thinhdinh25/INT3108_embedded-Smart-Parking-Project/report/bao_cao_smart_parking.tex

% =====================================================================
%  BÁO CÁO KỸ THUẬT — HỆ THỐNG BÃI ĐỖ XE THÔNG MINH
%  Môn: Lập trình nhúng (INT3108) — Trường ĐH Công nghệ, ĐHQGHN
%
%  Biên dịch (khuyến nghị XeLaTeX), tại thư mục report/:
%     xelatex bao_cao_smart_parking.tex   (chạy 2 lần để có mục lục)
%  hoặc:
%     tectonic bao_cao_smart_parking.tex
%  Trên Overleaf: tải cả thư mục report/ lên, Menu -> Compiler -> XeLaTeX.
%  Nội dung từng chương nằm trong report/chapters/.
% =====================================================================
\documentclass[12pt,letterpaper]{report}
% Mẫu báo cáo của môn: Times New Roman 13pt, giãn dòng 1,3, khổ Letter
\usepackage[fontsize=13pt]{scrextend}
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
\setlength{\parskip}{3pt}
\usepackage{float}
\usepackage[section]{placeins}
\usepackage{caption}
\usepackage{subcaption}
\captionsetup{font=small,labelfont=bf}
\usepackage{fancyhdr}
\usepackage{titlesec}
\usepackage{listings}
\usepackage{needspace}
\usepackage{tikz}
\usetikzlibrary{arrows.meta,positioning,shapes.geometric,shapes.misc,fit,calc,backgrounds}
\usepackage{xurl}
\usepackage[hidelinks]{hyperref}

% Chữ và tiêu đề đen trắng; logo, mã nguồn, hình vẽ và hộp "Lý do" dùng màu.
\definecolor{uetblue}{gray}{0}
\definecolor{accent}{RGB}{0,62,126}
\definecolor{codebg}{RGB}{246,247,249}
\definecolor{codekw}{RGB}{0,82,163}
\definecolor{codecm}{RGB}{90,120,90}
\definecolor{codestr}{RGB}{163,21,21}
\definecolor{boxA}{RGB}{225,236,250}
\definecolor{boxB}{RGB}{232,245,233}
\definecolor{boxC}{RGB}{255,243,224}
\definecolor{boxD}{RGB}{252,228,236}
\definecolor{boxE}{RGB}{237,231,246}

% Tiêu đề chương theo mẫu: "CHƯƠNG 1. ...", chữ đậm 18pt, căn giữa; phụ lục "PHỤ LỤC A. ..."
\newcommand{\chapprefix}{CHƯƠNG}
\titleformat{\chapter}[block]{\centering\bfseries\fontsize{18}{23}\selectfont}{\chapprefix~\thechapter.}{0.4em}{}
\titleformat{name=\chapter,numberless}[block]{\centering\bfseries\fontsize{18}{23}\selectfont}{}{0pt}{}
\titlespacing*{\chapter}{0pt}{-12pt}{18pt}
\usepackage{titletoc}
% Mục lục như mẫu: "CHƯƠNG 1. GIỚI THIỆU ĐỀ TÀI ..... 15"
\titlecontents{chapter}[0pt]{\addvspace{8pt}\bfseries}
  {\chapprefix~\thecontentslabel.\ }{}{\titlerule*[0.6pc]{.}\contentspage}
\titleformat{\section}{\fontsize{14}{18}\selectfont\bfseries}{\thesection.}{0.6em}{}
\titleformat{\subsection}{\normalsize\bfseries}{\thesubsection.}{0.6em}{}
\titleformat{\subsubsection}{\normalsize\bfseries\itshape}{\thesubsubsection.}{0.6em}{}
\setcounter{secnumdepth}{3}

% Mẫu chỉ có số trang ở giữa chân trang, trang bìa không đánh số
\pagestyle{fancy}
\fancyhf{}
\fancyfoot[C]{\thepage}
\renewcommand{\headrulewidth}{0pt}
\fancypagestyle{plain}{\fancyhf{}\fancyfoot[C]{\thepage}\renewcommand{\headrulewidth}{0pt}}

\lstset{
  basicstyle=\ttfamily\footnotesize,
  backgroundcolor=\color{codebg},
  keywordstyle=\color{codekw}\bfseries,
  commentstyle=\color{codecm}\itshape,
  stringstyle=\color{codestr},
  numbers=left, numberstyle=\tiny\color{gray}, numbersep=6pt,
  frame=single, rulecolor=\color{gray!40},
  breaklines=true, showstringspaces=false, tabsize=4,
  xleftmargin=1.5em, framexleftmargin=1.5em,
  captionpos=b, columns=fullflexible, keepspaces=true
}
\lstdefinelanguage{json}{
  morestring=[b]", stringstyle=\color{codestr},
  literate={:}{{\textcolor{codekw}{:}}}1 {,}{{\textcolor{codekw}{,}}}1
}
\lstdefinestyle{shell}{language=bash,numbers=none,backgroundcolor=\color{black!4},
  xleftmargin=0.5em,framexleftmargin=0.5em}
\renewcommand{\lstlistingname}{Mã nguồn}
\renewcommand{\lstlistlistingname}{Danh mục mã nguồn}

\newcommand{\codeus}{\textunderscore\allowbreak}
\newcommand{\code}[1]{{\ttfamily\let\_\codeus #1}}
\setlength{\emergencystretch}{3em}
\newcommand{\file}[1]{{\ttfamily\small\let\_\codeus #1}}

% Sơ đồ Mermaid (report/diagrams/*.mmd -> *.pdf, vector):
%   \mmd[tỉ lệ rộng][tỉ lệ cao tối đa]{tên}
% Tạo lại PDF: npx -p @mermaid-js/mermaid-cli mmdc -i diagrams/x.mmd -o diagrams/x.pdf -f
\NewDocumentCommand{\mmd}{O{1} O{0.6} m}{}
% Bảng đặc tả use case: cột trái là mục, cột phải là nội dung; \bul mở một dòng gạch đầu dòng
\newcommand{\bul}{\par\noindent\hangindent=0.9em\hangafter=1 --\hspace{0.4em}}
\newenvironment{ucspec}[2]{%
  \setstretch{1.0}\small
  \begin{longtable}{|>{\raggedright\arraybackslash}p{2.8cm}|>{\raggedright\arraybackslash}p{11.6cm}|}
  \caption{#1}\label{#2}\\ \hline \hd Mục & \hd Nội dung \\ \hline \endfirsthead
  \hline \hd Mục & \hd Nội dung \\ \hline \endhead
  \hline \endlastfoot}{\end{longtable}}

% Không để dòng đơn của một đoạn nằm tách ở đầu hoặc cuối trang
\widowpenalty=10000 \clubpenalty=10000 \displaywidowpenalty=10000

\begin{document}

% =====================================================================
%  TRANG BÌA (theo mẫu Template_baocao.docx)
% =====================================================================
\begin{titlepage}
  \setstretch{1.3}\centering
  % \vspace* phải đứng trước tikzpicture: tikzpicture mở đoạn mới, \vspace* sau đó không đẩy được dòng đầu xuống
  \vspace*{0.9cm}%
  \begin{tikzpicture}[remember picture,overlay]
    \draw[black,line width=3pt] ($(current page.north west)+(3cm,-2.49cm)$)
      rectangle ($(current page.south east)+(-2cm,3cm)$);
    \draw[black,line width=1pt] ($(current page.north west)+(3.15cm,-2.64cm)$)
      rectangle ($(current page.south east)+(-2.15cm,3.15cm)$);
  \end{tikzpicture}%
  {\fontsize{12}{16}\selectfont\bfseries TRƯỜNG ĐẠI HỌC CÔNG NGHỆ\par}
  \vspace{1.4cm}
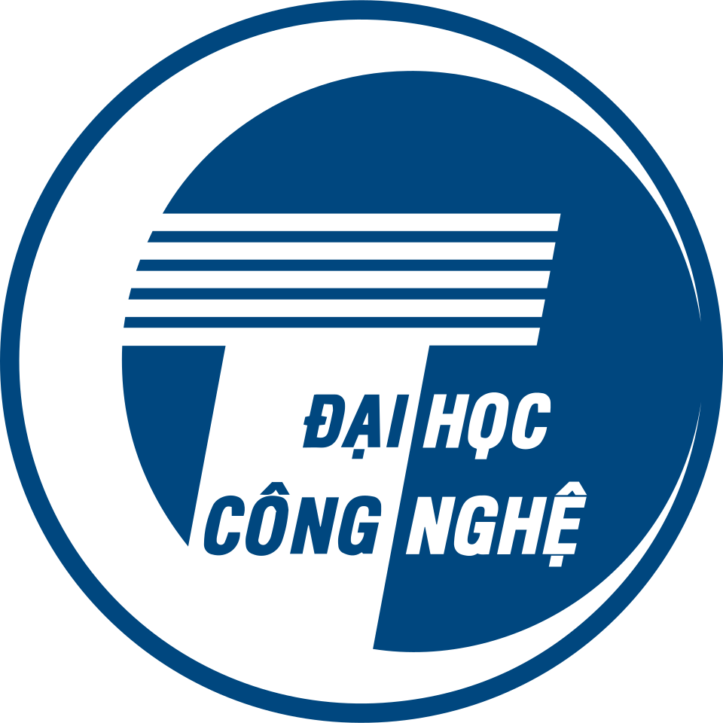
[picture p1: report/uet_logo.png]
  \par
  \vspace{1.9cm}
  {\fontsize{18}{24}\selectfont\bfseries BÁO CÁO KẾT THÚC HỌC PHẦN\par}
  {\fontsize{15}{20}\selectfont\bfseries \tenmon\par}
  \vspace{1.2cm}
  \begin{minipage}{0.86\linewidth}
    \fontsize{15}{21}\selectfont\bfseries
    Tên đề tài: \mdseries Hệ thống bãi đỗ xe thông minh sử dụng ESP32-C3 và ESP8266\par
    \vspace{0.3cm}
    \bfseries Danh sách thành viên:\par
    \mdseries
    \begin{tabular}{@{\hspace{1em}}ll@{}}
      \thanhvien
    \end{tabular}\par
    \vspace{0.3cm}
    \bfseries Giảng viên: \mdseries \giangvien\par
  \end{minipage}
  \vfill
  {\fontsize{15}{20}\selectfont\bfseries Hà Nội – 2026\par}
  \vspace{0.6cm}
\end{titlepage}

% Đánh số trang liên tục từ trang bìa như mẫu (trang bìa không in số)
\setcounter{page}{2}
\renewcommand{\contentsname}{MỤC LỤC}
\renewcommand{\listfigurename}{DANH SÁCH HÌNH VẼ}
\renewcommand{\listtablename}{DANH SÁCH BẢNG BIỂU}
\renewcommand{\bibname}{TÀI LIỆU THAM KHẢO}

\input{chapters/pl_donggop}

\chapter*{LỜI CẢM ƠN}
Nhóm xin gửi lời cảm ơn chân thành tới thầy \giangvien{}, giảng viên học phần \tenmon{},
đã tận tình giảng dạy và định hướng trong suốt quá trình học tập và thực hiện đề tài.
Những kiến thức về hệ điều hành thời gian thực, lập trình ngoại vi và giao tiếp không dây
từ học phần là nền tảng để nhóm xây dựng hệ thống bãi đỗ xe thông minh này.

Nhóm cũng cảm ơn Trường Đại học Công nghệ, Đại học Quốc gia Hà Nội đã tạo môi trường học
tập và điều kiện để nhóm thực hành, cùng các bạn trong lớp đã góp ý trong quá trình thử
nghiệm mô hình. Dù đã cố gắng, báo cáo khó tránh khỏi thiếu sót; nhóm rất mong nhận được
ý kiến đóng góp của thầy để hoàn thiện hơn.

\chapter*{LỜI CAM ĐOAN}
Nhóm xin cam đoan báo cáo và hệ thống được trình bày là kết quả làm việc của các thành viên
trong nhóm dưới sự hướng dẫn của thầy \giangvien{}. Mã nguồn, mô hình phần cứng, số liệu đo
và kết quả kiểm thử trong báo cáo là trung thực, do nhóm tự thực hiện. Các tài liệu, thư
viện và công cụ của bên thứ ba đều được ghi rõ nguồn trong báo cáo và trong phần tài liệu
tham khảo. Nhóm xin chịu hoàn toàn trách nhiệm về lời cam đoan này.

\vspace{1cm}
\noindent\hfill Hà Nội, tháng 11 năm 2026\par
\noindent\hfill Nhóm sinh viên thực hiện\hspace*{1cm}\par

\tableofcontents

\chapter*{DANH SÁCH THUẬT NGỮ VIẾT TẮT}
\addcontentsline{toc}{chapter}{DANH SÁCH THUẬT NGỮ VIẾT TẮT}
\begin{longtable}{|>{\raggedright\arraybackslash}m{2.4cm}|>{\raggedright\arraybackslash}m{11.8cm}|}
\hline
Viết tắt & Ý nghĩa \\ \hline
ACK & Acknowledgement, bản tin xác nhận đã nhận \\ \hline
ADC & Analog-to-Digital Converter, bộ chuyển đổi tương tự sang số \\ \hline
API & Application Programming Interface, giao diện lập trình ứng dụng \\ \hline
DMA & Direct Memory Access, truy cập bộ nhớ trực tiếp \\ \hline
GPIO & General Purpose Input/Output, chân vào ra đa dụng \\ \hline
HTTP(S) & HyperText Transfer Protocol (qua TLS) \\ \hline
IR & Infrared, hồng ngoại \\ \hline
JSON & JavaScript Object Notation \\ \hline
LEDC & LED Control, khối phát PWM phần cứng của ESP32 \\ \hline
mDNS & Multicast DNS, phân giải tên miền \code{.local} trong mạng cục bộ \\ \hline
NVS & Non-Volatile Storage, vùng lưu trữ khóa và giá trị trên flash \\ \hline
PWM & Pulse Width Modulation, điều chế độ rộng xung \\ \hline
RFID & Radio Frequency Identification, nhận dạng bằng sóng vô tuyến \\ \hline
RTOS & Real-Time Operating System, hệ điều hành thời gian thực \\ \hline
SPI & Serial Peripheral Interface, giao tiếp ngoại vi nối tiếp \\ \hline
TFT & Thin-Film Transistor, công nghệ màn hình tinh thể lỏng \\ \hline
UC & Use case, ca sử dụng \\ \hline
UDP & User Datagram Protocol \\ \hline
UID & Unique Identifier, mã định danh của thẻ RFID \\ \hline
VietQR & Chuẩn mã QR chuyển khoản liên ngân hàng của NAPAS \\
\hline
\end{longtable}

\cleardoublepage\phantomsection\addcontentsline{toc}{chapter}{DANH SÁCH BẢNG BIỂU}
{\setstretch{1.1}\listoftables}
\cleardoublepage\phantomsection\addcontentsline{toc}{chapter}{DANH SÁCH HÌNH VẼ}
{\setstretch{1.1}\listoffigures}

\input{chapters/c1_gioithieu}
\input{chapters/c2_coso}
\input{chapters/c3_thietke}
\input{chapters/c4_hienthuc}
\input{chapters/c5_kiemthu}
\input{chapters/kl_ketluan}

% =====================================================================
\chapter*{TÀI LIỆU THAM KHẢO}
\addcontentsline{toc}{chapter}{TÀI LIỆU THAM KHẢO}
\begin{enumerate}[label={[\arabic*]}]
\item Espressif Systems, \emph{ESP32-C3 Series Datasheet} và \emph{ESP32-C3 Technical
  Reference Manual}.
\item Espressif Systems, \emph{ESP-IDF Programming Guide} (v6.1): Wi-Fi, LEDC, SPI
  Master, LCD, NVS, HTTP Server, ESP Timer, FreeRTOS, Partition Tables.
\item Espressif Systems, \emph{mDNS component} (\code{espressif/mdns}), ESP Component
  Registry.
\item Espressif Systems, \emph{ESP8266EX Datasheet}.
\item ESP8266 Community, \emph{ESP8266 Arduino Core Documentation}.
\item Sitronix, \emph{ST7789V — 240RGB$\times$320 dot 262K Color TFT Controller}.
\item NXP Semiconductors, \emph{MFRC522 Standard Performance MIFARE and NTAG
  Frontend}, Product Data Sheet.
\item TowerPro, \emph{SG90 Micro Servo Datasheet}.
\item Aosong, \emph{DHT11 Humidity \& Temperature Sensor Datasheet}.
\item R.~Barry, \emph{Mastering the FreeRTOS Real Time Kernel}, Real Time Engineers Ltd.
\item S.~Cheshire, M.~Krochmal, \emph{RFC 6762: Multicast DNS}, IETF, 2013.
\item J.~A.~Storer, T.~G.~Szymanski, ``Data compression via textual substitution'',
  \emph{Journal of the ACM}, 29(4), 1982.
\item Thư viện \emph{MFRC522} (miguelbalboa) và \emph{DHT sensor library} (Adafruit)
  cho Arduino.
\item NAPAS, \emph{Đặc tả kỹ thuật mã QR chuyển tiền liên ngân hàng (VietQR)}, dựa trên EMVCo
  \emph{QR Code Specification for Payment Systems — Merchant-Presented Mode}.
\item SePay, \emph{SePay Developer Documentation}: API giao dịch, tài khoản ảo (VA).
\item Knowledge Sourcing Intelligence, \emph{Smart Parking Market}.
  \url{https://www.knowledge-sourcing.com/report/smart-parking-market}
\item Meticulous Research, \emph{Smart Parking Market}.
  \url{https://www.meticulousresearch.com/pressrelease/1052/smart-parking-market-2032}
\item KPS System, \emph{Giải pháp bãi giữ xe thông minh}.
  \url{https://kps.com.vn/en/tin-tuc/giai-phap-bai-giu-xe-thong-minh-399.html}
\item Hikvision, \emph{Parking Lots} và \emph{On-street Parking}.
  \url{https://www.hikvision.com/vn/solutions/solutions-by-scenario/parking-lots},
  \url{https://www.hikvision.com/vn/products/parking-management/on-street-parking/}
\item Nedap, \emph{Wireless vehicle detection system SENSIT}.
  \url{https://www.parking.net/parking-showcases/nedap-identification-systems/nedap-wireless-vehicle-detection-system-sensit-accurate-parking-occupancy-detection-system}
\item SKIDATA, \emph{The Benefits of Parking Guidance for Parking Operators}.
  \url{https://www.skidata.com/en-nordics/skidata-blog/parking-guidance-benefits-for-parking-operators}
\item FPT Shop, \emph{Có phần mềm giữ xe miễn phí nào không?}
  \url{https://fptshop.com.vn/tin-tuc/danh-gia/phan-mem-giu-xe-mien-phi-172797}
\item Việt Nam News, \emph{Hà Nội pilots iParking for cars from May} (28/3/2017) và \emph{Hà Nội expands iParking in July}.
  \url{https://vietnamnews.vn/society/373668/ha-noi-pilots-iparking-for-cars-from-may.html},
  \url{https://vietnamnews.vn/society/449045/ha-noi-expands-iparking-in-july.html}
\item VietNamNet, \emph{Hà Nội tạm dừng thí điểm mô hình trông giữ xe iParking từ 1/9}, 31/8/2020.
  \url{https://vietnamnet.vn/ha-noi-tam-dung-thi-diem-mo-hinh-trong-giu-xe-iparking-tu-19-i262776.html}
\item Mekong ASEAN, \emph{Từ 5/5 sẽ thu phí không dừng tại 5 sân bay lớn}.
  \url{https://mekongasean.vn/tu-55-se-thu-phi-khong-dung-tai-5-san-bay-lon-28091.html}
\item Tạp chí Luật sư Việt Nam, \emph{Hà Nội sẽ thu phí điện tử không dừng toàn bộ bãi đỗ xe từ ngày 01/7}, 25/5/2026.
  \url{https://lsvn.vn/ha-noi-se-thu-phi-dien-tu-khong-dung-toan-bo-bai-do-xe-tu-ngay-01-7-a173253.html}
\item Capterra, \emph{SKIDATA}. \url{https://www.capterra.com/p/141629/SKIDATA/alternatives/}
\end{enumerate}

\end{document}
