thinhdinh25/INT3108_embedded-Smart-Parking-Project/report/slides/slides.tex

% =====================================================================
%  SLIDE THUYẾT TRÌNH VÀ DEMO — HỆ THỐNG BÃI ĐỖ XE THÔNG MINH (INT3108)
%  Biên dịch tại thư mục report/slides/:   tectonic slides.tex
%  Ảnh, sơ đồ và bản vẽ dùng chung với báo cáo (../photos, ../diagrams, ../schematic).
% =====================================================================
\documentclass[aspectratio=169,11pt]{beamer}

\usepackage{fontspec}
\setsansfont{texgyreheros}[Extension=.otf,UprightFont=*-regular,
  BoldFont=*-bold,ItalicFont=*-italic,BoldItalicFont=*-bolditalic]
\setmonofont{DejaVuSansMono}[Extension=.ttf,BoldFont=*-Bold,Scale=0.86]
\usepackage[vietnamese,shorthands=off]{babel}
\usepackage{booktabs,tabularx,array}
\usepackage{tikz}
\usetikzlibrary{positioning,arrows.meta}
\graphicspath{{../}{../photos/}{../diagrams/}{../schematic/}}

% ---------- Giao diện ----------
\definecolor{uet}{RGB}{0,62,126}
\definecolor{ok}{RGB}{46,125,50}
\definecolor{warn}{RGB}{199,119,0}
\definecolor{bad}{RGB}{198,40,40}
\definecolor{soft}{RGB}{238,243,250}
\usetheme{default}
\setbeamercolor{frametitle}{fg=white,bg=uet}
\setbeamercolor{structure}{fg=uet}
\setbeamercolor{block title}{fg=white,bg=uet}
\setbeamercolor{block body}{bg=soft}
\setbeamerfont{frametitle}{size=\large,series=\bfseries}
\setbeamertemplate{navigation symbols}{}
\setbeamertemplate{itemize items}[circle]
\setbeamertemplate{blocks}[rounded][shadow=false]
\setbeamertemplate{frametitle}{%
  \nointerlineskip
  \begin{beamercolorbox}[wd=\paperwidth,ht=2.6ex,dp=1.2ex,leftskip=1.2em]{frametitle}
    \usebeamerfont{frametitle}\insertframetitle
  \end{beamercolorbox}}
\setbeamertemplate{footline}{%
  \hbox{\begin{beamercolorbox}[wd=\paperwidth,ht=2.4ex,dp=1ex,leftskip=1.2em,rightskip=1.2em]{}%
    \tiny\color{gray}INT3108 · Bãi đỗ xe thông minh\hfill\insertframenumber/\inserttotalframenumber
  \end{beamercolorbox}}}
\newcommand{\code}[1]{\texttt{#1}}
\newcommand{\bt}[1]{\rule[-0.7ex]{0pt}{3.1ex}#1}
\newcommand{\pill}[2]{\tikz[baseline=(t.base)]\node[fill=#1,text=white,rounded corners=2pt,
  inner sep=2pt,font=\scriptsize\bfseries](t){#2};}
% Bảng kẻ khung đầy đủ như trong báo cáo
\newcolumntype{L}[1]{>{\raggedright\arraybackslash}p{#1}}
\newcommand{\gridtable}{\renewcommand{\arraystretch}{1.3}}

\begin{document}

% ---------------------------------------------------------------------
\begin{frame}[plain]
\begin{tikzpicture}[remember picture,overlay]
  \fill[uet] (current page.north west) rectangle ([yshift=-4.1cm]current page.north east);
  \node[anchor=north west,inner sep=0] at ([xshift=1cm,yshift=-0.7cm]current page.north west)
    {};
  \node[anchor=north west,text=white,font=\LARGE\bfseries] at ([xshift=2.8cm,yshift=-0.75cm]current page.north west)
    {Hệ thống bãi đỗ xe thông minh};
  \node[anchor=north west,text=white!85!uet] at ([xshift=2.8cm,yshift=-1.7cm]current page.north west)
    {ESP32-C3 + ESP8266 · FreeRTOS · RFID · VietQR qua SePay};
  \node[anchor=north west,text=white!70!uet,font=\small] at ([xshift=2.8cm,yshift=-2.6cm]current page.north west)
    {Lập trình nhúng (INT3108) · GV: Trần Hoàng Việt};
  \node[anchor=south west,inner sep=0] at ([xshift=1cm,yshift=1.1cm]current page.south west) {%
    \begin{tabular}{@{}ll@{}}
      \multicolumn{2}{@{}l}{\small\color{uet}\textbf{Nhóm thực hiện}}\\[2pt]
      Nguyễn Chí Minh & 24020232 \\
      Đinh Đức Thịnh & 24020313 \\
      Nguyễn Việt Tiến & 24020322 \\
    \end{tabular}};
  \node[anchor=south east,inner sep=0] at ([xshift=-1cm,yshift=0.7cm]current page.south east)
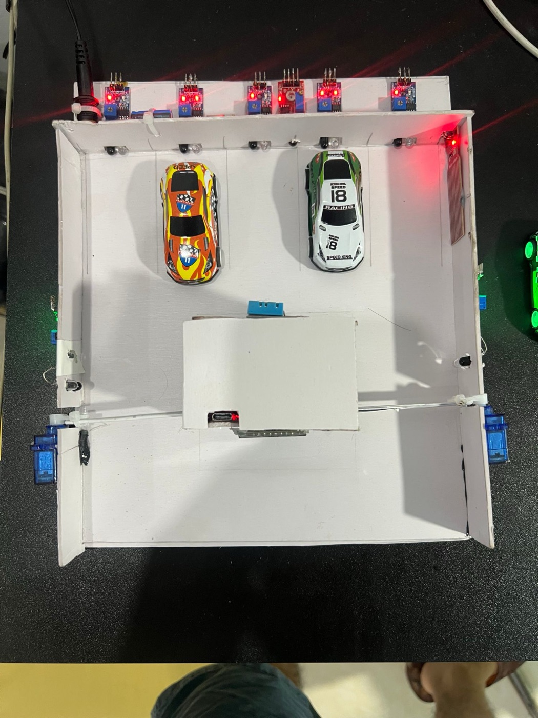
[picture p8: report/photos/model_top.jpg]
    {};
\end{tikzpicture}
\end{frame}

% ---------------------------------------------------------------------
\begin{frame}{Nội dung}
\begin{columns}[T]
\column{0.48\textwidth}
\begin{enumerate}
  \item Bài toán và mục tiêu
  \item Sản phẩm: mô hình thực tế
  \item Kiến trúc, phần cứng và mạch điện
  \item Giao thức truyền thông
\end{enumerate}
\column{0.48\textwidth}
\begin{enumerate}\setcounter{enumi}{4}
  \item 10 use case của hệ thống
  \item \textbf{Demo trực tiếp theo use case}
  \item Kiểm thử và kết quả
  \item Phân công
\end{enumerate}
\end{columns}
\end{frame}

% ---------------------------------------------------------------------
\begin{frame}{Bài toán và mục tiêu}
\begin{columns}[T]
\column{0.42\textwidth}
\begin{block}{\bt{Bãi xe nhỏ hiện nay}}
\small
\begin{itemize}
  \item Người lái không biết trước còn chỗ trống
  \item Phí gửi xe tính và thu bằng tay
  \item Cháy, ngập thường chỉ được phát hiện khi đã lan rộng
\end{itemize}
\end{block}
\vspace{6pt}
\small Sản phẩm: mô hình bãi \textbf{5 chỗ, 2 cổng có thanh chắn}, điều khiển bởi ba vi điều khiển Wi-Fi.
\column{0.55\textwidth}
\begin{block}{\bt{Mục tiêu: tự động hóa trọn vẹn một bãi xe nhỏ}}
\small
\begin{itemize}
  \item \textbf{Không cần người trực cổng:} người lái tự gửi xe, tự thanh toán VietQR, tự ra bãi
  \item \textbf{Phản hồi tức thời:} màn hình tại cổng dưới 0,2\,s, trang web khoảng 1\,s
  \item \textbf{An toàn trên hết:} có cháy mở cả hai cổng, có ngập ngừng nhận xe, không hạ thanh chắn xuống xe
  \item \textbf{Chi phí thấp:} linh kiện phổ thông, phần mềm mã nguồn mở
\end{itemize}
\end{block}
\end{columns}
\end{frame}

% ---------------------------------------------------------------------
\begin{frame}{Sản phẩm: mô hình thực tế}
\centering
\begin{tabular}{@{}*{4}{>{\centering\arraybackslash}p{0.23\textwidth}}@{}}
 &
 &
 &
 \\[2pt]
\scriptsize Nhìn từ trên: 5 ô, 2 làn & \scriptsize Sensor Client: 5 IR, lửa, nước & \scriptsize Cổng ra: servo và IR cổng & \scriptsize Màn hình TFT tại cổng
\end{tabular}
\vspace{8pt}

\small Hộp điều khiển ở giữa bãi chứa máy chủ ESP32-C3, còi và RFID Client; hai đầu đọc thẻ gắn ở hai thành hộp, mỗi đầu đọc phục vụ một làn.
\end{frame}

% ---------------------------------------------------------------------
\begin{frame}{Kiến trúc tổng thể}
\begin{columns}[c]
\column{0.5\textwidth}
\centering

\column{0.48\textwidth}
\small
\begin{itemize}
  \item Ba thiết bị cùng nối vào router Wi-Fi của bãi, chế độ station
  \item Sensor Client, RFID Client gửi \textbf{UDP broadcast} tới cổng 3333, không cần biết IP máy chủ
  \item Người vận hành mở \code{parking.local} (mDNS) trên điện thoại hoặc máy tính
  \item Router là đường ra Internet để máy chủ hỏi giao dịch trên \textbf{SePay} qua HTTPS
  \item Tách theo vị trí: đầu đọc thẻ ở cổng, cảm biến trong bãi, máy chủ ở vị trí điều hành
\end{itemize}
\end{columns}
\end{frame}

% ---------------------------------------------------------------------
\begin{frame}{Phần cứng: ba thiết bị}
\small\gridtable
\begin{tabularx}{\linewidth}{|L{3.2cm}|L{5.2cm}|X|}
\hline
\textbf{Thiết bị} & \textbf{Linh kiện} & \textbf{Nhiệm vụ} \\ \hline
\textbf{Máy chủ} ESP32-C3 & TFT ST7789 240×240, 2 servo SG90, còi, 2 IR dưới thanh chắn &
  Phiên gửi xe, tính phí, VietQR và SePay, thanh chắn, trang web \\ \hline
\textbf{Sensor Client} ESP8266 & 5 IR ô đỗ, cảm biến lửa, cảm biến mực nước &
  Lọc nhiễu 50\,ms, gửi trạng thái khi có thay đổi và mỗi 1\,s \\ \hline
\textbf{RFID Client} ESP8266 & 2 đầu đọc MFRC522 dùng chung bus SPI, DHT11 &
  Gửi sự kiện quẹt thẻ có xác nhận, nhiệt độ mỗi 5\,s \\ \hline
\end{tabularx}
\vspace{8pt}
\begin{columns}[T]
\column{0.49\textwidth}
\begin{block}{\bt{Vì sao ESP32-C3 cho máy chủ?}}
\scriptsize Riêng ảnh màn hình đã cần $240\times240\times2 = 115\,200$\,B RAM, lớn hơn toàn bộ RAM của ESP8266.
ESP32-C3 có 400\,KB SRAM, SPI có DMA, PWM phần cứng và FreeRTOS.
\end{block}
\column{0.49\textwidth}
\begin{block}{\bt{Vì sao nguồn 5\,V (jack DC 5,5\,mm)?}}
\scriptsize SG90 cần 4,8--6\,V; ESP32-C3 có sẵn ổn áp 3,3\,V nên một nguồn 5\,V đủ cho cả hệ thống.
Mỗi client hạ áp bằng 2 diode 1N4007: $5 - 2\times0{,}7 \approx 3{,}6$\,V.
\end{block}
\end{columns}
\end{frame}

% ---------------------------------------------------------------------
\begin{frame}{Mạch điện của ba thiết bị}
\centering
\begin{tabular}{@{}*{3}{>{\centering\arraybackslash}p{0.31\textwidth}}@{}}
 &
 &
 \\[2pt]
\scriptsize Máy chủ: C1--C4 lọc nguồn, tụ riêng cho servo & \scriptsize Sensor Client: 2 diode hạ áp, bảo vệ ngược cực & \scriptsize RFID Client: 2 RC522 chung bus SPI
\end{tabular}
\end{frame}

% ---------------------------------------------------------------------
\begin{frame}{Giao thức truyền thông}
\begin{columns}[T]
\column{0.58\textwidth}
\scriptsize\gridtable
\begin{tabularx}{\linewidth}{|L{2.3cm}|L{2.2cm}|X|}
\hline
\textbf{Bản tin UDP} & \textbf{Chiều gửi} & \textbf{Nội dung} \\ \hline
\code{parking\_update} & Sensor Client tới máy chủ & 5 ô đỗ, mực nước, cờ cháy \\ \hline
\code{climate} & RFID Client tới máy chủ & Nhiệt độ \\ \hline
\code{rfid\_event} & RFID Client tới máy chủ & Mã thẻ, cổng, số thứ tự \code{seq} \\ \hline
\code{rfid\_ack} & Máy chủ tới RFID Client & \code{seq} được xác nhận \\ \hline
\end{tabularx}
\column{0.4\textwidth}
\small
\begin{itemize}
  \item Trạng thái gửi lặp mỗi giây: mất một gói chỉ trễ tối đa 1\,s
  \item Quẹt thẻ chỉ xảy ra một lần: chưa có ACK thì gửi lại sau 300\,ms, tối đa 6 lần
  \item Máy chủ nhớ 16 \code{seq} gần nhất nên gói gửi lại \textbf{không mở cổng hai lần}
  \item Trang web dùng HTTP, lệnh điều khiển cần mã PIN
\end{itemize}
\end{columns}
\end{frame}

% ---------------------------------------------------------------------
\begin{frame}{10 use case của hệ thống}
\scriptsize\gridtable
\begin{tabularx}{\linewidth}{|c|L{5.2cm}|L{2.4cm}|X|}
\hline
\textbf{Mã} & \textbf{Use case} & \textbf{Tác nhân chính} & \textbf{Mục tiêu} \\ \hline
UC01 & Xem chỗ trống tại cổng & Người lái xe & Biết còn chỗ nào trống trước khi vào \\ \hline
UC02 & Gửi xe bằng thẻ RFID & Người lái xe & Được mở cổng vào, bắt đầu tính giờ \\ \hline
UC03 & Thanh toán phí và lấy xe & Người lái xe & Trả đúng phí bằng VietQR, được mở cổng ra \\ \hline
UC04 & Xác nhận thanh toán tại quầy & Người vận hành & Cho xe ra khi khách trả tiền mặt \\ \hline
UC05 & Điều khiển thanh chắn từ xa & Người vận hành & Mở hoặc đóng cổng khi cần \\ \hline
UC06 & Báo cháy và mở lối thoát & Sensor Client & Báo động, giải phóng lối ra \\ \hline
UC07 & Báo ngập và ngừng nhận xe & Sensor Client & Không cho thêm xe vào khi nước dâng \\ \hline
UC08 & Xem tình trạng bãi trên trang web & Người vận hành & Nắm trạng thái bãi từ xa \\ \hline
UC09 & Tra cứu nhật ký và doanh thu & Người vận hành & Đối soát lượt xe và tiền thu \\ \hline
UC10 & Hiệu chỉnh danh sách xe trong bãi & Người vận hành & Xóa xe đã rời bãi bất thường \\ \hline
\end{tabularx}
\end{frame}

% ---------------------------------------------------------------------
\begin{frame}{UC02: gửi xe bằng thẻ RFID}
\begin{columns}[c]
\column{0.5\textwidth}
\centering

\column{0.48\textwidth}
\small
\begin{itemize}
  \item Người lái chỉ quẹt thẻ, mọi bước còn lại do hệ thống tự làm
  \item Từ chối khi thẻ đã ở trong bãi (\code{WRONG GATE}), bãi đầy hoặc đang ngập
  \item Mất gói tin: gửi lại sau 300\,ms, máy chủ nhận ra bản gửi lại qua \code{seq}
  \item Xe còn dưới cần chắn: thanh chắn giữ mở tới khi làn trống liên tục 1\,s
  \item Xe đi theo không quẹt thẻ: còi kêu, màn hình báo \code{CAR W/O CARD}
\end{itemize}
\end{columns}
\end{frame}

% ---------------------------------------------------------------------
\begin{frame}{UC03: thanh toán phí và lấy xe}
\begin{columns}[c]
\column{0.56\textwidth}
\centering

\column{0.42\textwidth}
\small
\begin{itemize}
  \item Phí $= 5000 \times \max(1, \lceil t/3600 \rceil)$ VNĐ, chốt ngay khi quẹt thẻ ra
  \item Mã VietQR sinh ngay trên chip; số tiền và nội dung \code{PKxxxxxx} điền sẵn
  \item Máy chủ hỏi SePay mỗi 3\,s, chỉ mở cổng khi đúng mã và đúng số tiền
  \item Quá 180\,s chưa nhận tiền: chuyển sang UC04, người vận hành xác nhận
\end{itemize}
\end{columns}
\end{frame}

% ---------------------------------------------------------------------
\begin{frame}{UC06 và UC07: an toàn khi có sự cố}
\begin{columns}[T]
\column{0.49\textwidth}
\begin{block}{\bt{Cháy (UC06)}}
\small
\begin{itemize}
  \item Lửa ổn định 50\,ms: Sensor Client gửi ngay, không chờ chu kỳ
  \item Còi kêu, \textbf{mở và giữ cả hai thanh chắn}
  \item TFT và web chuyển sang cảnh báo đỏ; lệnh đóng bị từ chối
  \item Từ lúc có lửa tới còi kêu khoảng 0,06\,s
\end{itemize}
\end{block}
\column{0.49\textwidth}
\begin{block}{\bt{Ngập (UC07)}}
\small
\begin{itemize}
  \item Bật cảnh báo ở 20\,mm, tắt ở 15\,mm để không nhấp nháy
  \item Còi kêu, \textbf{từ chối xe vào}; xe trong bãi vẫn ra được
\end{itemize}
\end{block}
\vspace{4pt}
\begin{block}{\bt{Không hạ thanh chắn xuống xe}}
\small IR dưới mỗi thanh chắn: hết 3\,s mà xe còn trong cổng thì giữ mở, chỉ đóng khi làn trống liên tục 1\,s.
\end{block}
\end{columns}
\end{frame}

% ---------------------------------------------------------------------
\begin{frame}{UC04, UC05, UC08--UC10: trang web quản lý}
\begin{columns}[c]
\column{0.62\textwidth}
\centering
\\[3pt]

\column{0.36\textwidth}
\small
\begin{itemize}
  \item \textbf{UC08:} sơ đồ 5 ô, nhiệt độ, mực nước, lửa, thanh chắn
  \item \textbf{UC05:} mở, đóng từng cổng hoặc cả hai (cần mã PIN)
  \item \textbf{UC04:} xác nhận đã nhận tiền mặt
  \item \textbf{UC09:} xe trong bãi, 10 sự kiện gần nhất, doanh thu hôm nay và 7 ngày
  \item \textbf{UC10:} xóa xe đã rời bãi bất thường
\end{itemize}
\end{columns}
\end{frame}

% ---------------------------------------------------------------------
\begin{frame}{Demo trực tiếp (1/2): luồng của người lái xe}
\scriptsize\gridtable
\begin{tabularx}{\linewidth}{|c|c|L{5.6cm}|X|}
\hline
\textbf{Bước} & \textbf{UC} & \textbf{Thao tác} & \textbf{Kết quả mong đợi} \\ \hline
1 & UC08 & Cấp nguồn ba thiết bị, mở \code{http://parking.local} trên điện thoại & TFT và web hiện 5/5 chỗ trống, Sensor Client trực tuyến \\ \hline
2 & UC01 & Đặt xe vào ô S2 và S4 & Hai ô chuyển đỏ, còn 3/5: TFT tức thì, web khoảng 1\,s \\ \hline
3 & UC02 & Quẹt thẻ ở cổng vào, giữ xe dưới cần chắn quá 3\,s & Cổng mở; chỉ đóng khi làn trống 1\,s; nhật ký ghi \code{IN} \\ \hline
4 & UC02 & Quẹt lại chính thẻ đó ở cổng vào & \textcolor{bad}{\code{WRONG GATE}}, cổng không mở \\ \hline
5 & UC03 & Quẹt thẻ ở cổng ra & TFT hiện mã VietQR, số tiền, mã \code{PKxxxxxx}; cổng vẫn đóng \\ \hline
6 & UC03 & Quét mã bằng app ngân hàng, chuyển khoản & Trong vài giây: cổng ra mở, hóa đơn, doanh thu tăng \\ \hline
\end{tabularx}
\end{frame}

% ---------------------------------------------------------------------
\begin{frame}{Demo trực tiếp (2/2): sự cố và quản lý}
\scriptsize\gridtable
\begin{tabularx}{\linewidth}{|c|c|L{5.6cm}|X|}
\hline
\textbf{Bước} & \textbf{UC} & \textbf{Thao tác} & \textbf{Kết quả mong đợi} \\ \hline
7 & UC05 & Trên web nhập PIN, bấm \code{OPEN} rồi \code{CLOSE} khi tay chắn tia IR & Cổng mở; lệnh đóng bị từ chối, web báo \code{CAR IN GATE} \\ \hline
8 & UC06 & Đưa bật lửa gần cảm biến lửa & Còi kêu, cả hai cổng mở, TFT và web cảnh báo đỏ \\ \hline
9 & UC07 & Nhúng cảm biến mực nước & Cảnh báo ngập; quẹt thẻ ở cổng vào bị từ chối \\ \hline
10 & UC04 & Quẹt thẻ ra, bấm \code{Confirm paid} trên web & Cổng ra mở, hóa đơn như khi chuyển khoản \\ \hline
11 & UC09, UC10 & Xem nhật ký, doanh thu; bấm \code{Delete} một xe & Danh sách và doanh thu khớp; xe bị xóa, không tính phí \\ \hline
\end{tabularx}
\vspace{6pt}
\begin{block}{\bt{Phương án dự phòng}}
\scriptsize Không có Internet: thu tiền theo UC04. Điện thoại không mở được \code{parking.local} (một số điểm phát Wi-Fi chặn mDNS): dùng địa chỉ IP in trên nhật ký khởi động của máy chủ.
\end{block}
\end{frame}

% ---------------------------------------------------------------------
\begin{frame}{Kiểm thử và kết quả}
\begin{columns}[T]
\column{0.5\textwidth}
\scriptsize\gridtable
\begin{tabularx}{\linewidth}{|X|c|}
\hline
\textbf{Bộ kiểm thử tự động} & \textbf{Kết quả} \\ \hline
\code{rfid\_session}: phiên, phí, QR, ngập, doanh thu & 181/181 \\ \hline
\code{gif\_frames}: ảnh động & 89/89 \\ \hline
\code{json\_parsers}: kiểm tra bản tin & 78/78 \\ \hline
\code{payment}: VietQR, SePay & 38/38 \\ \hline
\code{rfid\_client}, \code{sensor\_client} & 43/43 \\ \hline
\code{gate\_hold}: giữ thanh chắn & 10/10 \\ \hline
\textbf{Tổng} & \textbf{439/439} \\ \hline
\end{tabularx}
\column{0.47\textwidth}
\small
\begin{itemize}
  \item Chạy trên máy tính, không cần phần cứng: \code{make -C tests}
  \item Kịch bản trên mô hình: cả 10 use case đều đạt
  \item Độ trễ: xe vào ô tới TFT khoảng 0,1\,s; quẹt thẻ tới mở cổng khoảng 0,2\,s
  \item Firmware máy chủ 1,3\,MB, khoảng 85\% phân vùng ứng dụng
\end{itemize}
\end{columns}
\end{frame}

% ---------------------------------------------------------------------
\begin{frame}{Phân công}
\small
\begin{columns}[T]
\column{0.32\textwidth}
\begin{block}{\bt{Nguyễn Chí Minh}}
\scriptsize Phần mềm
\begin{itemize}
  \item Firmware máy chủ, FreeRTOS
  \item UDP, HTTP, màn hình
  \item VietQR, SePay, bảo mật
  \item Trang web, kiểm thử tự động
\end{itemize}
\end{block}
\column{0.32\textwidth}
\begin{block}{\bt{Đinh Đức Thịnh}}
\scriptsize Điện
\begin{itemize}
  \item Chọn linh kiện
  \item Thiết kế nguồn, tụ lọc, diode hạ áp
  \item Sơ đồ nguyên lý, đi dây
  \item Firmware Sensor Client, RFID Client
\end{itemize}
\end{block}
\column{0.32\textwidth}
\begin{block}{\bt{Nguyễn Việt Tiến}}
\scriptsize Cơ khí
\begin{itemize}
  \item Mô hình bãi xe, hộp điều khiển
  \item Cơ cấu thanh chắn, cảm biến cổng
  \item Firmware thanh chắn và còi
  \item Kịch bản kiểm thử trên mô hình
\end{itemize}
\end{block}
\end{columns}
\end{frame}

% ---------------------------------------------------------------------
\begin{frame}[plain]
\begin{tikzpicture}[remember picture,overlay]
  \fill[uet] (current page.south west) rectangle (current page.north east);
  \node[text=white,font=\Huge\bfseries] at ([yshift=0.6cm]current page.center) {Cảm ơn thầy và các bạn!};
  \node[text=white!80!uet,font=\large] at ([yshift=-0.5cm]current page.center) {Hỏi và đáp};
\end{tikzpicture}
\end{frame}

\end{document}
