thinhdinh25/INT3108_embedded-Smart-Parking-Project/report/chapters/c2_coso.tex

% =====================================================================
\chapter{CƠ SỞ LÝ THUYẾT VÀ CÔNG NGHỆ SỬ DỤNG}\label{chap:coso}
% =====================================================================

\section{Hệ thống nhúng và hệ điều hành thời gian thực}
Hệ thống nhúng là hệ thống máy tính chuyên dụng được gắn vào một thiết bị lớn hơn để thực
hiện một nhóm chức năng cố định, chạy liên tục với tài nguyên hạn chế và giao tiếp trực tiếp
với thế giới thực qua cảm biến và cơ cấu chấp hành. Thành phần trung tâm là vi điều khiển,
tích hợp CPU, bộ nhớ và các khối ngoại vi như GPIO, bộ định thời, PWM, SPI, ADC và Wi-Fi trên
cùng một chip. Một hệ thống nhúng được gọi là thời gian thực khi tính đúng đắn phụ thuộc cả
vào thời điểm có kết quả. Trong đề tài, thanh chắn phải đóng đúng thời hạn, cảnh báo cháy
phải mở thanh chắn ngay và màn hình phải phản ánh chỗ trống gần như tức thời. Đây là các
ràng buộc thời gian mềm: trễ một chút không gây hỏng hóc nhưng làm giảm chất lượng dịch vụ.

FreeRTOS là nhân hệ điều hành thời gian thực mã nguồn mở được Espressif tích hợp sẵn trong
ESP-IDF. Mỗi công việc được tổ chức thành một tác vụ có ngăn xếp và mức ưu tiên riêng; bộ
lập lịch ưu tiên có chiếm quyền luôn chạy tác vụ sẵn sàng có ưu tiên cao nhất. Tác vụ chờ sự
kiện như gói tin đến hay thông báo từ tác vụ khác không tiêu tốn thời gian CPU. Để chia sẻ
dữ liệu an toàn, FreeRTOS cung cấp vùng găng (critical section) cho các đoạn mã rất ngắn,
mutex cho tài nguyên bị chiếm giữ lâu như bus SPI, và thông báo tác vụ (task notification)
như cơ chế đánh thức nhẹ nhất giữa hai tác vụ. Ngoài ra, bộ hẹn giờ \code{esp\_timer} cho
phép gọi một hàm sau một khoảng thời gian với độ phân giải micro giây.

Máy chủ của hệ thống phải đồng thời nhận gói tin, phục vụ trang web, vẽ màn hình và điều
khiển thanh chắn; nếu viết trong một vòng lặp duy nhất, một thao tác chậm như vẽ toàn màn
hình (khoảng 23\,ms) sẽ làm trễ mọi việc khác. FreeRTOS cho phép việc quan trọng như điều
khiển cổng luôn được thực thi trước việc trang trí như ảnh động. Ngược lại, Sensor Client và
RFID Client chỉ thực hiện tuần tự vài thao tác ngắn, nên một vòng lặp không chặn trên nền Arduino là đủ
và đơn giản hơn.

\section{Vi điều khiển}
Hệ thống gồm ba thiết bị: máy chủ dùng ESP32-C3, Sensor Client và RFID Client dùng ESP8266.
Bảng~\ref{tab:mcu} so sánh ESP32-C3, được chọn cho máy chủ, với các phương án thường gặp.

\begin{table}[!htb]
\centering\small
\caption{So sánh các phương án vi điều khiển}\label{tab:mcu}
\begin{tabularx}{\linewidth}{|l|>{\raggedright\arraybackslash}X|>{\raggedright\arraybackslash}X|>{\raggedright\arraybackslash}X|>{\raggedright\arraybackslash}X|}
\hline
\hd Tiêu chí & \hd ESP32-C3 & \hd ESP32 & \hd ESP8266 & \hd Arduino Uno \\ \hline
CPU & RISC-V 160\,MHz & 2 nhân 240\,MHz & Xtensa 80\,MHz & AVR 16\,MHz \\ \hline
SRAM & 400\,KB & 520\,KB & Khoảng 80\,KB & 2\,KB \\ \hline
Wi-Fi & Có & Có & Có & Không \\ \hline
PWM phần cứng & LEDC 14 bit & LEDC & PWM mềm & 8 bit \\ \hline
SPI có DMA & Có & Có & Hạn chế & Không \\ \hline
RTOS chính thức & FreeRTOS & FreeRTOS & Hạn chế & Không \\
\hline
\end{tabularx}
\end{table}

Phân tích trong Bảng~\ref{tab:mcu} cho thấy yếu tố quyết định là bộ nhớ: riêng ảnh màn hình
$240\times240$ điểm, mỗi điểm 16 bit, đã cần $115\,200$ byte RAM, lớn hơn toàn bộ RAM của
ESP8266 hay Arduino Uno. ESP32-C3 SuperMini có đủ RAM, có DMA cho SPI để CPU không phải chờ
khi truyền ảnh, có khối PWM phần cứng giữ xung servo ổn định khi CPU bận xử lý mạng, và được
hỗ trợ chính thức bởi ESP-IDF cùng FreeRTOS. So với ESP32 bản gốc, ESP32-C3 rẻ và nhỏ hơn
($22\times18$\,mm) trong khi một nhân 160\,MHz vẫn dư năng lực cho bài toán.

Sensor Client và RFID Client dùng ESP8266 vì nhiệm vụ của chúng đơn giản: đọc cảm biến hoặc
đầu đọc thẻ rồi gửi bản tin ngắn qua Wi-Fi. ESP8266 có giá thấp, phổ biến và có sẵn thư viện
cho RC522 và DHT11. Hệ thống được tách thành ba thiết bị theo vị trí lắp đặt: đầu đọc thẻ đặt
tại cổng, cảm biến ô đỗ và cảm biến môi trường phân bố trong bãi, còn máy chủ đặt tại vị trí
điều hành. Mỗi client nằm gần nhóm cảm biến của nó nên dây tín hiệu ngắn, các thiết bị chỉ liên
lạc với nhau qua Wi-Fi, và khi mở rộng bãi chỉ cần bổ sung client mà không phải kéo thêm dây
về máy chủ.

\section{Cảm biến và cơ cấu chấp hành}
Các cảm biến và cơ cấu chấp hành được chọn theo hai tiêu chí: giá thành thấp và làm việc ở
mức logic 3,3\,V. Bảng~\ref{tab:linhkien} tổng hợp thông số chính và vai trò của
từng linh kiện trong hệ thống.

\begin{table}[!htb]
\centering\small
\caption{Cảm biến, cơ cấu chấp hành và thông số chính}\label{tab:linhkien}
\begin{tabularx}{\linewidth}{|>{\raggedright\arraybackslash}m{3.4cm}|>{\raggedright\arraybackslash}m{4.6cm}|>{\raggedright\arraybackslash}m{2.4cm}|>{\raggedright\arraybackslash}X|}
\hline
\hd Linh kiện & \hd Thông số chính & \hd Tín hiệu & \hd Vai trò \\ \hline
Cảm biến hồng ngoại phản xạ $\times7$ & Tầm 2--30\,cm, bộ so sánh LM393 & Digital & 5 ô đỗ và 2 cổng \\ \hline
Cảm biến lửa & Bước sóng 760--1100\,nm & Digital & Phát hiện cháy \\ \hline
Cảm biến mực nước & Vùng đo khoảng 40\,mm & Analog & Phát hiện ngập \\ \hline
Đầu đọc RFID MFRC522 $\times2$ & Chuẩn ISO 14443A, thẻ MIFARE & Digital (SPI) & Đọc thẻ ở hai cổng \\ \hline
Cảm biến DHT11 & 0--50\,°C, sai số $\pm2$\,°C & Digital (một dây) & Nhiệt độ môi trường \\ \hline
Servo SG90 $\times2$ & 4,8--6\,V, mô-men khoảng 1,8\,kg$\cdot$cm & Digital (PWM) & Nâng hạ thanh chắn \\ \hline
Màn hình TFT ST7789 & 1,54 inch, $240\times240$, IPS & Digital (SPI) & Hiển thị tại cổng \\ \hline
Còi báo (module) & Điện áp 3,3--5\,V & Digital & Báo cháy, ngập, xe không thẻ \\
\hline
\end{tabularx}
\end{table}

Bảng~\ref{tab:linhkien} cho thấy phần lớn linh kiện giao tiếp bằng tín hiệu digital. Trong
một bãi đỗ thực tế, cảm biến tại ô đỗ chỉ cần trả lời ô đó có xe hay không, nên tín hiệu
digital là đủ; khi triển khai ở bãi lớn, cảm biến hồng ngoại có thể được thay bằng cảm biến từ
trường hoặc siêu âm gắn trần mà không phải thay đổi phần còn lại, vì máy chủ chỉ nhận trạng
thái có hoặc không có xe. Cảm biến lửa cho tín hiệu digital để hệ thống phản ứng ngay khi xuất
hiện ngọn lửa. Ngược lại, cảm biến mực nước cho tín hiệu analog, cho phép máy chủ hiển thị mực
nước và so sánh với một ngưỡng có thể điều chỉnh theo từng bãi.

\section{Giao thức mạng và thanh toán}
Các thiết bị của hệ thống và điện thoại của người vận hành liên lạc qua một mạng Wi-Fi chung. Hệ thống sử
dụng các giao thức sau:
\begin{itemize}
  \item Wi-Fi 802.11 b/g/n băng tần 2,4\,GHz ở chế độ station (STA), địa chỉ IP do router cấp qua DHCP;
  \item UDP, giao thức không kết nối, độ trễ thấp, cho phép gửi quảng bá (broadcast) tới mọi
        thiết bị trong mạng nên các client không cần biết địa chỉ của máy chủ;
  \item HTTP cho trang web quản lý và các API dạng JSON, HTTPS khi máy chủ truy vấn SePay;
  \item mDNS để phân giải tên \code{parking.local} trong mạng cục bộ mà không cần máy chủ DNS;
  \item VietQR, chuẩn mã QR chuyển khoản liên ngân hàng của NAPAS dựa trên chuẩn EMVCo, gồm
        chuỗi các trường dạng mã, độ dài và giá trị, kết thúc bằng mã kiểm tra CRC16.
\end{itemize}

Wi-Fi ở chế độ station được chọn vì cả ESP32-C3 và ESP8266 đều tích hợp sẵn Wi-Fi, nên không
cần thêm module truyền thông hay kéo dây tín hiệu giữa các thiết bị. Khi cùng nối vào router của
bãi, các thiết bị vừa liên lạc được với nhau vừa có đường ra Internet để máy chủ truy vấn SePay.
Băng tần 2,4\,GHz là bắt buộc vì hai loại vi điều khiển không hỗ trợ băng 5\,GHz; bù lại, sóng
2,4\,GHz xuyên tường tốt hơn, phù hợp với bãi xe có nhiều vách ngăn.

UDP được chọn thay cho TCP hay MQTT vì phần lớn dữ liệu là trạng thái được gửi lặp lại mỗi
giây: mất một gói chỉ làm trễ tối đa một giây, trong khi chi phí bắt tay, bộ đệm cho mỗi kết
nối và máy chủ trung gian (broker) là đáng kể trên vi điều khiển. Khả năng gửi quảng bá của UDP
còn giúp client không cần cấu hình địa chỉ của máy chủ. Riêng sự kiện quẹt thẻ không được gửi
lặp lại, nên hệ thống bổ sung cơ chế xác nhận và gửi lại ở tầng ứng dụng (Mục~\ref{sec:ack}).

HTTP được chọn cho giao diện quản lý vì mọi trình duyệt trên điện thoại và máy tính đều hỗ trợ,
người vận hành không phải cài ứng dụng; dữ liệu trả về dạng JSON được JavaScript trong trang
đọc trực tiếp. Riêng kết nối tới SePay đi qua Internet và mang khóa truy cập, nên bắt buộc dùng
HTTPS để mã hóa. mDNS được chọn vì router của bãi cấp địa chỉ IP động qua DHCP: thay vì phải tra
địa chỉ mỗi khi máy chủ khởi động lại, người vận hành luôn dùng một tên cố định mà không cần cài
đặt máy chủ DNS. Cuối cùng, VietQR được chọn vì đây là chuẩn chung mà mọi ngân hàng và phần lớn
ví điện tử tại Việt Nam đều quét được, mã có thể được sinh ngay trên vi điều khiển, và số tiền
cùng nội dung chuyển khoản được điền sẵn nên người lái không phải nhập tay.

\section{Công cụ phát triển}
Toàn bộ phần mềm sử dụng trong đề tài là miễn phí và mã nguồn mở. Bảng~\ref{tab:software}
liệt kê các thành phần chính.

\begin{table}[!htb]
\centering\small
\caption{Thành phần phần mềm và vai trò}\label{tab:software}
\begin{tabularx}{\linewidth}{|>{\raggedright\arraybackslash}m{4.6cm}|>{\raggedright\arraybackslash}X|}
\hline
\hd Thành phần & \hd Vai trò \\ \hline
ESP-IDF 6.1 và FreeRTOS & Framework cho máy chủ: driver, Wi-Fi, TCP/IP, HTTP, NVS, hệ điều hành \\ \hline
\code{esp\_lcd}, LEDC, \code{esp\_timer} & Driver màn hình qua SPI DMA, PWM cho servo, hẹn giờ đóng thanh chắn \\ \hline
\code{espressif/mdns}, \code{espressif/qrcode} & Tên \code{parking.local}; mã hóa mã QR thanh toán \\ \hline
Arduino core ESP8266, thư viện MFRC522 và DHT & Nền tảng và thư viện thiết bị cho Sensor Client và RFID Client \\ \hline
HTML, CSS, JavaScript thuần & Trang web quản lý nhúng trong firmware, không phụ thuộc thư viện ngoài \\ \hline
Trình biên dịch C/C++ trên máy tính & Chạy bộ kiểm thử tự động không cần phần cứng \\
\hline
\end{tabularx}
\end{table}

Như Bảng~\ref{tab:software} cho thấy, trang web được viết bằng HTML, CSS và JavaScript thuần
và nhúng trực tiếp vào firmware, nên vẫn mở được khi router mất kết nối Internet. Bộ kiểm thử
biên dịch mã nghiệp vụ của máy chủ và mã nguồn hai client trên máy tính cùng các thư viện
giả lập phần cứng, giúp kiểm tra logic trong vài giây mà không cần mô hình
(Chương~\ref{chap:kiemthu}).
