thinhdinh25/INT3108_embedded-Smart-Parking-Project/report/chapters/pl_donggop.tex

% =====================================================================
\chapter*{ĐÓNG GÓP CỦA THÀNH VIÊN VÀ PHÂN CHIA ĐIỂM}\label{chap:donggop}
\addcontentsline{toc}{chapter}{ĐÓNG GÓP CỦA THÀNH VIÊN VÀ PHÂN CHIA ĐIỂM}
\begingroup\renewcommand{\thetable}{\arabic{table}}
% =====================================================================

\section*{Phân công công việc}
Đề tài có ba mảng với khối lượng tương đương: phần mềm gồm firmware ba thiết bị, trang web và
kiểm thử; điện gồm chọn linh kiện, thiết kế nguồn và đi dây; cơ khí gồm mô hình và cơ cấu thanh
chắn. Mỗi thành viên phụ trách chính một mảng và tham gia phần giao với các mảng khác. Nhóm làm
việc trên một kho GitHub chung và họp mỗi tuần để tích hợp, chạy thử trên mô hình.
Bảng~\ref{tab:mang} tóm tắt phân công.

\begin{table}[!htb]
\centering\small
\caption{Phân công công việc}\label{tab:mang}
\begin{tabularx}{\linewidth}{|>{\raggedright\arraybackslash}m{3.2cm}|>{\raggedright\arraybackslash}X|>{\raggedright\arraybackslash}X|}
\hline
\hd Thành viên & \hd Mảng chính & \hd Phần giao với mảng khác \\ \hline
Nguyễn Chí Minh & Firmware máy chủ: kiến trúc tác vụ, UDP, HTTP, màn hình, thanh toán VietQR và SePay, bảo mật; trang web; bộ kiểm thử tự động & Thống nhất giao thức với hai client; tích hợp và tối ưu toàn hệ thống; các sơ đồ thiết kế \\ \hline
Đinh Đức Thịnh & Chọn linh kiện, thiết kế nguồn với tụ lọc và diode hạ áp, sơ đồ chân, sơ đồ nguyên lý, đi dây & Firmware Sensor Client và RFID Client; khởi tạo dự án ESP-IDF \\ \hline
Nguyễn Việt Tiến & Mô hình bãi xe, hộp điều khiển, cơ cấu thanh chắn và cảm biến cổng & Firmware thanh chắn và còi; kịch bản kiểm thử trên mô hình; tài liệu cài đặt \\
\hline
\end{tabularx}
\end{table}

Theo Bảng~\ref{tab:mang}, phần việc điện và cơ khí như đo đạc, đi dây, sửa lỗi nguồn, chế tạo
mô hình và căn chỉnh servo chiếm nhiều thời gian nhưng không thể hiện trong lịch sử Git. Vì vậy
nhóm đánh giá đóng góp theo mảng việc và thời gian thực hiện, không theo số dòng mã. Ngoài ra,
cả nhóm cùng phân tích yêu cầu, thống nhất giao thức, tinh chỉnh thông số trên mô hình như thời
gian lọc nhiễu và thời gian mở cổng, và rà soát chéo báo cáo.

\section*{Phân chia điểm}
Cả ba thành viên thống nhất chia điểm báo cáo như Bảng~\ref{tab:diem}.

\begin{table}[!htb]
\centering\small
\caption{Phân chia điểm báo cáo}\label{tab:diem}
\begin{tabular}{|l|c|c|}
\hline
\hd Thành viên & \hd MSSV & \hd Tỉ lệ điểm báo cáo \\ \hline
Nguyễn Chí Minh & 24020232 & 100\% \\ \hline
Đinh Đức Thịnh & 24020313 & 100\% \\ \hline
Nguyễn Việt Tiến & 24020322 & 100\% \\
\hline
\end{tabular}
\end{table}

\vspace{1cm}
\needspace{7\baselineskip}
\noindent Xác nhận của các thành viên:
\par\vspace{0.5cm}
\noindent
\begin{tabular*}{\linewidth}{@{\extracolsep{\fill}}ccc@{}}
Nguyễn Chí Minh & Đinh Đức Thịnh & Nguyễn Việt Tiến \\[1.6cm]
\rule{3.6cm}{0.4pt} & \rule{3.6cm}{0.4pt} & \rule{3.6cm}{0.4pt} \\
\end{tabular*}
\endgroup
