thinhdinh25/INT3108_embedded-Smart-Parking-Project/report/chapters/kl_ketluan.tex

% =====================================================================
\chapter*{KẾT LUẬN}\addcontentsline{toc}{chapter}{KẾT LUẬN}\label{chap:ketluan}
% =====================================================================
Đề tài đã xây dựng hoàn chỉnh một hệ thống bãi đỗ xe thông minh quy mô mô hình gồm ba vi điều
khiển phối hợp qua Wi-Fi. Máy chủ ESP32-C3 chạy FreeRTOS quản lý phiên gửi xe, tính phí, điều
khiển hai thanh chắn có cảm biến chống hạ xuống thân xe, hiển thị trên màn hình TFT và phục vụ
trang web quản lý; Sensor Client và RFID Client dùng ESP8266 thu thập trạng thái ô đỗ, cháy, mực nước, nhiệt độ và sự
kiện quẹt thẻ. Cả 10 use case, từ gửi xe, thanh toán tới xử lý sự cố và quản lý bãi, đều được hiện thực và kiểm chứng; người lái thanh toán bằng mã
VietQR với số tiền cố định, hệ thống tự đối soát giao dịch qua SePay trước khi mở cổng ra.

Về mặt học thuật, đề tài vận dụng các kiến thức trọng tâm của môn học: lập trình đa tác vụ và
đồng bộ trên hệ điều hành thời gian thực, điều khiển ngoại vi bằng khối phần cứng chuyên dụng
như PWM, SPI có DMA, ADC, thiết kế nguồn và ghép nối mức logic giữa các linh kiện, giao tiếp
mạng không dây với cơ chế tin cậy ở tầng ứng dụng, quản lý bộ nhớ hạn chế, và kiểm thử phần
mềm nhúng không cần phần cứng với 439 phép kiểm tra tự động.
