thinhdinh25/INT3108_embedded-Smart-Parking-Project/report/chapters/kl_tongket.tex

Đề tài đã xây dựng hoàn chỉnh một hệ thống bãi đỗ xe thông minh quy mô mô hình gồm ba vi
điều khiển kết nối qua Wi-Fi: máy chủ ESP32-C3 chạy FreeRTOS quản lý phiên gửi xe, tính
phí, điều khiển thanh chắn, hiển thị trên màn hình TFT và trang web, cùng hai client
ESP8266 đọc cảm biến chỗ đỗ, lửa, mực nước, nhiệt độ và thẻ RFID. Cả 10 use case đều được
hiện thực và kiểm chứng; người lái có thể thanh toán bằng mã VietQR, hệ thống tự xác nhận
giao dịch qua SePay và mở thanh chắn.

Về mặt học thuật, đề tài vận dụng các kiến thức chính của môn học: lập trình đa tác vụ và
đồng bộ trên hệ điều hành thời gian thực, điều khiển ngoại vi bằng phần cứng chuyên dụng
(PWM, SPI có DMA, ADC, GPIO), giao tiếp mạng không dây, quản lý bộ nhớ hạn chế và kiểm thử
phần mềm nhúng khi không có phần cứng (429 phép kiểm thử tự động đều đạt). Các hạn chế còn
lại đã được phân tích kèm nguyên nhân và hướng khắc phục (Mục~\ref{sec:conlai}).
