thinhdinh25/INT3108_embedded-Smart-Parking-Project/report/schematic/sheet2.pdf

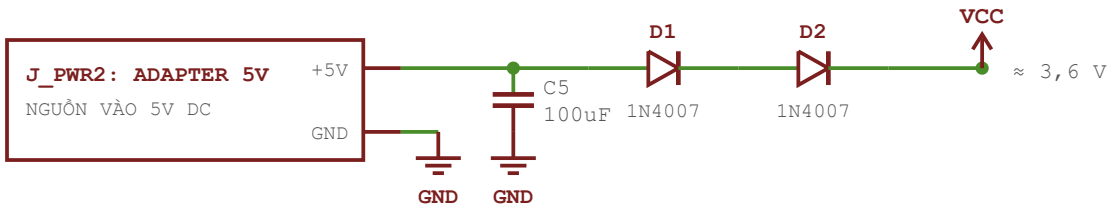
[picture p32: figure]
J_PWR2: ADAPTER 5V NGUỒN VÀO 5V DC; GND; VCC

U2
ESP8266 SENSOR

VCC

VCC

GND

GND

GPIO16 (D0)

IR1 (Ô S1)

VCC
GND

OUT

VCC
GND

IR_S1

GPIO4 (D2)

IR2 (Ô S2)

VCC
GND

OUT

VCC
GND

IR_S2

GPIO14 (D5)

IR3 (Ô S3)

VCC
GND

OUT

VCC
GND

IR_S3

GPIO13 (D7)

IR4 (Ô S4)

VCC
GND

OUT

VCC
GND

IR_S4

GPIO12 (D6)

IR5 (Ô S5)

VCC
GND

OUT

VCC
GND

IR_S5

GPIO5 (D1)

FLM1 BÁO LỬA

DO

VCC

GND

VCC

GND

A0 (ADC)

WTR1 MỰC NƯỚC

AO

VCC

GND

VCC

GND

BẢN VẼ 2: SENSOR CLIENT (ESP8266 + 5 IR + LỬA + NƯỚC)

NGUỒN: 5V -> C5 -> D1, D2 -> VCC ~3,6V
HỌC PHẦN: INT3108 - ĐH CÔNG NGHỆ (VNU-UET)

PHIÊN BẢN: 2.0
TRANG: 2 / 3
