thinhdinh25/INT3108_embedded-Smart-Parking-Project/report/diagrams/clientloops.pdf

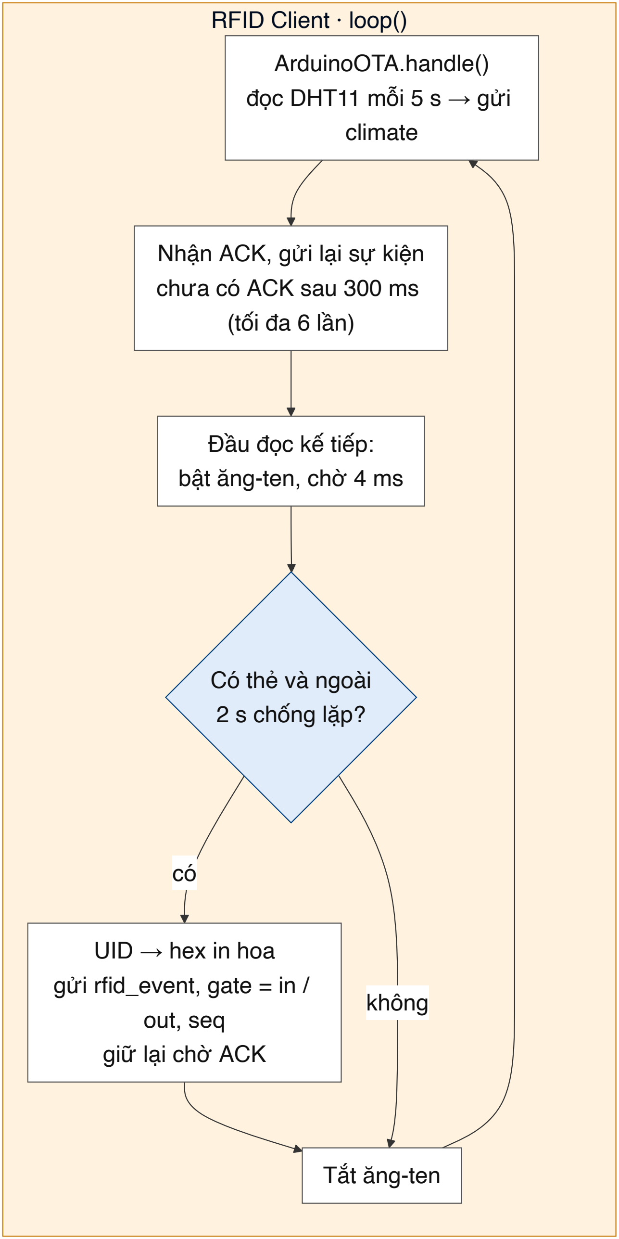
[picture p33: figure]
RFID Client · loop(); không; ArduinoOTA.handle() đọc DHT11 mỗi 5 s → gửi; climate; Nhận ACK, gửi lại sự kiện chưa có ACK sau 300 ms (tối đa 6 lần); Đầu đọc kế tiếp:; bật ăng-ten, chờ 4 ms; Có thẻ và ngoài 2 s chống lặp?; UID → hex in hoa; gửi rfid_event, gate = in / out, seq giữ lại chờ ACK; Tắt ăng-ten
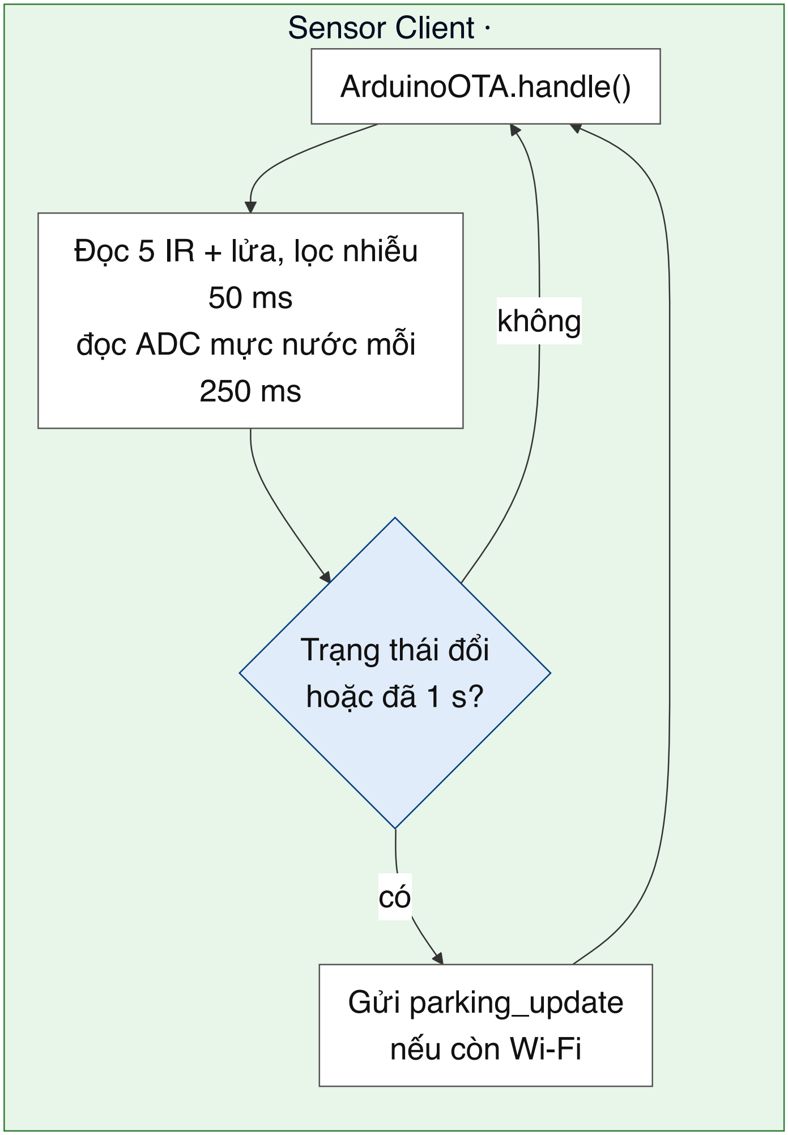
[picture p34: figure]
Sensor Client · loop(); không; ArduinoOTA.handle(); Đọc 5 IR + lửa, lọc nhiễu; 50 ms đọc ADC mực nước mỗi; Trạng thái đổi; hoặc đã 1 s?; Gửi parking_update nếu còn Wi-Fi
