thinhdinh25/INT3108_embedded-Smart-Parking-Project/report/chapters/c5_hanche.tex

\section{Hạn chế còn tồn tại, nguyên nhân và cách khắc phục}\label{sec:conlai}
Các điểm dưới đây là đánh đổi có chủ đích ở quy mô mô hình, đã được ghi rõ trong mã nguồn
và hướng dẫn:
\begin{longtable}{@{}>{\raggedright\arraybackslash}p{3.8cm}>{\raggedright\arraybackslash}p{5.1cm}>{\raggedright\arraybackslash}p{5.3cm}@{}}
\caption{Hạn chế còn tồn tại}\label{tab:conlai}\\
\toprule \textbf{Hạn chế} & \textbf{Nguyên nhân} & \textbf{Cách khắc phục} \\ \midrule \endfirsthead
\toprule \textbf{Hạn chế} & \textbf{Nguyên nhân} & \textbf{Cách khắc phục} \\ \midrule \endhead
Trang web dùng HTTP, người cùng mạng có thể nghe được mã PIN & HTTPS cần chứng chỉ và thêm $\approx$ 40\,KB RAM cho TLS phía máy chủ & Bật HTTPS cho trang quản trị khi dùng chip nhiều RAM hơn (ESP32-S3 có PSRAM) \\
Bản tin UDP không được ký: thiết bị trong mạng có thể gửi thẻ giả, báo cháy giả & Chọn giao thức đơn giản, dễ gỡ lỗi trên mạng Wi-Fi riêng có WPA2 & Ký bản tin bằng HMAC kèm số thứ tự chống phát lại \\
Phụ thuộc router Wi-Fi chung; router bật cô lập thiết bị sẽ chặn broadcast & Ba bo giao tiếp qua điểm phát chung & Dùng router riêng cho bãi, tắt cô lập thiết bị; hoặc ESP-NOW giữa các bo \\
Token SePay có toàn quyền đọc giao dịch và nằm trong flash máy chủ & SePay không giới hạn quyền token; máy chủ phải tự gọi API & Mã hóa flash (flash encryption) hoặc chuyển việc gọi SePay sang một máy chủ trung gian dùng webhook \\
Mỗi lúc chỉ một xe thanh toán ở cổng ra & Một cổng ra, một màn hình QR; ví như MoMo bỏ nội dung chuyển khoản nên phải đối chiếu theo số tiền & Mỗi lượt một tài khoản ảo (VA) riêng theo đơn hàng \\
Ứng dụng ngân hàng có thể cho sửa số tiền; chuyển sai thì cổng không mở và tiền không được hoàn tự động & VietQR chỉ điền sẵn số tiền, việc khóa ô nhập do từng ứng dụng quyết định; máy chủ chỉ đọc được giao dịch & Thêm quy trình hoàn tiền của người vận hành, hoặc cổng thanh toán có hoàn tiền qua API \\
Xóa xe trên trang web không để lại dấu vết trong nhật ký; ai có PIN đều có thể cho xe ra mà không tính phí & Nút xóa chỉ dùng để sửa danh sách sai & Ghi một sự kiện \code{DELETED} vào nhật ký \\
Còi cảnh báo xe không thẻ không tắt được bằng tay; cảm biến IR bị che hoặc hỏng làm còi kêu mãi & Chưa có nút tắt còi; còi chỉ dừng khi hai số khớp hoặc cảm biến mất kết nối & Thêm nút tắt còi trên trang web \\
Chưa có trình duyệt nào gửi giờ sau mất điện thì thời gian mất điện chưa được tính & Máy chủ không có đồng hồ thời gian thực & Thêm module RTC DS3231 hoặc lấy giờ qua SNTP khi có Internet \\
\bottomrule
\end{longtable}
