thinhdinh25/INT3108_embedded-Smart-Parking-Project/report/chapters/ch5b_chitiet.tex

% ---------------------------------------------------------------------
\section{Giao thức và giao diện lập trình}\label{sec:giaothuc}
\begin{lstlisting}[language=json,caption={Bản tin \code{parking\_update} (Sensor Client → máy chủ)}]
{"type":"parking_update","slots":[1,0,0,1,0],"water_mm":0.2,"fire":false}
\end{lstlisting}
\begin{lstlisting}[language=json,caption={Bản tin \code{rfid\_event} (RFID Client → máy chủ)}]
{"type":"rfid_event","card_id":"A1B2C3D4","gate":"in","temperature_c":28.0}
\end{lstlisting}
\begin{lstlisting}[language=json,caption={Bản tin \code{climate} (RFID Client → máy chủ, mỗi 5\,s)}]
{"type":"climate","temperature_c":28.0}
\end{lstlisting}

\paragraph{Xác nhận sự kiện quẹt thẻ.} Bản tin \code{rfid\_event} có thêm trường \code{seq}
(số nguyên 32 bit, khác 0) do RFID Client đặt; máy chủ trả lời bằng một gói JSON cùng
\code{seq}:
\begin{lstlisting}[language=json,caption={Sự kiện quẹt thẻ và gói xác nhận}]
{"type":"rfid_event","card_id":"A1B2C3D4","gate":"in","temperature_c":28.0,"seq":305441741}
{"type":"rfid_ack","seq":305441741}
\end{lstlisting}
\begin{itemize}[nosep]
  \item RFID Client gửi lại đúng gói đó mỗi 300\,ms (tối đa 6 lần) cho tới khi nhận được ACK.
  \item Máy chủ nhớ 16 giá trị \code{seq} gần nhất: gặp lại một \code{seq} đã xử lý là bản
        gửi lại, chỉ trả ACK chứ không mở cổng lần hai.
  \item \code{seq} bắt đầu từ một số ngẫu nhiên (bộ sinh số ngẫu nhiên phần cứng của
        ESP8266) mỗi lần khởi động rồi tăng dần, nên gần như không trùng với số máy chủ
        vừa thấy; client không cần lưu gì vào flash.
\end{itemize}

\begin{lydo}[Tại sao không ký (xác thực) gói UDP]
Ba bo nằm trong mạng Wi-Fi riêng của nhóm, được bảo vệ bằng WPA2; chỉ thiết bị
biết mật khẩu Wi-Fi mới gửi được gói tin. Ở quy mô mô hình, nhóm ưu tiên giao thức đơn
giản, đọc được trực tiếp trong log và dễ giả lập bằng script. Các thao tác nhạy cảm từ
trình duyệt (mở cổng, đặt giờ) vẫn cần mã PIN. Ký gói bằng mã xác thực (HMAC) được để
lại cho hướng phát triển.
\end{lydo}

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

\begin{table}[H]
\centering\small
\caption[API HTTP của máy chủ (13 route)]{API HTTP của máy chủ (13 route); mọi lệnh POST cần header \code{X-Parking-Key} đúng mã PIN, sai thì trả 401}\label{tab:api}
\begin{tabularx}{\linewidth}{@{}lp{4.4cm}X@{}}
\toprule
\textbf{PT} & \textbf{Đường dẫn} & \textbf{Kết quả} \\ \midrule
GET & \code{/}, \code{/style.css} & Trang web nhúng trong firmware \\
GET & \code{/api/parking} & \code{received}, \code{online}, \code{slots}, \code{free}, \code{total}, \code{temperature\_c}, \code{water\_mm}, \code{fire}, \code{flood} \\
GET & \code{/api/barrier} & \code{\{"in\_open":bool,"out\_open":bool\}} \\
GET & \code{/api/rfid} & \code{now\_s}, \code{fee\_per\_hour}, \code{today}/\code{week} (doanh thu, lượt vào, lượt ra), \code{parked[]} (thẻ, giờ vào, phí tạm tính), \code{payment} (lượt thanh toán đang chờ: \code{\{"card","fee","code","expired"\}} hoặc \code{null}), \code{log[]} (10 sự kiện mới nhất) \\
POST & \code{/api/barrier/}\allowbreak\code{<cổng>/<lệnh>} & Cổng \code{in}, \code{out}, \code{all}; lệnh \code{open}, \code{close}. Lỗi 500 nếu bị từ chối (ví dụ đóng khi có cháy) \\
POST & \code{/api/time} & Thân là giờ Unix (giây) từ trình duyệt; máy chủ đặt đồng hồ bãi và lưu NVS \\
POST & \code{/api/payment/confirm} & Thân là mã thẻ; người vận hành xác nhận đã nhận tiền (chuyển khoản hoặc tiền mặt): xe ra như bình thường. Dùng được cả cho xe chưa quẹt ra (thu phí đến hiện tại) \\
\bottomrule
\end{tabularx}
\end{table}

% ---------------------------------------------------------------------
\section{Thiết kế chi tiết từng thành phần}\label{sec:chitiet}

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

\begin{lydo}[Tại sao 50\,Hz, 14 bit, LEDC]
\textbf{50\,Hz} là tần số chuẩn của servo RC analog. \textbf{14 bit} là độ phân giải
lớn nhất của LEDC trên ESP32-C3: mỗi bước $20\,000/16\,384 \approx 1{,}22$\,µs $\approx 0{,}12°$,
mịn hơn nhiều vùng chết $\approx$1° của SG90 nên servo không rung. \textbf{LEDC} là PWM
phần cứng: xung phát liên tục mà CPU không can thiệp, servo giữ góc ổn định dù
Wi-Fi hay màn hình đang bận. Dải 500–2400\,µs là giá trị đo thực tế của SG90 (danh
nghĩa 1000–2000\,µs không đủ 180°).
\end{lydo}

\begin{lydo}[Tại sao dùng hẹn giờ một lần (\code{esp\_timer}) thay vì tác vụ hỏi vòng]
Phiên bản đầu dùng một tác vụ thức dậy 20 lần/giây để kiểm tra hạn đóng. Phiên bản
hiện tại tạo một \code{esp\_timer} một lần cho mỗi cổng: hàm đóng được gọi \emph{đúng}
lúc hết 3\,s (sai số micro giây thay vì 50\,ms), CPU không bị đánh thức vô ích và tiết
kiệm 3\,KB stack. Vì một lệnh khác có thể ``đua'' với hàm đóng, hàm đóng kiểm tra lại
hạn đóng dưới mutex; lệnh tay từ web đặt hạn về 0 và dừng hẹn giờ — \textbf{lệnh của
người vận hành luôn thắng}.
\end{lydo}

Hai cổng được mô tả bằng cùng một cấu trúc (kênh LEDC, chân, hướng lắp, trạng thái,
hạn đóng, hẹn giờ) nên một hàm xử lý cho cả hai. Thanh chắn ra lắp đối xứng nên góc
mở/đóng đảo ngược (0° mở, 90° đóng) — chỉ khai báo ở một hàm. Cả hai cổng \textbf{luôn
khởi động ở vị trí đóng}, nên trạng thái không cần lưu vào flash; phiên bản trước ghi
NVS mỗi lần thanh chắn chuyển động đã được bỏ (chậm và làm mòn flash vô ích).

\subsection{Màn hình: SPI DMA, vẽ theo sự kiện, ảnh động tiền xử lý}
\begin{lydo}[Tại sao SPI 40\,MHz và DMA]
Một khung hình đầy đủ là $240\times240\times16 = 921\,600$ bit; ở 40\,MHz mất
$\approx$ 23\,ms, tối đa $\approx$ 43 khung/giây — dư cho giao diện tĩnh và màn hình cháy
8 khung/giây. 40\,MHz bằng đúng $80\,\text{MHz}/2$ (không sai số chia tần) và dưới giới
hạn ghi $\approx$ 62\,MHz của ST7789, chừa biên an toàn cho dây cắm. DMA cho phép CPU
làm việc khác trong lúc ảnh được đẩy ra.
\end{lydo}

\begin{itemize}
\item \textbf{Framebuffer RGB565} 115\,200 byte: toàn bộ giao diện được vẽ vào RAM rồi gửi
  một lần. Màu được lưu sẵn theo thứ tự byte của ST7789 (byte cao trước) vì
  ESP32-C3 là little-endian.
\item \textbf{Hàm tô hình chữ nhật} cắt biên một lần và tô từng dòng liên tục thay vì
  kiểm tra biên và đảo byte cho từng điểm ảnh.
\item \textbf{Font 5$\times$7 tự định nghĩa} cho A–Z, 0–9 (180 byte) — không cần thư viện
  đồ họa lớn như LVGL cho một giao diện cố định.
\item \textbf{Vẽ theo sự kiện}: \file{udp\_server} đánh thức tác vụ màn hình bằng thông
  báo tác vụ ngay khi có dữ liệu; nếu không có gì, tác vụ chỉ thức mỗi 1\,s (để hết hạn
  hóa đơn/thông báo) hoặc 120\,ms khi có cháy (để lửa nhấp nháy). Màn hình chỉ vẽ lại
  khi nội dung thực sự thay đổi.
\end{itemize}

\begin{table}[H]
\centering\small
\caption{Dữ liệu ảnh động sau tiền xử lý và nén LZSS}\label{tab:lzss}
\begin{tabular}{@{}lrrrr@{}}
\toprule
\textbf{Ảnh} & \textbf{Kích thước} & \textbf{Số khung} & \textbf{Dữ liệu thô} & \textbf{Sau nén} \\ \midrule
Kaoruko & 96$\times$96 & 10 & 184\,320 B & 70\,564 B (2,6$\times$) \\
Claude & 68$\times$46 & 18 & 112\,608 B & 16\,204 B (6,9$\times$) \\
\bottomrule
\end{tabular}
\end{table}
\noindent Hai bộ đệm DMA $96\times96$ của ảnh Kaoruko (36\,KB) chính là phần heap mà bắt tay HTTPS
với SePay cần. Vì ảnh động vốn dừng khi đang hiện mã QR, tác vụ \code{lcd\_animation} trả hai bộ đệm
này lại trong lúc có xe đang thanh toán và cấp phát lại sau đó; nếu lúc ấy heap chưa đủ thì chỉ bỏ
qua khung hình.

\begin{lydo}[Tại sao tiền xử lý ảnh trên máy tính]
Ảnh gốc có nền trắng cần xóa và điểm ảnh cần đảo byte. Phiên bản trước làm việc
này trên chip cho \emph{mọi khung hình}, 10 lần/giây: thuật toán loang tìm nền trắng
nối với viền (cần thêm 1,2\,KB RAM) rồi đảo byte 9\,216 điểm. Vì ảnh không bao giờ
đổi, nhóm làm một lần trên máy tính và lưu kết quả đã xử lý: firmware chỉ còn giải
nén. Kết quả được kiểm chứng giống từng điểm ảnh với cách cũ trên cả 28 khung, dữ
liệu còn nhỏ hơn (86\,768 so với 87\,977 byte). LZSS có bộ giải nén $\approx$ 40 dòng,
không cần bộ nhớ phụ và kiểm tra biên đầy đủ nên dữ liệu hỏng không gây ghi tràn.
\end{lydo}

\textbf{Hai bộ đệm DMA} (2 $\times$ 18\,432 byte) được dùng luân phiên cho ảnh động:
lệnh vẽ chỉ \emph{xếp hàng} giao dịch DMA rồi trả về, nên giải nén khung kế tiếp vào
cùng bộ đệm khi DMA chưa đọc xong sẽ làm hình bị xé. Hai tác vụ cùng vẽ lên một
panel nên dùng chung một mutex.

\subsection{Bộ kiểm tra bản tin JSON}
\begin{lydo}[Tại sao tự viết thay vì dùng thư viện cJSON]
Gói UDP là \emph{ranh giới tin cậy}: bất kỳ thiết bị nào trong mạng đều gửi được.
cJSON cấp phát heap cho từng nút (phân mảnh heap khi chạy lâu) và chấp nhận mọi JSON
hợp lệ. Bộ đọc tự viết (\file{json\_scan.c}, 81 dòng, dùng chung cho cả hai loại bản
tin) \textbf{không cấp phát động}, chỉ chấp nhận đúng lược đồ (Bảng~\ref{tab:fields})
và có \textbf{vòng lặp giới hạn} (tối đa 4 khóa) nên thời gian xử lý bị chặn trên.
Bộ đệm nhận 256 byte, đọc tối đa 255 byte và luôn kết thúc bằng \code{'\textbackslash0'}.
\end{lydo}

\subsection{Phiên gửi xe, phí, thông báo và nhật ký}
\begin{itemize}
\item \textbf{Phiên}: mảng tĩnh 5 phần tử — bằng số chỗ đỗ, vì không thể có nhiều xe hơn số chỗ.
  Thời điểm vào lấy từ \code{esp\_timer\_get\_time()} (64 bit, micro giây, không tràn trong
  hơn 290\,000 năm).
\item \textbf{Phí}: $h=\max(1,\lceil t/3600\rceil)$, phí $=5000\,h$ VNĐ, tính bằng số
  nguyên \code{(t + 3599) / 3600}, bão hòa ở \code{UINT32\_MAX} nếu tràn.
\item \textbf{Thông báo từ chối} (sai cổng, bãi đầy): giữ 5\,s; lần quẹt hợp lệ tiếp
  theo xóa thông báo ngay.
\item \textbf{Nhật ký}: bộ đệm vòng 10 sự kiện ($\approx$ 520 byte), đọc ra theo thứ tự mới
  nhất trước; không dùng heap.
\end{itemize}

\begin{lydo}[Tại sao chọn các thông số này]
\textbf{5.000\,VNĐ/giờ, làm tròn lên, tối thiểu 1 giờ} là cách tính phổ biến của bãi
xe, dễ giải thích. \textbf{Hóa đơn 60\,s} đủ để tài xế đọc và trả tiền; \textbf{thông
báo 5\,s} đủ đọc mà không che hóa đơn quá lâu. \textbf{Thanh chắn mở 3\,s} đủ cho xe mô
hình đi qua nhưng không đủ để xe sau ``đi ké''. \textbf{Nhật ký 10 sự kiện} vừa một màn
hình điện thoại và tốn dưới 1\,KB RAM.
\end{lydo}

\subsection{Thanh toán VietQR qua SePay}\label{sec:vietqr}
Khi thanh toán QR được bật, quẹt thẻ ở cổng ra \emph{không} mở cổng ngay: máy chủ chốt
phí tại thời điểm quẹt, tạo một \textbf{mã thanh toán} và vẽ mã VietQR lên TFT. Mọi ứng
dụng ngân hàng Việt Nam quét được mã này, số tiền và nội dung chuyển khoản đã điền sẵn.
Thanh chắn ra chỉ mở khi máy chủ thấy giao dịch khớp (qua SePay) hoặc người vận hành bấm
\code{Confirm paid} trên trang web (Hình~\ref{fig:seq-pay}).

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

\paragraph{Màn hình thanh toán.} Mã QR được sinh bằng thành phần \code{espressif/qrcode}
(thư viện qrcodegen của Nayuki), mức sửa lỗi M, phiên bản tối đa 10, mỗi mô-đun
$\approx$ 3 điểm ảnh, viền trắng 2 mô-đun. Bên dưới là \code{SCAN TO PAY}, phí (VNĐ),
\code{NOTE <mã>  ID <thẻ>} và \code{BIDV <số tài khoản> <tên>}. Thứ tự ưu tiên hiển thị:
màn hình cháy > màn hình thanh toán > màn hình thường. Việc sinh QR không cần mạng.

\begin{figure}[H]
\centering
\mmd[0.8][0.62]{seq_pay}
\caption{Biểu đồ tuần tự thanh toán VietQR ở cổng ra, xác nhận tự động qua SePay}\label{fig:seq-pay}
\end{figure}

\paragraph{Kiểm tra chuyển khoản qua SePay.} SePay đọc biến động số dư của tài khoản
nhận và cho truy vấn qua API. Tác vụ \code{sepay} (\file{network/sepay\_client.c}, stack
8\,KB, ưu tiên 3) chỉ được tạo khi có token. Khi một lượt thanh toán bắt đầu, tác vụ gửi
\code{GET} tới \url{https://my.sepay.vn/userapi/transactions/list} với tham số
\code{limit=1} (header \code{Authorization: Bearer <token>}) để ghi lại id giao dịch mới nhất; sau đó
cứ 3\,s gọi lại với \code{since\_id=<id+1>\&limit=20}, nên chỉ giao dịch \emph{sau} lúc hiện QR
được xét. Hàm \code{sepay\_has\_payment()} tìm giao dịch có \code{transaction\_content}
chứa mã (không phân biệt hoa thường, phòng khi ngân hàng đổi kiểu chữ của nội dung) và
\code{amount\_in} $\ge$ phí. Ví MoMo và một số ví điện tử thay nội dung bằng chữ của riêng họ (đã gặp khi thử thật), nên hàm \code{sepay\_has\_transfer\_to()} còn chấp nhận giao dịch vào đúng tài khoản/VA nhận với số tiền \emph{đúng bằng} phí; vì mỗi lúc chỉ một xe thanh toán và chỉ xét giao dịch sau lúc hiện QR, cách này không nhầm xe. TLS dùng bộ chứng chỉ gốc của ESP-IDF; với
\code{CONFIG\_MBEDTLS\_DYNAMIC\_BUFFER=y}, bộ đệm TLS chỉ được cấp phát trong lúc gửi yêu
cầu — cần thiết vì RAM đã chật bên cạnh framebuffer 115\,KB. Lỗi mạng hoặc lỗi HTTP chỉ
ghi cảnh báo và thử lại ở chu kỳ sau.

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

\begin{lydo}[Tại sao hỏi vòng SePay thay vì webhook]
SePay hỗ trợ webhook (gọi tới một URL khi có tiền vào), nhưng ESP32-C3 nằm sau router
(NAT) nên không có địa chỉ mà Internet gọi tới được; dùng webhook sẽ phải thêm một máy
chủ trung gian trên Internet hoặc mở cổng trên router. Hỏi vòng chỉ cần kết nối
\emph{đi ra}, và chỉ chạy khi có xe đang thanh toán. Chu kỳ 3\,s cho độ trễ vài giây,
đủ nhanh với người đang chờ ở cổng, và thấp hơn rất nhiều so với giới hạn 2–3 yêu
cầu/giây cho mỗi token của SePay. Truy vấn \code{since\_id} giữ câu trả lời ở vài giao
dịch mới nhất nên bộ đệm nhận chỉ cần 6\,KB.
\end{lydo}

\begin{lydo}[Tại sao vẫn cho người vận hành xác nhận tay]
Thanh toán tự động phụ thuộc Internet, SePay và việc có token. Khi một trong ba thiếu
— hoặc người lái trả tiền mặt — bãi vẫn phải cho xe ra. Mã QR vẫn hiển thị vì không cần
mạng; người vận hành thấy giao dịch trong ứng dụng ngân hàng và bấm \code{Confirm paid}
(\code{POST /api/payment/confirm}, cần mã PIN quản trị). Lệnh này cũng dùng được cho xe
chưa quẹt ra (tính phí đến thời điểm xác nhận), nên một đường xử lý chung phục vụ cả
chuyển khoản lẫn tiền mặt.
\end{lydo}

\subsection{Sensor Client: lọc nhiễu và gửi theo thay đổi}
\begin{figure}[H]
\centering
\begin{tikzpicture}[x=0.9cm,y=0.6cm,font=\scriptsize]
\node[anchor=east] at (-0.2,2.5) {Tín hiệu thô};
\draw[thick] (0,2) -- (2,2) -- (2,3) -- (2.3,3) -- (2.3,2) -- (2.5,2) -- (2.5,3) -- (2.7,3) -- (2.7,2) -- (2.9,2) -- (2.9,3) -- (11,3);
\node[anchor=east] at (-0.2,0.5) {Trạng thái};
\draw[thick,accent] (0,0) -- (3.9,0) -- (3.9,1) -- (11,1);
\draw[dashed,gray] (2.9,3.3) -- (2.9,-0.4);
\draw[dashed,gray] (3.9,3.3) -- (3.9,-0.4);
\draw[{Stealth}-{Stealth}] (2.9,-0.6) -- node[below]{ổn định 50\,ms} (3.9,-0.6);
\node[align=center] at (2.45,3.8) {nhiễu khi xe\\đang lăn vào};
\node[draw,fill=boxB,align=center] at (7.5,-0.9) {gửi \code{parking\_update} ngay};
\draw[-{Stealth},thick] (3.9,1) to[bend right=10] (6.2,-0.6);
\end{tikzpicture}
\caption{Chống rung: chỉ chấp nhận mức mới khi giữ ổn định 50\,ms, rồi gửi ngay}\label{fig:debounce}
\end{figure}

\begin{lydo}[Tại sao lọc 50\,ms và gửi theo thay đổi kèm nhắc lại 1\,s]
Mép xe và bánh xe làm tín hiệu IR bật/tắt liên tục trong vài chục mili giây khi xe
đang vào chỗ. Nhóm tinh chỉnh thực nghiệm từ 250\,ms xuống \textbf{50\,ms}: đủ lọc nhiễu
mà vẫn cho cảm giác tức thời. Trước đây trạng thái chỉ được gửi theo chu kỳ 1\,s nên thay đổi
có thể trễ đến 1\,s; nay \textbf{gửi ngay khi có thay đổi}, đồng thời vẫn \textbf{nhắc
lại mỗi giây} để một gói bị mất được sửa ở lần sau. Mỗi cảm biến có bộ đếm riêng.
\end{lydo}

Mực nước được quy đổi tuyến tính từ ADC 10 bit:
\begin{equation}
  h_{\text{mm}} =
  \begin{cases}
  0, & raw \le 20 \\[2pt]
  \dfrac{\min(raw, 700) - 20}{700 - 20} \cdot 40, & raw > 20
  \end{cases}
\end{equation}
trong đó 20 là mức nhiễu khi khô, 700 là giá trị khi ngập hoàn toàn và 40\,mm là
chiều dài vùng đo; ADC được đọc mỗi 250\,ms vì đọc quá dày ảnh hưởng Wi-Fi trên
ESP8266 trong khi mực nước thay đổi chậm.

\subsection{RFID Client: hai đầu đọc trên một bus SPI}
\begin{lydo}[Tại sao bật ăng-ten luân phiên, chờ 4\,ms, gain 48\,dB, chống lặp 2\,s]
Hai đầu đọc 13,56\,MHz đặt gần nhau sẽ \textbf{nhiễu chéo}; chỉ bật một ăng-ten tại
một thời điểm loại bỏ hoàn toàn vấn đề. Thẻ thụ động cần vài mili giây để nhận đủ năng
lượng: \textbf{4\,ms} đủ cho thẻ MIFARE mà chu kỳ quét vẫn ngắn. \textbf{Gain 48\,dB} bù
tầm đọc khi đầu đọc nằm sau vỏ mô hình. Thẻ để yên sẽ bị đọc liên tục; \textbf{chống
lặp 2\,s} áp dụng cho cả hai đầu đọc, tránh một lần quẹt bị gửi nhiều lần làm ``vào''
biến thành ``ra''. UID được đổi sang chuỗi hex bằng \textbf{bộ đệm cố định} thay vì
\code{String} của Arduino: không cấp phát heap mỗi lần quẹt, nên heap 80\,KB của
ESP8266 không bị phân mảnh khi chạy lâu. DHT11 đọc mỗi \textbf{5\,s} vì cảm biến cần ít
nhất 1\,s giữa hai lần đọc và nhiệt độ thay đổi chậm.
\end{lydo}

\subsection{Trang web}
\begin{lydo}[Tại sao hỏi vòng 1–2\,s thay vì WebSocket]
Hỏi vòng không giữ trạng thái kết nối trên máy chủ: mỗi yêu cầu độc lập, xử lý xong
giải phóng ngay — phù hợp với giới hạn socket và RAM, và đơn giản khi nhiều trình duyệt
cùng xem. Với dữ liệu thay đổi theo giây, độ trễ thêm tối đa 1\,s là chấp nhận được.
Trang web là HTML/CSS/JavaScript thuần, nhúng trong firmware bằng
\code{EMBED\_TXTFILES}: không cần phân vùng tệp, không phụ thuộc CDN (trang vẫn mở được
khi router mất Internet).
\end{lydo}

% ---------------------------------------------------------------------
\section{Phân tích kiến trúc}\label{sec:phantich}
\subsection{Hiệu năng và độ trễ}
\begin{table}[H]
\centering\small
\caption{Ngân sách độ trễ của các luồng chính (ước tính từ thông số thiết kế)}\label{tab:latency}
\begin{tabularx}{\linewidth}{@{}lXr@{}}
\toprule
\textbf{Luồng} & \textbf{Thành phần} & \textbf{Tổng} \\ \midrule
Xe vào ô → màn hình TFT & lọc 50\,ms + gửi ngay + UDP vài ms + đánh thức + vẽ 23\,ms & $\approx$ 0,1\,s \\
Xe vào ô → trang web & như trên + hỏi vòng tối đa 1\,s & $\le$ 1,1\,s \\
Quẹt thẻ → thanh chắn mở & quét 2 đầu đọc $\approx$ 10\,ms + UDP + xử lý $<$ 1\,ms + servo 90° $\approx$ 0,15\,s & $\approx$ 0,2\,s \\
Có lửa → còi kêu & lọc 50\,ms + gửi ngay + UDP & $\approx$ 0,06\,s \\
Mất một gói \code{parking\_update} & sửa ở lần nhắc lại & $\le$ 1\,s \\
Mất một gói \code{rfid\_event} & gửi lại sau 300\,ms chờ ACK & $\approx$ 0,5\,s \\
\bottomrule
\end{tabularx}
\end{table}

\subsection{Bộ nhớ}
\begin{table}[H]
\centering\small
\caption{Sử dụng bộ nhớ của firmware máy chủ (đo bằng \code{idf.py size})}\label{tab:memory}
\begin{tabularx}{\linewidth}{@{}Xr@{}}
\toprule
\textbf{Hạng mục} & \textbf{Kích thước} \\ \midrule
DRAM tĩnh dùng / tổng (mã IRAM + \code{.data} + \code{.bss}) & 99\,968 / 321\,296 B (31,1\%) \\
Framebuffer màn hình (heap, DMA) & 115\,200 B \\
2 bộ đệm ảnh động (heap, DMA; trả lại khi đang thanh toán) & 36\,864 B \\
Stack các tác vụ của ứng dụng & $\approx$ 19\,KB (+ 8\,KB tác vụ \code{sepay} khi có token) \\
Bộ đệm TLS khi gọi SePay (heap, chỉ tồn tại trong lúc gửi yêu cầu) & cấp phát động \\
Bảng phiên, hóa đơn, thông báo, nhật ký, 16 \code{seq} gần nhất & $<$ 1\,KB \\ \midrule
Ảnh firmware & 1\,223\,104 B \\
Phân vùng ứng dụng (\code{factory}) & 1\,536\,000 B (dùng 79,6\%) \\
\bottomrule
\end{tabularx}
\end{table}

\begin{lydo}[Tại sao phân vùng ứng dụng 1,5\,MB]
Bảng phân vùng mặc định chỉ có 1\,MB cho ứng dụng và đã đầy 98\% trước khi thêm mDNS.
Flash 2\,MB đủ chỗ cho phân vùng 1,5\,MB có sẵn trong ESP-IDF
(\code{partitions\_singleapp\_large.csv}), được khai báo trong \file{sdkconfig.defaults}
để mọi thành viên build ra cùng cấu hình; sau khi thêm HTTPS và mã QR vẫn còn 20\% dự phòng.
\end{lydo}

\subsection{Độ tin cậy và khả năng chịu lỗi}
\begin{table}[H]
\centering\small
\caption{Phân tích lỗi và cách hệ thống phản ứng}\label{tab:faults}
\begin{tabularx}{\linewidth}{@{}p{4.3cm}X@{}}
\toprule
\textbf{Tình huống lỗi} & \textbf{Phản ứng của hệ thống} \\ \midrule
Mất gói UDP cảm biến & Bản tin nhắc lại sau $\le$ 1\,s sửa trạng thái \\
Mất gói quẹt thẻ hoặc gói ACK & RFID Client gửi lại mỗi 300\,ms (tối đa 6 lần); máy chủ nhận bản sao chỉ trả ACK, không mở cổng hai lần \\
Bản tin sai định dạng / độc hại & Bị từ chối, trạng thái cũ giữ nguyên, có cảnh báo trong log \\
Xe vào không quẹt thẻ (đi theo xe trước) & Trang web cảnh báo lệch số thẻ / số ô có xe; khi IR báo đủ 5 ô thì từ chối thẻ mới \\
Socket UDP lỗi & Đóng socket, chờ 1\,s, tạo lại \\
Máy chủ mất Wi-Fi & Tự kết nối lại; nhận IP (có thể mới) → thông báo lại \code{parking.local} \\
Router mất Internet & Mọi chức năng tại bãi vẫn chạy; mã QR vẫn hiển thị (sinh trên chip); người vận hành xem giao dịch trong ứng dụng ngân hàng và bấm \code{Confirm paid} \\
SePay trả lỗi / hết thời gian chờ & Ghi cảnh báo, thử lại sau 3\,s; thanh chắn ra vẫn đóng cho tới khi khớp giao dịch hoặc người vận hành xác nhận \\
Không có chuyển khoản sau 180\,s & TFT báo \code{PAY AT BOOTH} 30\,s; xe khác được thanh toán; chuyển khoản đến muộn vẫn hoàn tất \\
Client mất Wi-Fi & Sensor Client bỏ qua lần gửi, tự kết nối lại; trang web báo OFFLINE \\
DHT11 đọc lỗi & Giữ giá trị hợp lệ gần nhất \\
Có cháy khi người vận hành bấm đóng & Lệnh đóng bị từ chối; thanh chắn giữ mở \\
Sensor Client im lặng quá 3\,s & TFT và web báo \code{SENSOR OFFLINE}, sơ đồ ô chuyển xám; trạng thái cháy/ngập cuối cùng được giữ (an toàn); dữ liệu cũ không được dùng để từ chối thẻ hay cảnh báo lệch \\
Nước ngập $\ge$ 20\,mm & Còi kêu, chặn xe vào, xe trong bãi vẫn ra; tắt khi $\le$ 15\,mm \\
Máy chủ mất điện, khởi động lại & Thanh chắn về vị trí đóng; phiên, nhật ký, các \code{seq} đã xử lý và đồng hồ được khôi phục từ NVS; thời gian mất điện được bù khi trình duyệt gửi giờ thực \\
Lỗi khởi tạo phần cứng & Fail-fast: in lỗi và khởi động lại \\
\bottomrule
\end{tabularx}
\end{table}

\subsection{Bảo mật}
\begin{itemize}
\item \textbf{Đã có}: kiểm tra bản tin chặt chẽ ở ranh giới mạng; không cấp phát động
  khi xử lý dữ liệu ngoài; mã thẻ giới hạn ký tự nên không thể chèn mã vào JSON hay
  HTML; trang web chèn dữ liệu bằng \code{textContent}, không dùng \code{innerHTML}
  cho dữ liệu từ máy chủ; mạng dùng WPA2.
\item \textbf{Bản tin UDP} không được ký: thiết bị đã vào được mạng Wi-Fi (biết mật khẩu
  WPA2) có thể gửi bản tin giả. Đây là đánh đổi có chủ đích (xem hộp ``Tại sao không ký
  gói UDP'').
\item \textbf{Xác thực API}: mọi lệnh thay đổi trạng thái (mở/đóng cổng, đặt giờ) cần mã
  PIN quản trị; so sánh mã PIN không dừng sớm để không lộ qua thời gian phản hồi.
\item \textbf{Bí mật ngoài mã nguồn}: mật khẩu Wi-Fi, mã PIN, số tài khoản và token
  SePay nằm trong \file{sdkconfig} (menuconfig) và \file{secrets.h}, cả hai bị
  \file{.gitignore} bỏ qua; kho mã chỉ chứa giá trị demo. Token SePay đặc biệt nhạy cảm
  vì SePay không cho giới hạn quyền của API token: ai có token đều đọc được toàn bộ giao
  dịch của tài khoản.
\item \textbf{Kết nối ra Internet}: chỉ có yêu cầu HTTPS từ máy chủ tới SePay, chứng
  chỉ máy chủ được kiểm tra bằng bộ chứng chỉ gốc của ESP-IDF; máy chủ không mở cổng nào
  ra Internet (nằm sau NAT của router). Thanh toán chỉ được công nhận khi giao dịch
  \emph{mới} (sau thời điểm hiện QR) có nội dung chứa đúng mã và số tiền $\ge$ phí.
\end{itemize}

\subsection{Khả năng bảo trì, kiểm thử và mở rộng}
\begin{itemize}
\item Lớp nghiệp vụ độc lập phần cứng: 397 phép kiểm thử chạy trên máy tính trong vài giây.
\item Hai client được kiểm thử bằng chính mã nguồn \file{.ino} trên phần cứng giả lập,
  kèm kiểm tra hợp đồng giao tiếp với bộ đọc JSON thật của máy chủ.
\item Số chỗ đỗ là hằng số \code{PARKING\_SLOT\_COUNT}; số phiên tối đa bằng số chỗ.
  Mở rộng quy mô lớn hơn cần đổi định dạng \code{slots} và tách cảm biến theo khu vực.
\end{itemize}

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

% ---------------------------------------------------------------------
\section{Demo}\label{sec:demo}
\subsection{Trang web giám sát}
Hình~\ref{fig:dashboard} là ảnh chụp trang web thật của hệ thống (chạy với dữ liệu mẫu).
Sơ đồ bãi là phần chính: 5 ô lớn, ô có xe vẽ hình xe màu đỏ, ô trống hiện chữ P màu
xanh, làn xe với hướng vào/ra; phía trên là số chỗ trống/có xe/tổng. Bên dưới là phần điều
khiển thanh chắn, cảm biến và nhật ký vào/ra kèm giá gửi xe.

\begin{figure}[H]
\centering
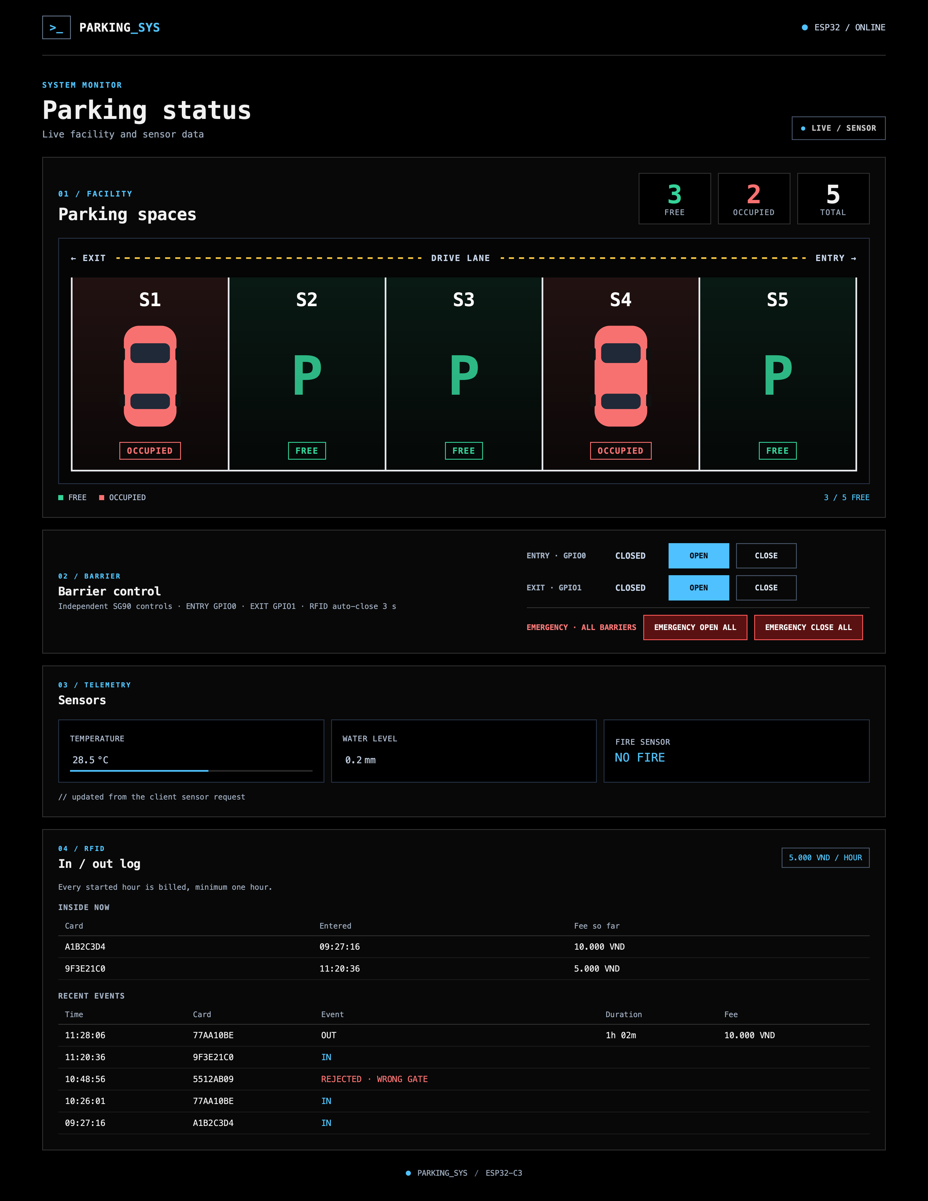
[picture p35: report/dashboard.png]

\caption{Trang web giám sát tại \code{http://parking.local} (dữ liệu mẫu)}\label{fig:dashboard}
\end{figure}

\subsection{Các màn hình TFT}
\begin{figure}[H]
\centering
\setlength{\tabcolsep}{3pt}
\begin{tabular}{ccc}
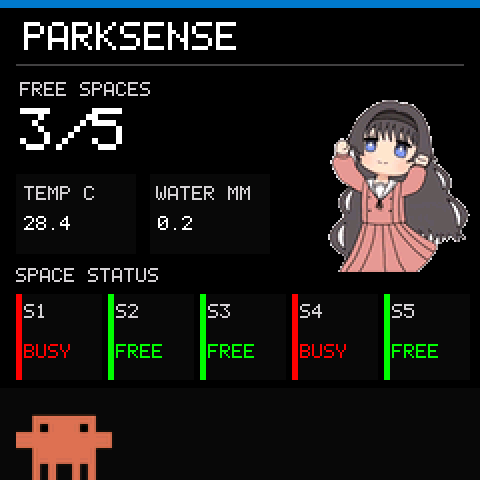
[picture p36: report/photos/tft_main.png]
 &
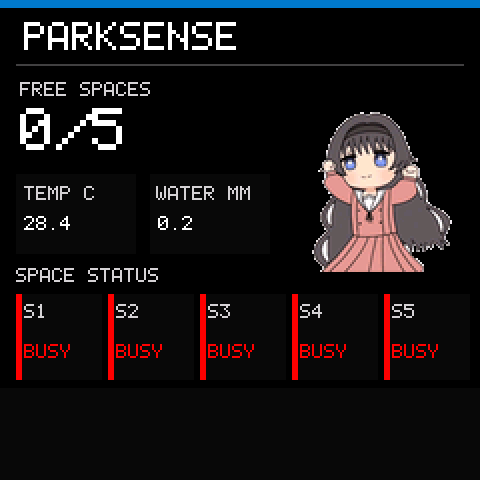
[picture p37: report/photos/tft_full.png]
 &
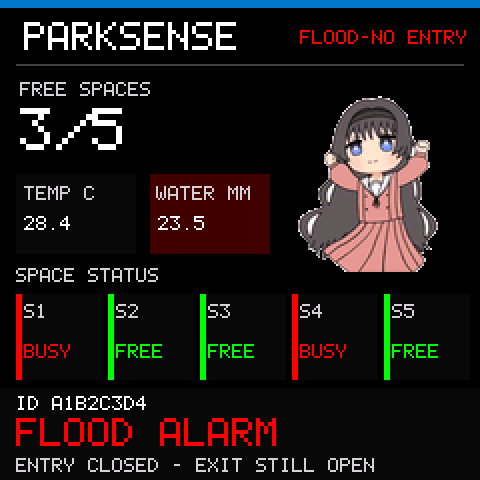
[picture p38: report/photos/tft_flood.png]
 \\
\footnotesize (a) Bình thường & \footnotesize (b) Bãi đầy & \footnotesize (c) Ngập, quẹt vào bị từ chối \\[4pt]
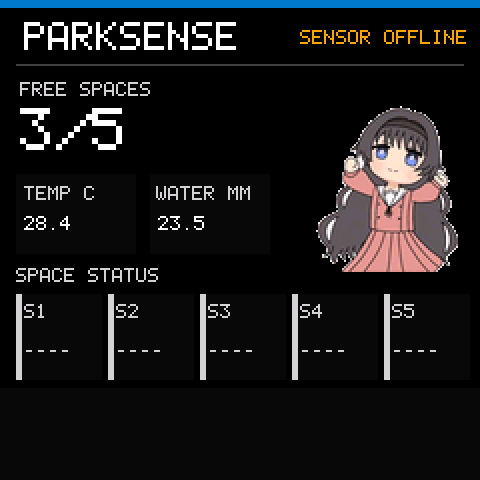
[picture p39: report/photos/tft_offline.png]
 &
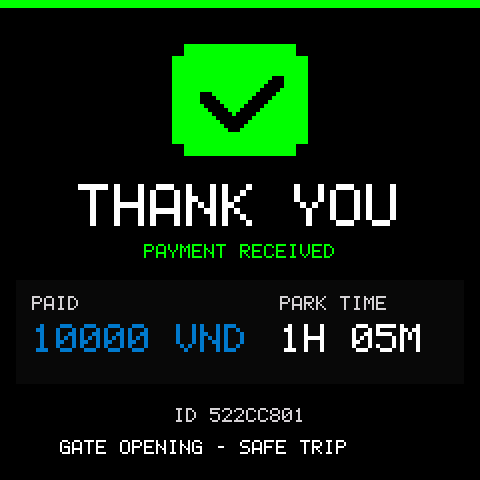
[picture p40: report/photos/tft_thanks.png]
 &
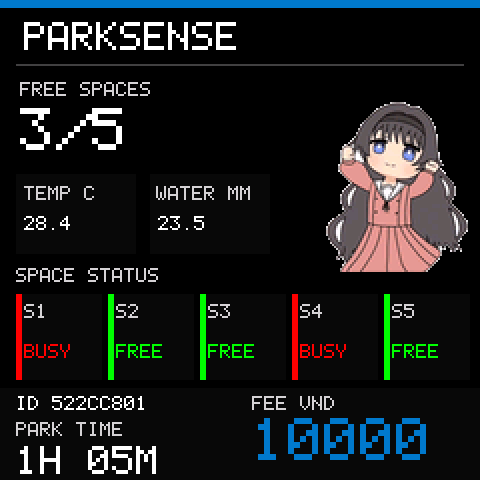
[picture p41: report/photos/tft_receipt.png]
 \\
\footnotesize (d) Cảm biến mất kết nối & \footnotesize (e) Cảm ơn sau khi trả tiền & \footnotesize (f) Hóa đơn ở chân màn hình \\
\end{tabular}
\caption{Các màn hình TFT $240\times240$, kết xuất từ chính mã \file{lcd\_display.c} biên dịch trên máy tính}\label{fig:tft}
\end{figure}
Trên màn hình bình thường: hàng trên là số chỗ trống, hai ô nhiệt độ và mực nước (ô nước chuyển
đỏ khi ngập), ảnh động $96\times96$ ở góc phải; nhãn \code{FLOOD-NO ENTRY} hoặc \code{SENSOR OFFLINE}
hiện ở góc trên; hàng giữa là 5 ô S1–S5 với vạch xanh (trống)/đỏ (có xe); vùng chân dùng cho ảnh
động nhỏ, hóa đơn hoặc thông báo. Khi một lượt trả tiền hoàn tất (SePay hoặc
\emph{Confirm paid}), màn hình \code{THANK YOU} hiện 5\,s trong lúc thanh chắn mở, sau đó hóa đơn
vẫn ở chân màn hình thêm khoảng một phút.

\begin{figure}[H]
\centering

\caption{Màn hình TFT thật trên mô hình khi 4 ô có xe: \code{FREE SPACES 1/5}, S1 trống (xanh), S2–S5 có xe (đỏ), nhiệt độ 27,2\,°C, mực nước 0,0\,mm}\label{fig:tft-live}
\end{figure}

\subsection{Kịch bản demo}
\begin{enumerate}
\item Bật máy chủ, RFID Client, Sensor Client (thứ tự bất kỳ); điện thoại ở cùng mạng Wi-Fi chung mở \code{http://parking.local}.
\item Đặt xe mô hình vào ô S2: ô S2 trên TFT chuyển đỏ ngay, trên web hiện hình xe trong $\le$ 1\,s.
\item Quẹt thẻ ở cổng vào: thanh chắn vào mở rồi tự đóng sau 3\,s; web có dòng \code{IN}.
\item Quẹt lại thẻ đó ở cổng vào: màn hình báo \code{WRONG GATE – ALREADY INSIDE - USE EXIT GATE}.
\item Quẹt thẻ ở cổng ra: TFT hiện mã VietQR; quét bằng ứng dụng ngân hàng và chuyển khoản; vài giây sau hóa đơn hiện trên TFT, thanh chắn ra mở; web có dòng \code{OUT} kèm phí.
\item Đưa bật lửa gần cảm biến lửa: còi kêu, màn hình DANGER, hai thanh chắn mở và không đóng được từ web.
\item Tắt lửa: còi tắt, thanh chắn đóng, màn hình trở lại bình thường.
\end{enumerate}
