thinhdinh25/INT3108_embedded-Smart-Parking-Project/report/photos/box_board.jpg

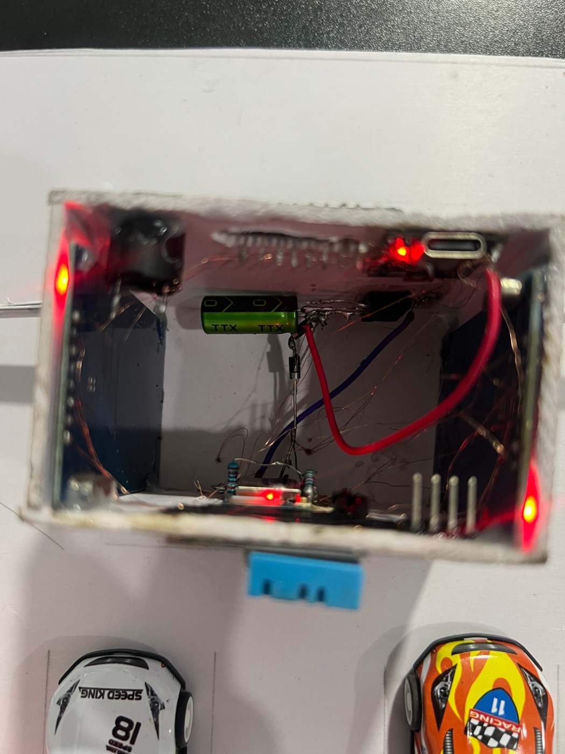
report/photos/box_board.jpg
