thinhdinh25/INT3108_embedded-Smart-Parking-Project/report/photos/model_sensorwall.jpg

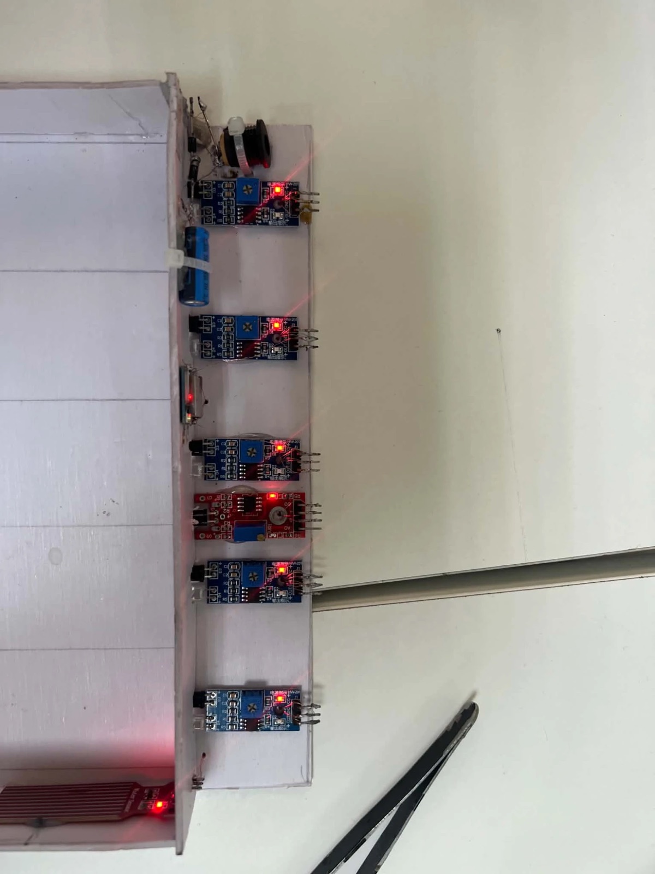
report/photos/model_sensorwall.jpg
