thinhdinh25/INT3108_embedded-Smart-Parking-Project/report/diagrams/testpyramid.pdf

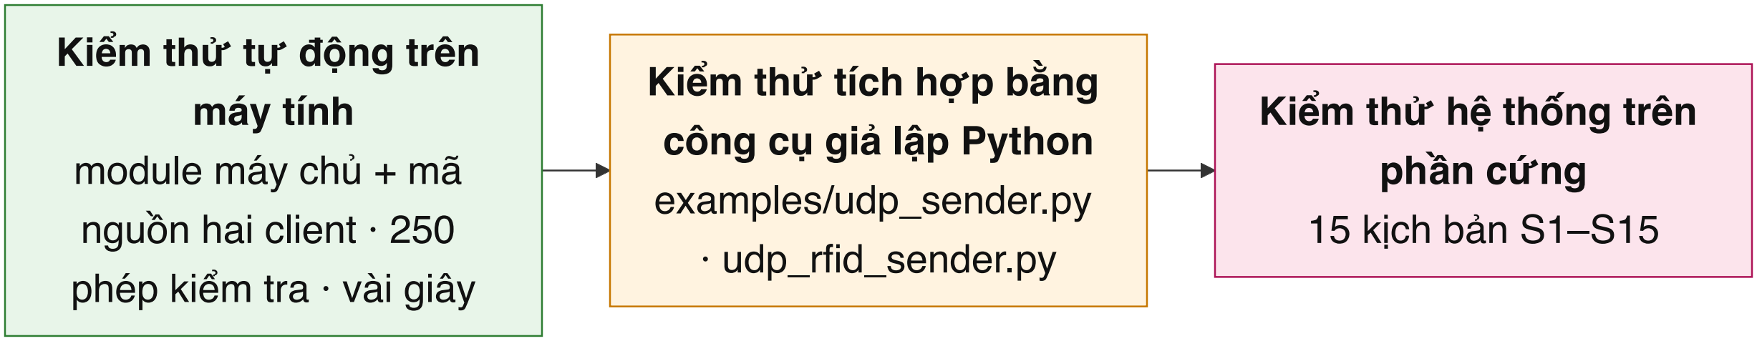
[picture p45: figure]
ống trên; ứng; ịch b; ểm th ử tích h; ằng; công c; ập Python; examples/udp_sender.py; · udp_rfid_sender.py; ự động trên; máy tính module máy ch; ngu; ồn hai client · 250; phép ki; ểm tra · vài giây
