thinhdinh25/INT3108_embedded-Smart-Parking-Project/report/schematic/sheet3.pdf

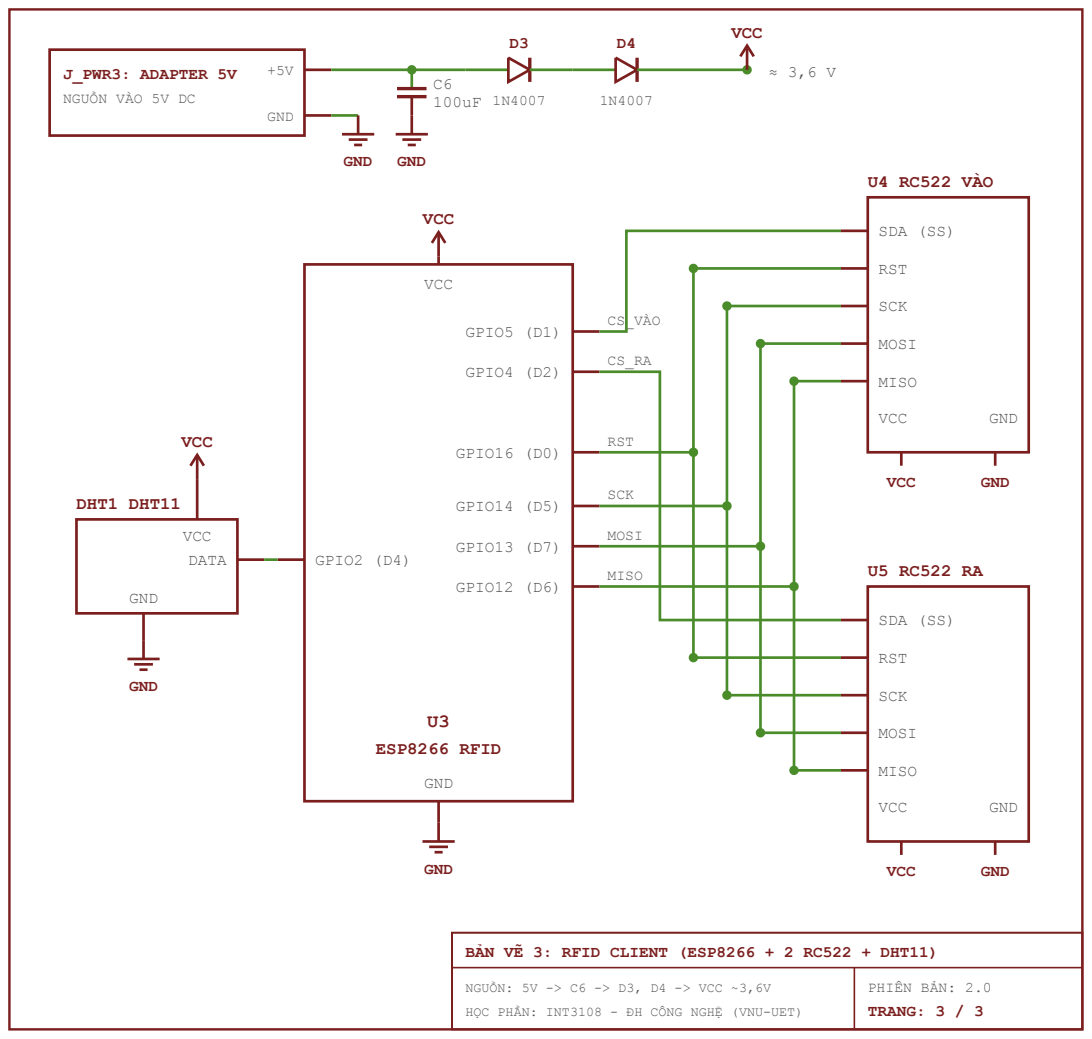
[picture p46: page 1]
GND; VCC; U3 ESP8266 RFID; GPIO5 (D1); CS_VÀO; GPIO4 (D2); GPIO16 (D0); RST; GPIO14 (D5); SCK; GPIO13 (D7); MOSI; GPIO12 (D6); MISO; GPIO2 (D4); DHT1 DHT11; DATA; U4 RC522 VÀO; SDA (SS); PHIÊN BẢN: 2.0 TRANG: 3 / 3

J_PWR3: ADAPTER 5V
NGUỒN VÀO 5V DC

BẢN VẼ 3: RFID CLIENT (ESP8266 + 2 RC522 + DHT11)

NGUỒN: 5V -> C6 -> D3, D4 -> VCC ~3,6V
HỌC PHẦN: INT3108 - ĐH CÔNG NGHỆ (VNU-UET)
