thinhdinh25/INT3108_embedded-Smart-Parking-Project/report/schematic/sheet1.pdf

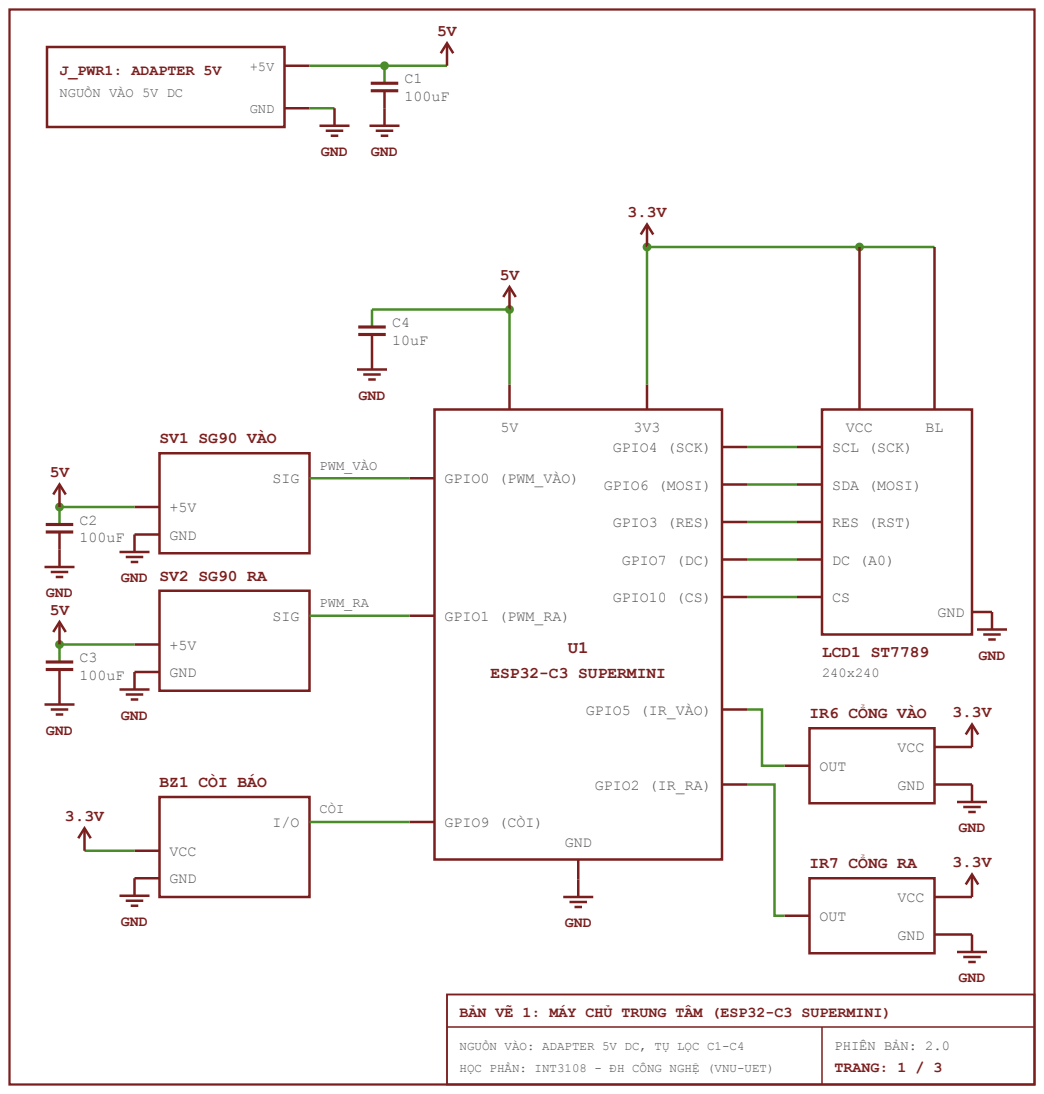
[picture p47: page 1]
GND; U1 ESP32-C3 SUPERMINI; GPIO0 (PWM_VÀO); GPIO1 (PWM_RA); GPIO9 (CÒI); GPIO4 (SCK); GPIO6 (MOSI); GPIO3 (RES); GPIO7 (DC); GPIO10 (CS); GPIO5 (IR_VÀO); GPIO2 (IR_RA); LCD1 ST7789 240x240; SCL (SCK); SDA (MOSI); RES (RST); VCC; SV1 SG90 VÀO; SIG; PWM_VÀO; GND SV2 SG90 RA; PWM_RA; BZ1 CÒI BÁO; CÒI; IR6 CỔNG VÀO; OUT; IR7 CỔNG RA; PHIÊN BẢN: 2.0 TRANG: 1 / 3

J_PWR1: ADAPTER 5V
NGUỒN VÀO 5V DC

BẢN VẼ 1: MÁY CHỦ TRUNG TÂM (ESP32-C3 SUPERMINI)

NGUỒN VÀO: ADAPTER 5V DC, TỤ LỌC C1-C4
HỌC PHẦN: INT3108 - ĐH CÔNG NGHỆ (VNU-UET)
