thinhdinh25/INT3108_embedded-Smart-Parking-Project/report/diagrams/tasks.pdf

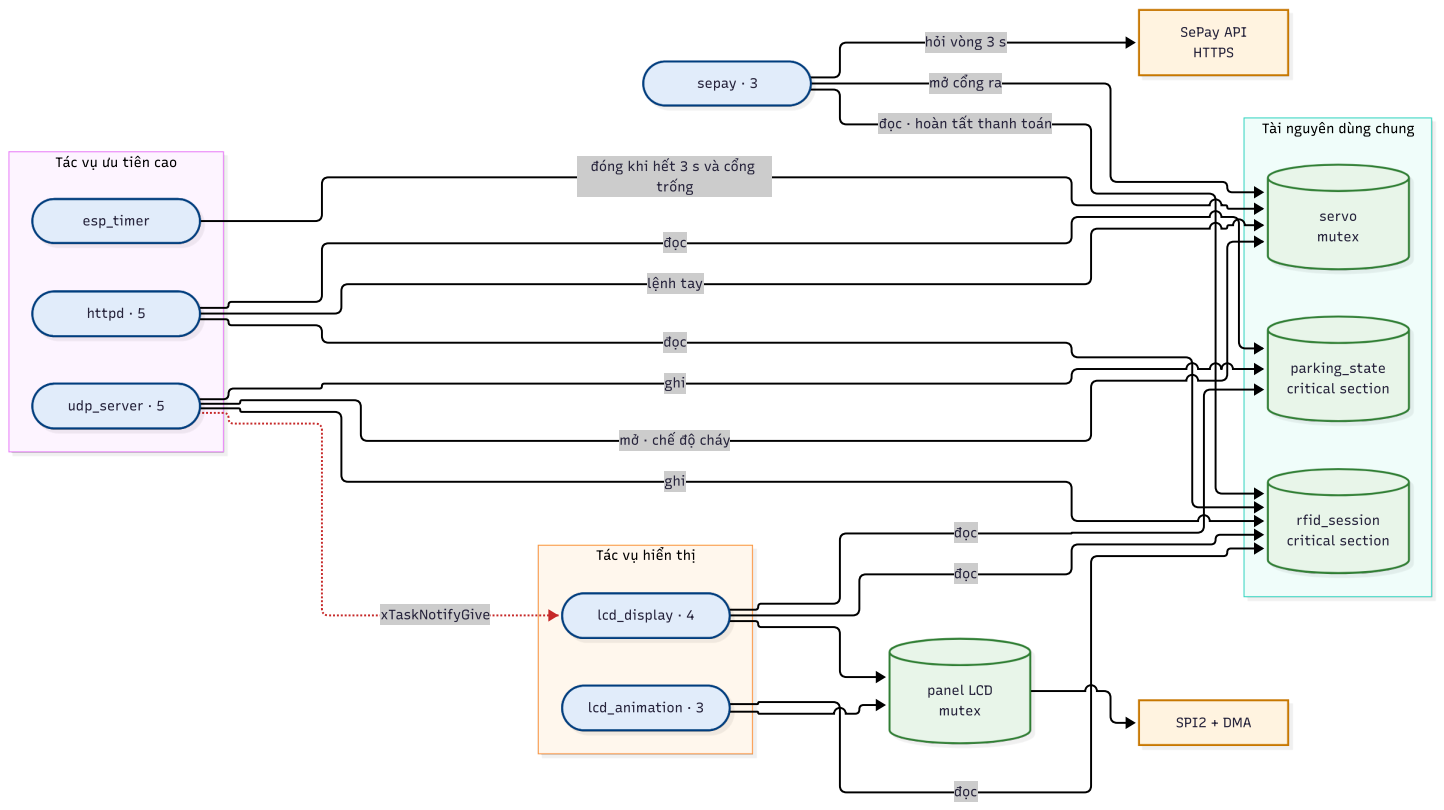
[picture p48: page 1]
ghi; đọc; lệnh tay; trống; xTaskNotifyGive; hỏi vòng 3 s; udp_server · 5; httpd · 5; esp_timer; parking_state; critical section; rfid_session; servo mutex; lcd_display · 4; lcd_animation · 3; sepay · 3; SePay API; HTTPS; SPI2 + DMA

mở cổng ra

đọc · hoàn tất thanh toán

Tài nguyên dùng chung

Tác vụ ưu tiên cao

đóng khi hết 3 s và cổng

mở · chế độ cháy

Tác vụ hiển thị

panel LCD mutex
