thinhdinh25/INT3108_embedded-Smart-Parking-Project/report/diagrams/deps.pdf

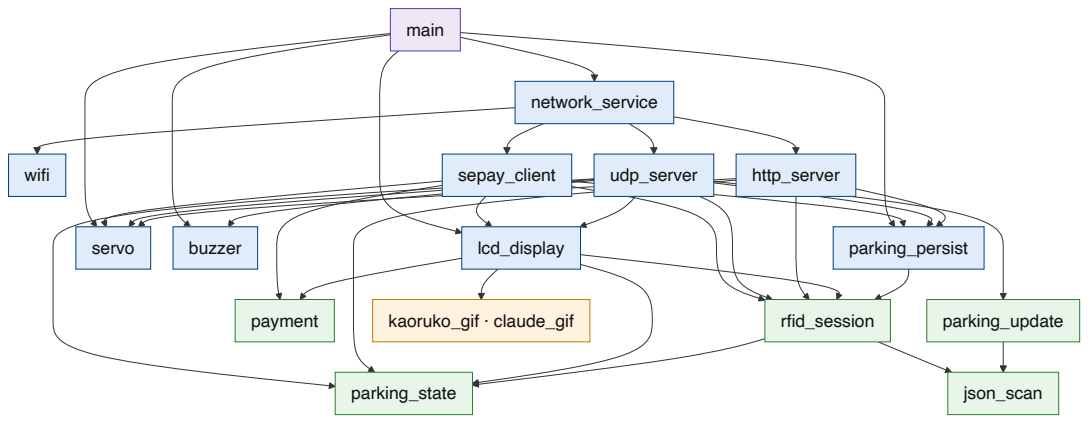
[picture p49: page 1]
main; network_service; servo; buzzer; lcd_display; parking_persist; wifi; sepay_client; udp_server; http_server; payment; rfid_session; parking_state; kaoruko_gif · claude_gif; parking_update; json_scan
