thinhdinh25/INT3108_embedded-Smart-Parking-Project/report/diagrams/boot.pdf

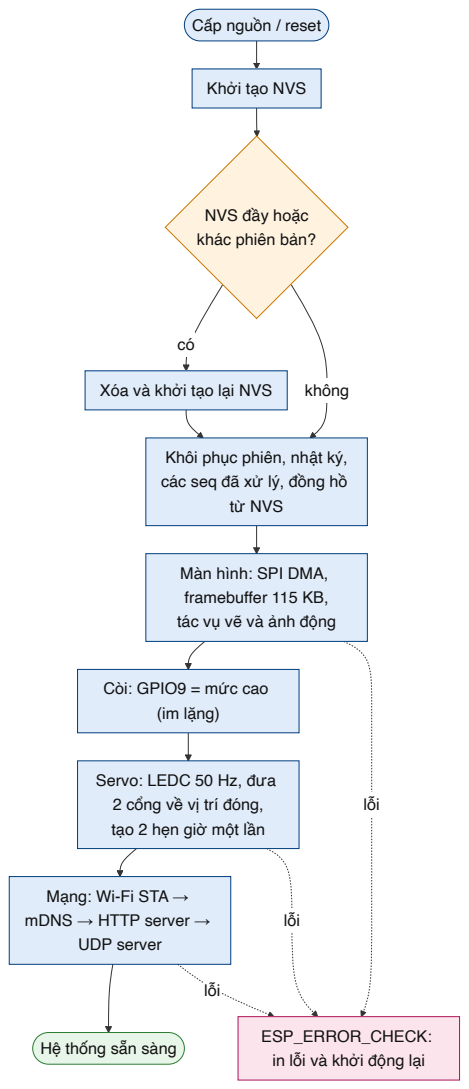
[picture p50: page 1]
không; lỗi; từ NVS; (im lặng); UDP server; Hệ thống sẵn sàng; ESP_ERROR_CHECK:

Cấp nguồn / reset

Khởi tạo NVS

NVS đầy hoặc
khác phiên bản?

Xóa và khởi tạo lại NVS

Khôi phục phiên, nhật ký,
các seq đã xử lý, đồng hồ

Màn hình: SPI DMA,
framebuffer 115 KB,
tác vụ vẽ và ảnh động

Còi: GPIO9 = mức cao

Servo: LEDC 50 Hz, đưa
2 cổng về vị trí đóng,
tạo 2 hẹn giờ một lần

Mạng: Wi-Fi STA →
mDNS → HTTP server →

in lỗi và khởi động lại
