thinhdinh25/INT3108_embedded-Smart-Parking-Project/report/diagrams/fsm_card.pdf

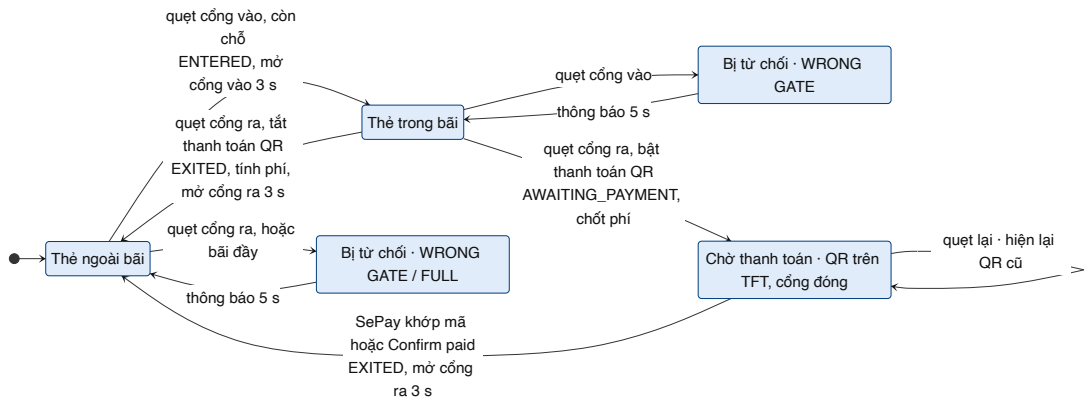
[picture p51: page 1]
chỗ; ENTERED, mở cổng vào 3 s; chốt phí; thông báo 5 s; GATE

quẹt cổng vào, còn

Bị từ chối · WRONG

quẹt cổng vào

quẹt cổng ra, tắt
thanh toán QR
EXITED, tính phí,
mở cổng ra 3 s

Thẻ trong bãi

quẹt cổng ra, bật
AWAITING_PAYMENT,

quẹt cổng ra, hoặc
bãi đầy

quẹt lại · hiện lại

GATE / FULL

Thẻ ngoài bãi

Chờ thanh toán · QR trên
TFT, cổng đóng

SePay khớp mã
hoặc Confirm paid
EXITED, mở cổng
