thinhdinh25/INT3108_embedded-Smart-Parking-Project/report/diagrams/usecase.pdf

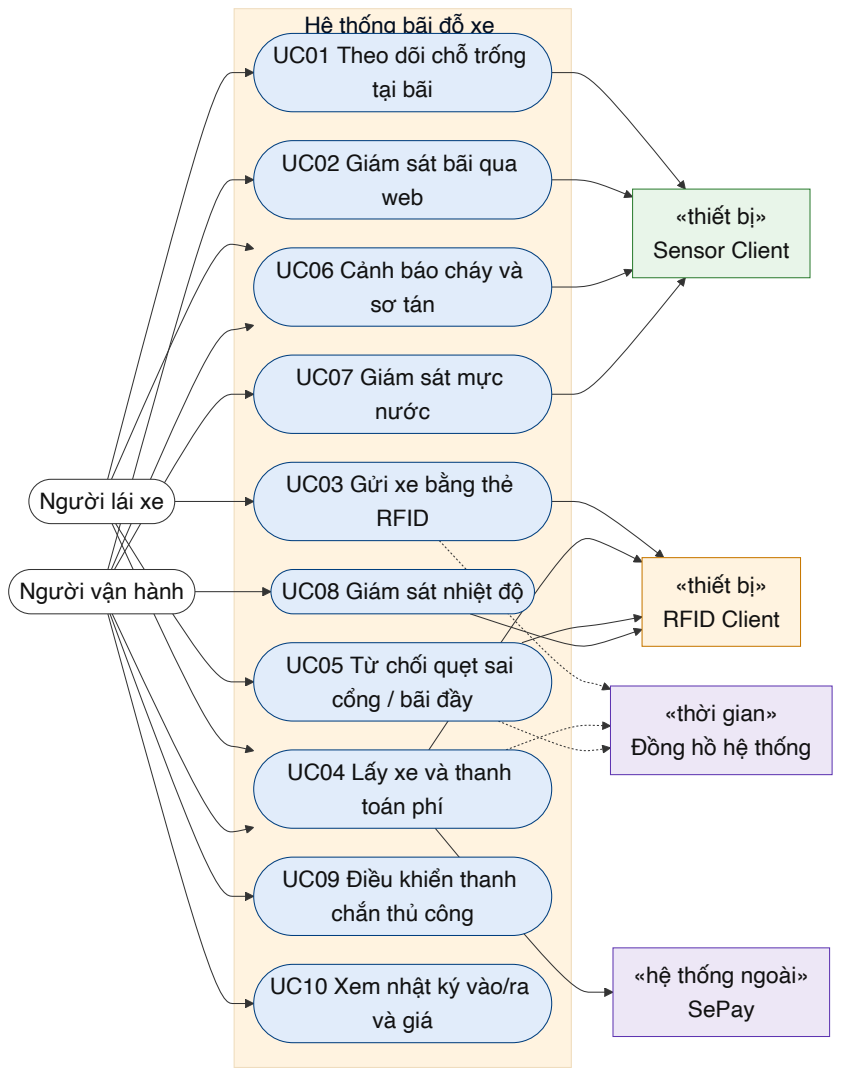
[picture p52: page 1]
thông minh tại bãi; web; RFID; toán phí; sơ tán; nước; và giá; «thiết bị»; Sensor Client; RFID Client

Hệ thống bãi đỗ xe
UC01 Theo dõi chỗ trống

UC02 Giám sát bãi qua

UC06 Cảnh báo cháy và

UC07 Giám sát mực

UC03 Gửi xe bằng thẻ

Người lái xe

Người vận hành

UC08 Giám sát nhiệt độ

UC05 Từ chối quẹt sai
cổng / bãi đầy

«thời gian»
Đồng hồ hệ thống

UC04 Lấy xe và thanh

UC09 Điều khiển thanh
chắn thủ công

«hệ thống ngoài»
SePay

UC10 Xem nhật ký vào/ra
