thinhdinh25/INT3108_embedded-Smart-Parking-Project/report/diagrams/udpflow.pdf

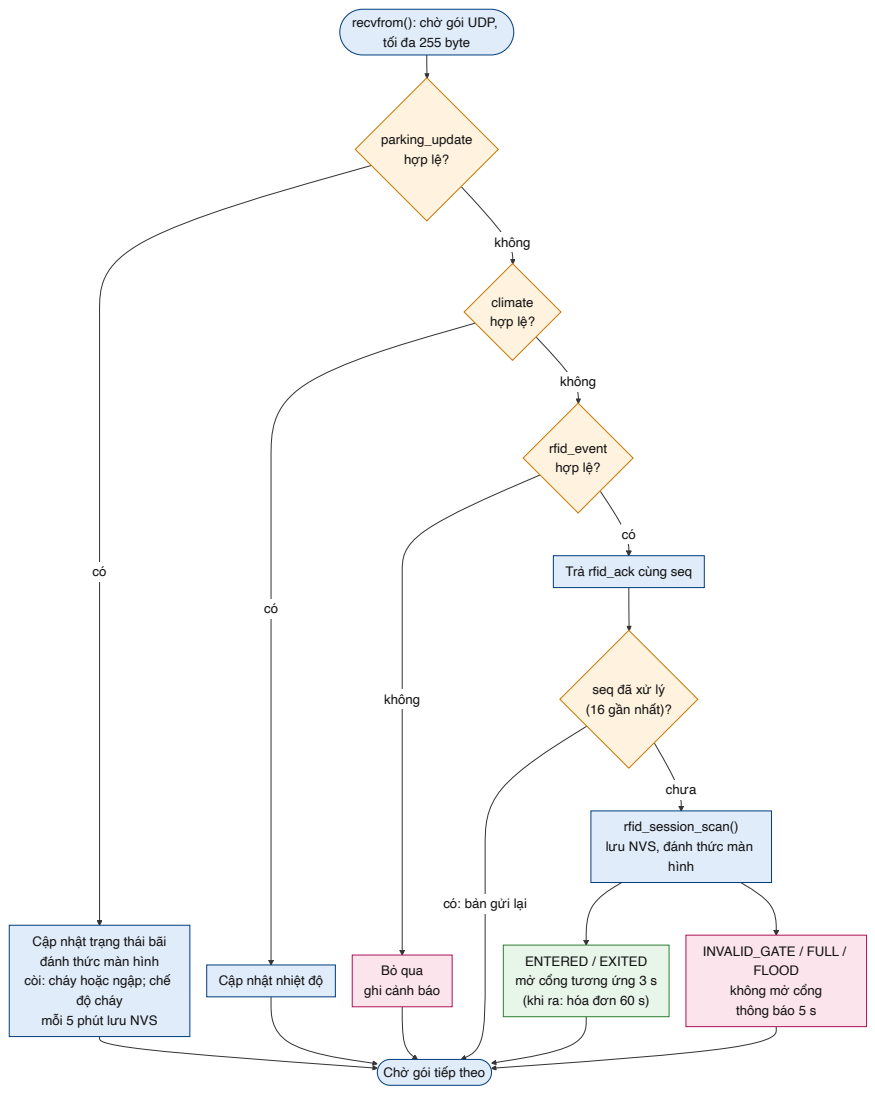
[picture p53: page 1]
không; chưa; parking_update; hợp lệ?; climate; rfid_event hợp lệ?; hình; INVALID_GATE / FULL /

recvfrom(): chờ gói UDP,
tối đa 255 byte

Trả rfid_ack cùng seq

seq đã xử lý
(16 gần nhất)?

rfid_session_scan()
lưu NVS, đánh thức màn

có: bản gửi lại

Cập nhật trạng thái bãi
đánh thức màn hình
còi: cháy hoặc ngập; chế

ENTERED / EXITED
mở cổng tương ứng 3 s
(khi ra: hóa đơn 60 s)

Bỏ qua
ghi cảnh báo

FLOOD
không mở cổng
thông báo 5 s

Cập nhật nhiệt độ

độ cháy
mỗi 5 phút lưu NVS

Chờ gói tiếp theo
