thinhdinh25/INT3108_embedded-Smart-Parking-Project/report/diagrams/fsm_footer.pdf

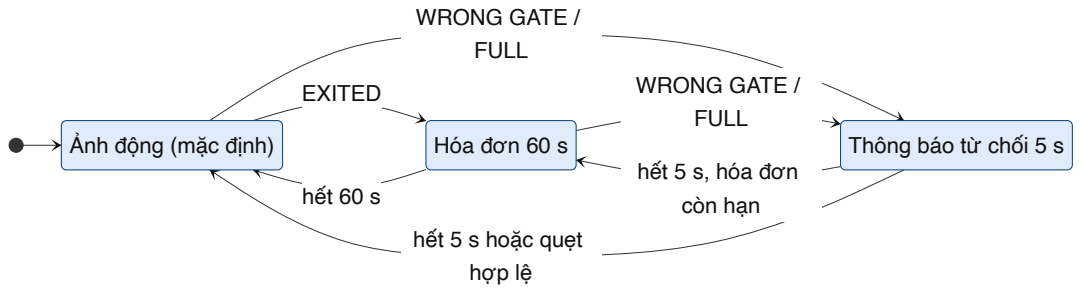
[picture p54: page 1]
EXITED; hết 60 s; WRONG GATE /; FULL; Ảnh động (mặc định); Hóa đơn 60 s; Thông báo từ chối 5 s

hết 5 s, hóa đơn
còn hạn

hết 5 s hoặc quẹt
hợp lệ
