thinhdinh25/INT3108_embedded-Smart-Parking-Project/report/diagrams/fsm_gate.pdf

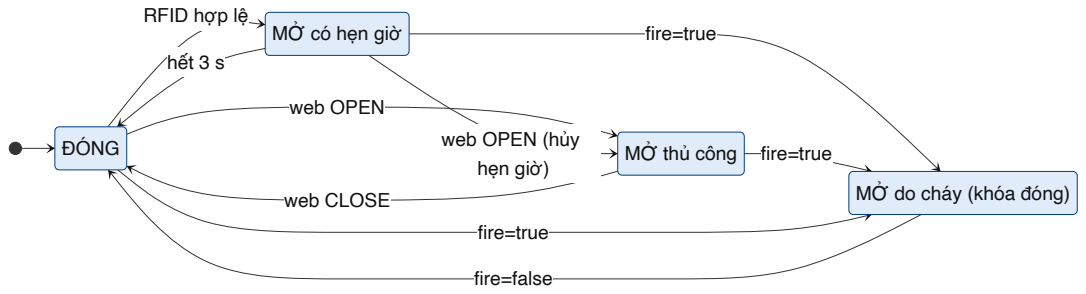
[picture p55: page 1]
hết 3 s; web OPEN; web CLOSE; fire=true; fire=false; ĐÓNG

RFID hợp lệ

MỞ có hẹn giờ

web OPEN (hủy
hẹn giờ)

MỞ thủ công

MỞ do cháy (khóa đóng)
