thinhdinh25/INT3108_embedded-Smart-Parking-Project/Server/main/display/lcd_display.c

#include <stdio.h>
#include <stdlib.h>
#include <stdint.h>
#include <string.h>
#include <stdbool.h>

#include "driver/gpio.h"
#include "driver/spi_master.h"
#include "esp_err.h"
#include "esp_check.h"
#include "esp_heap_caps.h"
#include "esp_lcd_io_spi.h"
#include "esp_lcd_panel_ops.h"
#include "esp_lcd_panel_st7789.h"
#include "esp_log.h"
#include "esp_timer.h"
#include "qrcode.h"
#include "freertos/FreeRTOS.h"
#include "freertos/task.h"
#include "freertos/semphr.h"
#include "sdkconfig.h"

#include "../parking/parking_state.h"
#include "../buzzer/buzzer.h"
#include "../parking/payment.h"
#include "../parking/rfid_session.h"
#include "lcd_display.h"
#include "kaoruko_gif.h"
#include "claude_gif.h"

#define LCD_SPI_HOST SPI2_HOST
#define LCD_SPI_CLOCK_HZ (40 * 1000 * 1000)
#define PIXEL_BYTES 2
#define LCD_WIDTH 240
#define LCD_HEIGHT 240

/* Kaoruko picture-in-picture area below the header on the right. */
#define GIF_X 144
#define GIF_Y 40
#define GIF_WIDTH KAORUKO_WIDTH
#define GIF_HEIGHT KAORUKO_HEIGHT
#define GIF_BUFFERS 2
/* Kaoruko is the larger GIF; the Claude sprite reuses the same DMA buffers. */
#define GIF_PIXELS ((size_t)GIF_WIDTH * GIF_HEIGHT)
#define CLAUDE_Y 194
#define THANKS_US (5 * 1000000LL) /* thank-you screen after a paid exit */

static const char *TAG = "LCD_DISPLAY";
static esp_lcd_panel_handle_t panel;
static uint16_t *framebuffer;
static uint16_t *gif_framebuffer[GIF_BUFFERS];
static int gif_buffer_index = 0;
static SemaphoreHandle_t lcd_mutex;
static TaskHandle_t display_task_handle;
static volatile bool parking_screen_shown; /* only that screen has room for the animation */
static const int width = LCD_WIDTH;
static const int height = LCD_HEIGHT;

static const uint16_t COLOR_BG = 0x0000;
static const uint16_t COLOR_PANEL = 0x0841;
static const uint16_t COLOR_LINE = 0x4208;
static const uint16_t COLOR_WHITE = 0xFFFF;
static const uint16_t COLOR_MUTED = 0xD69A;
static const uint16_t COLOR_TEAL = 0x03D9;
static const uint16_t COLOR_GREEN = 0x07E0;
static const uint16_t COLOR_RED = 0xF800;
static const uint16_t COLOR_DARK_RED = 0x4000;
static const uint16_t COLOR_ORANGE = 0xFD20;
static const uint16_t COLOR_YELLOW = 0xFFE0;
static const uint16_t COLOR_BLUE = 0x001F;

static uint16_t rgb565_byte_swap(uint16_t color)
{
    return (uint16_t)((color << 8) | (color >> 8));
}

/* Five vertical 5x7 columns for A-Z and 0-9. */
static const uint8_t glyphs[36][5] = {
    {0x7E,0x11,0x11,0x11,0x7E},{0x7F,0x49,0x49,0x49,0x36},
    {0x3E,0x41,0x41,0x41,0x22},{0x7F,0x41,0x41,0x22,0x1C},
    {0x7F,0x49,0x49,0x49,0x41},{0x7F,0x09,0x09,0x09,0x01},
    {0x3E,0x41,0x49,0x49,0x7A},{0x7F,0x08,0x08,0x08,0x7F},
    {0x00,0x41,0x7F,0x41,0x00},{0x20,0x40,0x41,0x3F,0x01},
    {0x7F,0x08,0x14,0x22,0x41},{0x7F,0x40,0x40,0x40,0x40},
    {0x7F,0x02,0x0C,0x02,0x7F},{0x7F,0x04,0x08,0x10,0x7F},
    {0x3E,0x41,0x41,0x41,0x3E},{0x7F,0x09,0x09,0x09,0x06},
    {0x3E,0x41,0x51,0x21,0x5E},{0x7F,0x09,0x19,0x29,0x46},
    {0x46,0x49,0x49,0x49,0x31},{0x01,0x01,0x7F,0x01,0x01},
    {0x3F,0x40,0x40,0x40,0x3F},{0x1F,0x20,0x40,0x20,0x1F},
    {0x3F,0x40,0x38,0x40,0x3F},{0x63,0x14,0x08,0x14,0x63},
    {0x07,0x08,0x70,0x08,0x07},{0x61,0x51,0x49,0x45,0x43},
    {0x3E,0x51,0x49,0x45,0x3E},{0x00,0x42,0x7F,0x40,0x00},
    {0x42,0x61,0x51,0x49,0x46},{0x21,0x41,0x45,0x4B,0x31},
    {0x18,0x14,0x12,0x7F,0x10},{0x27,0x45,0x45,0x45,0x39},
    {0x3C,0x4A,0x49,0x49,0x30},{0x01,0x71,0x09,0x05,0x03},
    {0x36,0x49,0x49,0x49,0x36},{0x06,0x49,0x49,0x29,0x1E},
};

static void fill_rect(int x, int y, int w, int h, uint16_t color)
{
    /* Clip once and swap once instead of per pixel. */
    int x0 = x < 0 ? 0 : x, y0 = y < 0 ? 0 : y;
    int x1 = x + w > width ? width : x + w;
    int y1 = y + h > height ? height : y + h;
    if (x0 >= x1 || y0 >= y1)
        return;

    const uint16_t swapped = rgb565_byte_swap(color);
    for (int row = y0; row < y1; ++row)
    {
        uint16_t *dst = &framebuffer[row * width + x0];
        for (int n = x1 - x0; n > 0; --n)
            *dst++ = swapped;
    }
}

static void draw_char(int x, int y, char c, int scale, uint16_t color)
{
    const uint8_t *glyph = NULL;
    if (c >= 'A' && c <= 'Z') glyph = glyphs[(int)(c - 'A')];
    else if (c >= '0' && c <= '9') glyph = glyphs[26 + (int)(c - '0')];

    if (glyph != NULL)
    {
        for (int col = 0; col < 5; ++col)
            for (int row = 0; row < 7; ++row)
                if (glyph[col] & (1U << row))
                    fill_rect(x + col * scale, y + row * scale, scale, scale, color);
    }
    else if (c == '/')
    {
        for (int i = 0; i < 7; ++i)
            fill_rect(x + (6 - i) * scale, y + i * scale, scale, scale, color);
    }
    else if (c == '.')
    {
        fill_rect(x + 2 * scale, y + 6 * scale, scale, scale, color);
    }
    else if (c == ':')
    {
        fill_rect(x + 2 * scale, y + 2 * scale, scale, scale, color);
        fill_rect(x + 2 * scale, y + 5 * scale, scale, scale, color);
    }
    else if (c == '-')
    {
        fill_rect(x + scale, y + 3 * scale, 3 * scale, scale, color);
    }
}

static void draw_text(int x, int y, const char *text, int scale, uint16_t color)
{
    for (size_t i = 0; text[i] != '\0'; ++i)
        draw_char(x + (int)i * 6 * scale, y, text[i], scale, color);
}

static void format_tenths(char *out, size_t out_size, float value)
{
    int tenths = (int)(value * 10.0f + (value >= 0.0f ? 0.5f : -0.5f));
    int magnitude = abs(tenths);
    snprintf(out, out_size, "%s%d.%d", tenths < 0 ? "-" : "",
             magnitude / 10, magnitude % 10);
}

static esp_err_t lcd_draw_bitmap_locked(int x_start, int y_start,
                                        int x_end, int y_end,
                                        const void *pixels)
{
    if (xSemaphoreTake(lcd_mutex, portMAX_DELAY) != pdTRUE)
        return ESP_ERR_TIMEOUT;

    esp_err_t err = esp_lcd_panel_draw_bitmap(
        panel, x_start, y_start, x_end, y_end, pixels);

    xSemaphoreGive(lcd_mutex);
    return err;
}

/* Checked under the mutex: a frame decoded just before another screen took over is dropped,
 * otherwise it would stay on top of that screen until its next redraw. */
static esp_err_t gif_draw_bitmap(int x_start, int y_start, int x_end, int y_end,
                                 const void *pixels)
{
    if (xSemaphoreTake(lcd_mutex, portMAX_DELAY) != pdTRUE)
        return ESP_ERR_TIMEOUT;

    esp_err_t err = parking_screen_shown
        ? esp_lcd_panel_draw_bitmap(panel, x_start, y_start, x_end, y_end, pixels)
        : ESP_OK;

    xSemaphoreGive(lcd_mutex);
    return err;
}

static void draw_notice(const rfid_notice_t *notice)
{
    char line[RFID_CARD_ID_MAX + 5];
    snprintf(line, sizeof(line), "ID %s", notice->card_id);
    draw_text(8, 198, line, 1, COLOR_WHITE);
    if (notice->result == RFID_SCAN_PAY_TIMEOUT)
    {
        draw_text(8, 209, "PAY AT BOOTH", 2, COLOR_ORANGE);
        draw_text(8, 229, "NO TRANSFER YET - SEE OPERATOR", 1, COLOR_MUTED);
    }
    else if (notice->result == RFID_SCAN_PAY_BUSY)
    {
        draw_text(8, 209, "PLEASE WAIT", 2, COLOR_ORANGE);
        draw_text(8, 229, "ANOTHER CAR IS PAYING", 1, COLOR_MUTED);
    }
    else if (notice->result == RFID_SCAN_FLOOD)
    {
        draw_text(8, 209, "FLOOD ALARM", 2, COLOR_RED);
        draw_text(8, 229, "ENTRY CLOSED - EXIT STILL OPEN", 1, COLOR_MUTED);
    }
    else if (notice->result == RFID_SCAN_FULL)
    {
        draw_text(8, 209, "PARKING FULL", 2, COLOR_RED);
        draw_text(8, 229, "NO FREE SPACE - PLEASE WAIT", 1, COLOR_MUTED);
    }
    else
    {
        draw_text(8, 209, "WRONG GATE", 2, COLOR_RED);
        /* Entry reader while already inside, or exit reader without having entered. */
        draw_text(8, 229, notice->gate == RFID_GATE_IN ? "ALREADY INSIDE - USE EXIT GATE"
                                                       : "NOT CHECKED IN - USE ENTRY GATE",
                  1, COLOR_MUTED);
    }
}

/* esp_qrcode_generate calls back synchronously; this is where the QR goes on screen. */
static int qr_top;

static void draw_qr_modules(esp_qrcode_handle_t qr)
{
    const int size = esp_qrcode_get_size(qr);
    const int scale = 156 / (size + 4) > 0 ? 156 / (size + 4) : 1; /* 2-module quiet zone */
    const int box = (size + 4) * scale;
    const int left = (width - box) / 2;
    fill_rect(left, qr_top, box, box, COLOR_WHITE);
    for (int y = 0; y < size; ++y)
        for (int x = 0; x < size; ++x)
            if (esp_qrcode_get_module(qr, x, y))
                fill_rect(left + (x + 2) * scale, qr_top + (y + 2) * scale, scale, scale, COLOR_BG);
}

/* VietQR for the exit fee: any Vietnamese banking app can scan it. */
static void draw_payment_screen(const rfid_payment_t *pay, const rfid_notice_t *notice)
{
    fill_rect(0, 0, width, height, COLOR_BG);
    fill_rect(0, 0, width, 4, COLOR_TEAL);
    draw_text(54, 9, "SCAN TO PAY", 2, COLOR_WHITE);

    char payload[160];
    if (vietqr_payload(payload, sizeof(payload), CONFIG_PARKING_PAY_BANK_BIN, CONFIG_PARKING_PAY_VA,
                       pay->fee_vnd, pay->code) > 0)
    {
        esp_qrcode_config_t config = ESP_QRCODE_CONFIG_DEFAULT();
        config.display_func = draw_qr_modules;
        config.max_qrcode_version = 10;
        config.qrcode_ecc_level = ESP_QRCODE_ECC_MED;
        qr_top = 30;
        esp_qrcode_generate(&config, payload);
    }
    else
    {
        /* No receiving account in menuconfig: the fee is still owed, paid at the booth. */
        draw_text(42, 90, "PAY AT BOOTH", 2, COLOR_ORANGE);
        draw_text(36, 120, "OPERATOR OPENS THE GATE", 1, COLOR_MUTED);
    }

    char line[40];
    snprintf(line, sizeof(line), "%lu VND", (unsigned long)pay->fee_vnd);
    draw_text((width - (int)strlen(line) * 12) / 2, 192, line, 2, COLOR_TEAL);
    snprintf(line, sizeof(line), "NOTE %s  ID %.12s", pay->code, pay->card_id);
    draw_text(8, 214, line, 1, COLOR_WHITE);
    /* A second car at the exit gets its answer without taking the QR away from the first. */
    if (notice->valid && notice->result == RFID_SCAN_PAY_BUSY)
        draw_text(8, 227, "NEXT CAR: WAIT, ONE IS PAYING", 1, COLOR_ORANGE);
    else
    {
        snprintf(line, sizeof(line), "BIDV %.16s %.12s", CONFIG_PARKING_PAY_VA, CONFIG_PARKING_PAY_ACCOUNT_NAME);
        draw_text(8, 227, line, 1, COLOR_MUTED);
    }
    ESP_ERROR_CHECK(lcd_draw_bitmap_locked(0, 0, width, height, framebuffer));
}

/* Bottom 46 px: a rejection notice (5 s) first, otherwise the exit receipt. */
static void draw_footer(const rfid_receipt_t *receipt, const rfid_notice_t *notice)
{
    fill_rect(0, 194, width, 46, COLOR_PANEL);
    if (notice->valid)
        draw_notice(notice);
    else if (receipt->valid)
    {
        char line[RFID_CARD_ID_MAX + 5];
        char duration[16], fee[16];
        uint64_t total_minutes = ((uint64_t)receipt->duration_seconds + 59U) / 60U;
        uint64_t hours = total_minutes / 60U;
        uint64_t minutes = total_minutes % 60U;
        snprintf(line, sizeof(line), "ID %s", receipt->card_id);
        draw_text(8, 198, line, 1, COLOR_WHITE);
        draw_text(8, 211, "PARK TIME", 1, COLOR_MUTED);
        snprintf(duration, sizeof(duration), "%lluH %02lluM",
                 (unsigned long long)hours, (unsigned long long)minutes);
        int duration_scale = strlen(duration) <= 8 ? 2 : 1;
        draw_text(8, 223, duration, duration_scale, COLOR_WHITE);

        draw_text(126, 198, "FEE VND", 1, COLOR_MUTED);
        snprintf(fee, sizeof(fee), "%u", (unsigned)receipt->fee_vnd);
        int fee_scale = strlen(fee) <= 5 ? 3 : (strlen(fee) <= 8 ? 2 : 1);
        draw_text(126, fee_scale == 3 ? 209 : 216, fee, fee_scale, COLOR_TEAL);
    }
}

static void format_duration(char *out, size_t out_size, uint32_t seconds)
{
    uint64_t total_minutes = ((uint64_t)seconds + 59U) / 60U;
    snprintf(out, out_size, "%lluH %02lluM", (unsigned long long)(total_minutes / 60U),
             (unsigned long long)(total_minutes % 60U));
}

/* Full screen for a few seconds after the fee is paid, while the exit barrier opens. */
static void draw_thanks_screen(const rfid_receipt_t *receipt)
{
    fill_rect(0, 0, width, height, COLOR_BG);
    fill_rect(0, 0, width, 4, COLOR_GREEN);

    /* Tick in a green disc, built from square steps like the rest of the UI. */
    fill_rect(92, 22, 56, 56, COLOR_GREEN);
    fill_rect(86, 28, 68, 44, COLOR_GREEN);
    for (int i = 0; i < 8; ++i)
        fill_rect(100 + i * 2, 46 + i * 2, 6, 6, COLOR_BG);
    for (int i = 0; i < 12; ++i)
        fill_rect(114 + i * 2, 60 - i * 2, 6, 6, COLOR_BG);

    draw_text(39, 92, "THANK YOU", 3, COLOR_WHITE);
    draw_text(72, 122, "PAYMENT RECEIVED", 1, COLOR_GREEN);

    fill_rect(8, 140, width - 16, 52, COLOR_PANEL);
    char fee[16], duration[16];
    snprintf(fee, sizeof(fee), "%u VND", (unsigned)receipt->fee_vnd);
    format_duration(duration, sizeof(duration), receipt->duration_seconds);
    draw_text(16, 148, "PAID", 1, COLOR_MUTED);
    draw_text(16, 162, fee, 2, COLOR_TEAL);
    draw_text(140, 148, "PARK TIME", 1, COLOR_MUTED);
    draw_text(140, 162, duration, 2, COLOR_WHITE);

    char line[RFID_CARD_ID_MAX + 5];
    snprintf(line, sizeof(line), "ID %s", receipt->card_id);
    draw_text((width - (int)strlen(line) * 6) / 2, 204, line, 1, COLOR_MUTED);
    draw_text(30, 220, "GATE OPENING - SAFE TRIP", 1, COLOR_WHITE);
    ESP_ERROR_CHECK(lcd_draw_bitmap_locked(0, 0, width, height, framebuffer));
}

/* Layout with the 96x96 Kaoruko animation in the top-right corner (GIF_X, GIF_Y). */
static void draw_parking_screen(const parking_state_t *state, int free_count,
                                const rfid_receipt_t *receipt, const rfid_notice_t *notice,
                                bool lot_alarm)
{
    fill_rect(0, 0, width, height, COLOR_BG);
    fill_rect(0, 0, width, 4, COLOR_TEAL);

    draw_text(12, 11, "PARKSENSE", 2, COLOR_WHITE);
    /* Status tag: flood matters most; a silent sensor means the bays below are stale. */
    if (state->flood)
        draw_text(150, 15, "FLOOD-NO ENTRY", 1, COLOR_RED);
    else if (lot_alarm)
        draw_text(150, 15, "CAR W/O CARD", 1, COLOR_RED);
    else if (state->received && !state->online)
        draw_text(150, 15, "SENSOR OFFLINE", 1, COLOR_ORANGE);
    fill_rect(8, 32, width - 16, 1, COLOR_LINE);

    /* Main availability indicator. */
    draw_text(10, 41, "FREE SPACES", 1, COLOR_MUTED);
    char free_text[8];
    snprintf(free_text, sizeof(free_text), "%d/5", free_count);
    draw_text(10, 54, free_text, 3, COLOR_WHITE);

    /* Sensor values. */
    fill_rect(8, 87, 60, 40, COLOR_PANEL);
    fill_rect(75, 87, 60, 40, state->flood ? COLOR_DARK_RED : COLOR_PANEL);
    draw_text(12, 93, "TEMP C", 1, COLOR_MUTED);
    draw_text(78, 93, "WATER MM", 1, COLOR_MUTED);

    char temperature[16] = "--.-";
    char water[16] = "--.-";
    if (state->temperature_received)
        format_tenths(temperature, sizeof(temperature), state->temperature_c);
    if (state->received)
        format_tenths(water, sizeof(water), state->water_mm);
    draw_text(12, 108, temperature, 1, COLOR_WHITE);
    draw_text(79, 108, water, 1, COLOR_WHITE);

    /* Larger slot indicators span the full display width below the sensors. */
    draw_text(8, 134, "SPACE STATUS", 1, COLOR_MUTED);
    for (int i = 0; i < PARKING_SLOT_COUNT; ++i)
    {
        int x = 8 + i * 46;
        bool occupied = state->slots[i] != 0;

        fill_rect(x, 147, 43, 43, COLOR_PANEL);
        const uint16_t color = !state->online ? COLOR_MUTED : occupied ? COLOR_RED : COLOR_GREEN;
        fill_rect(x, 147, 3, 43, color);

        char slot_label[3] = {'S', (char)('1' + i), '\0'};
        draw_text(x + 4, 152, slot_label, 1, COLOR_MUTED);
        draw_text(x + 4, 172, !state->online ? "----" : occupied ? "BUSY" : "FREE", 1, color);
    }

    draw_footer(receipt, notice);
    ESP_ERROR_CHECK(lcd_draw_bitmap_locked(0, 0, width, height, framebuffer));
}

static void draw_flame(int center_x, int bottom_y, int frame, int scale)
{
    static const uint8_t widths[] = {7, 12, 15, 16, 14, 10, 7, 4};
    int sway = ((frame % 5) - 2) * scale;
    int flicker = (frame % 3) * scale;

    for (int row = 0; row < (int)(sizeof(widths) / sizeof(widths[0])); ++row)
    {
        int w = widths[row] * scale;
        int y = bottom_y - (row + 1) * 5 * scale + flicker;
        int x = center_x + sway - w / 2;
        fill_rect(x, y, w, 5 * scale, row < 3 ? COLOR_RED : COLOR_ORANGE);

        if (row >= 1 && row <= 5)
        {
            int inner_w = w / 2;
            fill_rect(center_x + sway / 2 - inner_w / 2,
                      y + 2 * scale, inner_w, 3 * scale,
                      row < 3 ? COLOR_ORANGE : COLOR_YELLOW);
        }
    }
}

static void draw_fire_alarm_screen(int frame)
{
    fill_rect(0, 0, width, height, COLOR_BG);
    fill_rect(0, 0, width, 8, COLOR_RED);
    fill_rect(0, height - 8, width, 8, COLOR_RED);
    fill_rect(8, 8, 4, height - 16, COLOR_RED);
    fill_rect(width - 12, 8, 4, height - 16, COLOR_RED);
    fill_rect(16, 16, width - 32, height - 32, COLOR_DARK_RED);
    draw_text(58, 25, "DANGER", 3, COLOR_WHITE);
    draw_flame(120 - ((frame % 5) - 2) * 3, 153, frame, 2);
    draw_flame(66 + ((frame % 5) - 2) * 2, 148, frame + 2, 1);
    draw_flame(174 - ((frame % 5) - 2) * 2, 148, frame + 3, 1);
    fill_rect(27, 162, width - 54, 2, COLOR_RED);
    draw_text(28, 176, "FIRE DETECTED", 2, COLOR_YELLOW);
    draw_text(20, 204, "EVACUATE NOW", 2, COLOR_WHITE);
    ESP_ERROR_CHECK(lcd_draw_bitmap_locked(0, 0, width, height, framebuffer));
}

static void draw_flood_alarm_screen(float water_mm)
{
    fill_rect(0, 0, width, height, COLOR_BG);
    fill_rect(0, 0, width, 8, COLOR_TEAL);
    fill_rect(0, height - 8, width, 8, COLOR_TEAL);
    fill_rect(8, 8, 4, height - 16, COLOR_TEAL);
    fill_rect(width - 12, 8, 4, height - 16, COLOR_TEAL);
    fill_rect(16, 16, width - 32, height - 32, COLOR_BLUE);
    draw_text((width - (int)strlen("FLOOD ALARM") * 12) / 2, 32,
              "FLOOD ALARM", 2, COLOR_WHITE);
    draw_text(71, 75, "WATER LEVEL", 1, COLOR_TEAL);

    char level[16];
    format_tenths(level, sizeof(level), water_mm);
    strcat(level, " MM");
    draw_text((width - (int)strlen(level) * 18) / 2, 105, level, 3, COLOR_WHITE);
    fill_rect(32, 158, width - 64, 2, COLOR_TEAL);
    draw_text((width - (int)strlen("ENTRY CLOSED") * 12) / 2, 174,
              "ENTRY CLOSED", 2, COLOR_YELLOW);
    draw_text((width - (int)strlen("EXIT STILL OPEN") * 6) / 2, 208,
              "EXIT STILL OPEN", 1, COLOR_WHITE);
    ESP_ERROR_CHECK(lcd_draw_bitmap_locked(0, 0, width, height, framebuffer));
}

static void draw_kaoruko_frame(int frame_index)
{
    if (frame_index < 0 || frame_index >= KAORUKO_FRAME_COUNT)
        return;

    /* Two DMA buffers avoid modifying a buffer that may still be in the SPI DMA queue. */
    uint16_t *dst = gif_framebuffer[gif_buffer_index];
    if (!kaoruko_decode_frame(frame_index, dst,
                              (size_t)GIF_WIDTH * GIF_HEIGHT))
    {
        ESP_LOGE(TAG, "Kaoruko frame %d decode failed", frame_index);
        return;
    }
    /* Frames are stored pre-matted and pre-byte-swapped, so they go straight to the panel. */
    esp_err_t err = gif_draw_bitmap(
        GIF_X,
        GIF_Y,
        GIF_X + GIF_WIDTH,
        GIF_Y + GIF_HEIGHT,
        dst);

    if (err != ESP_OK)
        ESP_LOGE(TAG, "Kaoruko frame %d draw failed: %s",
                 frame_index, esp_err_to_name(err));

    gif_buffer_index ^= 1;
}

static void draw_claude_frame(int frame_index, int x, int previous_x,
                              bool clear_previous)
{
    if (frame_index < 0 || frame_index >= CLAUDE_FRAME_COUNT)
        return;

    if (clear_previous && previous_x != x)
    {
        uint16_t *background = gif_framebuffer[gif_buffer_index];
        for (size_t i = 0; i < (size_t)CLAUDE_WIDTH * CLAUDE_HEIGHT; ++i)
            background[i] = rgb565_byte_swap(COLOR_PANEL);

        esp_err_t clear_err = gif_draw_bitmap(
            previous_x,
            CLAUDE_Y,
            previous_x + CLAUDE_WIDTH,
            CLAUDE_Y + CLAUDE_HEIGHT,
            background);
        if (clear_err != ESP_OK)
            ESP_LOGE(TAG, "Claude clear failed: %s", esp_err_to_name(clear_err));
        gif_buffer_index ^= 1;
    }

    /* Frames are stored panel-matted and pre-byte-swapped. */
    uint16_t *dst = gif_framebuffer[gif_buffer_index];
    if (!claude_decode_frame(frame_index, dst,
                             (size_t)CLAUDE_WIDTH * CLAUDE_HEIGHT))
    {
        ESP_LOGE(TAG, "Claude frame %d decode failed", frame_index);
        return;
    }

    esp_err_t err = gif_draw_bitmap(
        x,
        CLAUDE_Y,
        x + CLAUDE_WIDTH,
        CLAUDE_Y + CLAUDE_HEIGHT,
        dst);
    if (err != ESP_OK)
        ESP_LOGE(TAG, "Claude frame %d draw failed: %s",
                 frame_index, esp_err_to_name(err));

    gif_buffer_index ^= 1;
}

/* The animation buffers (2 x 18 KB with Kaoruko) are the heap SePay's HTTPS handshake needs,
 * so they are given back while a car pays; the animation is paused then anyway. */
static bool gif_buffers_take(bool want)
{
    for (int i = 0; i < GIF_BUFFERS; ++i)
    {
        if (want && gif_framebuffer[i] == NULL)
            gif_framebuffer[i] = heap_caps_malloc(GIF_PIXELS * sizeof(uint16_t), MALLOC_CAP_DMA);
        else if (!want && gif_framebuffer[i] != NULL)
        {
            vTaskDelay(pdMS_TO_TICKS(20)); /* let the last frame's SPI DMA finish (~4 ms) */
            heap_caps_free(gif_framebuffer[i]);
            gif_framebuffer[i] = NULL;
        }
    }
    return gif_framebuffer[0] != NULL && gif_framebuffer[GIF_BUFFERS - 1] != NULL;
}

static void animation_task(void *arg)
{
    (void)arg;
    parking_state_t state = {0};
    int free_count = 0;
    rfid_receipt_t receipt = {0};
    rfid_notice_t notice = {0};
    const int min_claude_x = 8;
    const int max_claude_x = LCD_WIDTH - CLAUDE_WIDTH - 8;
    int claude_x = min_claude_x;
    int last_claude_x = min_claude_x;
    int claude_direction = 1;
    bool claude_visible = false;
    bool claude_frame_drawn = false;

    for (int frame = 0, claude_frame = 0;;)
    {
        parking_state_get(&state, &free_count);
        rfid_session_get_receipt(&receipt);
        rfid_session_get_notice(&notice);
        rfid_payment_t pay;
        rfid_session_get_payment(&pay);
        const bool footer_busy = receipt.valid || notice.valid;
        const bool buffers = gif_buffers_take(!pay.active); /* NULL until the heap allows */
        if (buffers && !state.fire && !pay.active && parking_screen_shown)
        {
            draw_kaoruko_frame(frame);
            if (!footer_busy)
            {
                if (!claude_visible)
                {
                    claude_x = min_claude_x;
                    claude_direction = 1;
                    claude_visible = true;
                }

                claude_x += 2 * claude_direction;
                if (claude_x >= max_claude_x)
                {
                    claude_x = max_claude_x;
                    claude_direction = -1;
                }
                else if (claude_x <= min_claude_x)
                {
                    claude_x = min_claude_x;
                    claude_direction = 1;
                }

                draw_claude_frame(claude_frame, claude_x, last_claude_x,
                                  claude_frame_drawn);
                last_claude_x = claude_x;
                claude_frame_drawn = true;
            }
            else
            {
                claude_visible = false;
                claude_frame_drawn = false;
            }
        }
        else
        {
            claude_visible = false;
            claude_frame_drawn = false;
        }
        uint16_t frame_delay = (state.fire || footer_busy)
                                   ? kaoruko_frame_delay_ms[frame]
                                   : claude_frame_delay_ms[claude_frame] / 2U;
        vTaskDelay(pdMS_TO_TICKS(frame_delay));
        frame = (frame + 1) % KAORUKO_FRAME_COUNT;
        claude_frame = (claude_frame + 1) % CLAUDE_FRAME_COUNT;
    }
}

static void display_task(void *arg)
{
    (void)arg;
    parking_state_t state = {0};
    int free_count = 0;
    bool first_draw = true;
    bool last_received = false;
    bool last_fire = false;
    bool last_online = false;
    bool last_flood = false;
    int fire_frame = 0;
    rfid_receipt_t receipt = {0};
    rfid_receipt_t last_receipt = {0};
    rfid_notice_t notice = {0};
    rfid_notice_t last_notice = {0};
    rfid_payment_t payment = {0};
    rfid_payment_t last_payment = {0};
    int last_slots[PARKING_SLOT_COUNT] = {-1, -1, -1, -1, -1};
    float last_temperature = -1000.0f;
    float last_water = -1000.0f;
    int64_t thanks_until_us = 0;
    bool thanks_shown = false;
    bool last_lot_alarm = false;

    for (;;)
    {
        parking_state_get(&state, &free_count);
        rfid_session_get_receipt(&receipt);
        rfid_session_get_notice(&notice);
        rfid_session_get_payment(&payment); /* also expires an unpaid QR */
        const bool paying = payment.active && !payment.expired;
        const int64_t now_us = esp_timer_get_time();
        /* A new receipt means a car just paid and is leaving: thank them first. */
        if (receipt.valid && memcmp(&receipt, &last_receipt, sizeof(receipt)) != 0)
            thanks_until_us = now_us + THANKS_US;
        const bool thanks = receipt.valid && now_us < thanks_until_us;
        const bool fire_screen = state.received && state.fire;
        const bool flood_screen = state.flood;
        const bool alarm_screen = fire_screen || flood_screen;
        const bool lot_alarm = rfid_session_lot_alarm((uint64_t)now_us);
        /* Pulsed, so it cannot be mistaken for the steady fire and flood alarm. */
        buzzer_set_warning(lot_alarm && (now_us / 1000000) % 2 == 0);

        if (state.fire || first_draw ||
            memcmp(&payment, &last_payment, sizeof(payment)) != 0 ||
            state.received != last_received ||
            state.fire != last_fire ||
            state.online != last_online ||
            state.flood != last_flood ||
            memcmp(state.slots, last_slots, sizeof(last_slots)) != 0 ||
            state.temperature_c != last_temperature ||
            state.water_mm != last_water ||
            memcmp(&receipt, &last_receipt, sizeof(receipt)) != 0 ||
            memcmp(&notice, &last_notice, sizeof(notice)) != 0 ||
            thanks != thanks_shown ||
            lot_alarm != last_lot_alarm)
        {
            const bool parking_screen = !alarm_screen && !paying && !thanks;
            if (!parking_screen)
                parking_screen_shown = false; /* before drawing, so the animation stops first */
            if (fire_screen)
            {
                draw_fire_alarm_screen(fire_frame);
                fire_frame = (fire_frame + 1) % 15;
            }
            else if (flood_screen)
                draw_flood_alarm_screen(state.water_mm);
            else if (paying)
                draw_payment_screen(&payment, &notice);
            else if (thanks)
                draw_thanks_screen(&receipt);
            else
                draw_parking_screen(&state, free_count, &receipt, &notice, lot_alarm);
            parking_screen_shown = parking_screen;
            last_payment = payment;

            memcpy(last_slots, state.slots, sizeof(last_slots));
            last_received = state.received;
            last_fire = state.fire;
            last_online = state.online;
            last_flood = state.flood;
            last_temperature = state.temperature_c;
            last_water = state.water_mm;
            memcpy(&last_receipt, &receipt, sizeof(receipt));
            memcpy(&last_notice, &notice, sizeof(notice));
            thanks_shown = thanks;
            last_lot_alarm = lot_alarm;
            first_draw = false;
        }

        /* Wake at once when new data arrives (lcd_display_notify). Otherwise wake every
         * second to expire the receipt, or every 120 ms to animate the fire screen. */
        ulTaskNotifyTake(pdTRUE, pdMS_TO_TICKS(state.fire ? 120 : 1000));
    }
}

void lcd_display_notify(void)
{
    if (display_task_handle != NULL)
        xTaskNotifyGive(display_task_handle);
}

esp_err_t lcd_display_start(void)
{
#if CONFIG_PARKING_LCD_BL_GPIO >= 0
    {
        gpio_config_t backlight = {
            .pin_bit_mask = 1ULL << CONFIG_PARKING_LCD_BL_GPIO,
            .mode = GPIO_MODE_OUTPUT,
        };
        ESP_RETURN_ON_ERROR(gpio_config(&backlight), TAG,
                            "Configure backlight GPIO failed");
        gpio_set_level(CONFIG_PARKING_LCD_BL_GPIO, 0);
    }
#endif

    /* Allocate the 115.2 KB full-screen framebuffer first, before SPI/LCD driver queues
     * shrink the largest contiguous DRAM region. */
    framebuffer = heap_caps_calloc(
        (size_t)width * height,
        sizeof(uint16_t),
        MALLOC_CAP_DMA);
    if (framebuffer == NULL)
    {
        ESP_LOGE(TAG, "Unable to allocate LCD framebuffer");
        return ESP_ERR_NO_MEM;
    }

    for (int i = 0; i < GIF_BUFFERS; ++i)
    {
        gif_framebuffer[i] = heap_caps_malloc(
            GIF_PIXELS * sizeof(uint16_t),
            MALLOC_CAP_DMA);

        if (gif_framebuffer[i] == NULL)
        {
            ESP_LOGE(TAG, "Unable to allocate GIF DMA framebuffer %d", i);
            return ESP_ERR_NO_MEM;
        }
    }

    spi_bus_config_t bus_config = {
        .sclk_io_num = CONFIG_PARKING_LCD_SCLK_GPIO,
        .mosi_io_num = CONFIG_PARKING_LCD_MOSI_GPIO,
        .miso_io_num = -1,
        .quadwp_io_num = -1,
        .quadhd_io_num = -1,
        .max_transfer_sz = width * height * PIXEL_BYTES,
    };
    ESP_RETURN_ON_ERROR(
        spi_bus_initialize(LCD_SPI_HOST, &bus_config, SPI_DMA_CH_AUTO),
        TAG, "Initialize SPI bus failed");

    esp_lcd_panel_io_handle_t io = NULL;
    esp_lcd_panel_io_spi_config_t io_config = {
        .dc_gpio_num = CONFIG_PARKING_LCD_DC_GPIO,
        .cs_gpio_num = CONFIG_PARKING_LCD_CS_GPIO,
        .pclk_hz = LCD_SPI_CLOCK_HZ,
        .spi_mode = 0,
        .trans_queue_depth = 10,
        .lcd_cmd_bits = 8,
        .lcd_param_bits = 8,
    };
    ESP_RETURN_ON_ERROR(
        esp_lcd_new_panel_io_spi(
            (esp_lcd_spi_bus_handle_t)LCD_SPI_HOST,
            &io_config,
            &io),
        TAG, "Create LCD SPI interface failed");

    esp_lcd_panel_dev_config_t panel_config = {
        .reset_gpio_num = CONFIG_PARKING_LCD_RST_GPIO,
        .rgb_ele_order = LCD_RGB_ELEMENT_ORDER_RGB,
        .bits_per_pixel = 16,
    };
    ESP_RETURN_ON_ERROR(
        esp_lcd_new_panel_st7789(io, &panel_config, &panel),
        TAG, "Create ST7789 panel failed");
    ESP_RETURN_ON_ERROR(
        esp_lcd_panel_reset(panel), TAG, "Reset display failed");
    ESP_RETURN_ON_ERROR(
        esp_lcd_panel_init(panel), TAG, "Initialize display failed");
    ESP_RETURN_ON_ERROR(
        esp_lcd_panel_set_gap(panel,
                              CONFIG_PARKING_LCD_X_GAP,
                              CONFIG_PARKING_LCD_Y_GAP),
        TAG, "Set display offset failed");
    ESP_RETURN_ON_ERROR(
        esp_lcd_panel_invert_color(panel, true),
        TAG, "Set display colors failed");
    ESP_RETURN_ON_ERROR(
        esp_lcd_panel_disp_on_off(panel, true),
        TAG, "Turn display on failed");

    lcd_mutex = xSemaphoreCreateMutex();
    if (lcd_mutex == NULL)
    {
        ESP_LOGE(TAG, "Unable to create LCD mutex");
        return ESP_ERR_NO_MEM;
    }

#if CONFIG_PARKING_LCD_BL_GPIO >= 0
    gpio_set_level(CONFIG_PARKING_LCD_BL_GPIO, 1);
#endif

    if (xTaskCreate(display_task, "lcd_display", 4096, NULL, 4, &display_task_handle) != pdPASS)
    {
        ESP_LOGE(TAG, "Unable to create display task");
        return ESP_ERR_NO_MEM;
    }

    if (xTaskCreate(animation_task, "lcd_animation", 3072, NULL, 3, NULL) != pdPASS)
    {
        ESP_LOGE(TAG, "Unable to create animation task");
        return ESP_ERR_NO_MEM;
    }

    ESP_LOGI(TAG, "ST7789 display started at %dx%d with %d-frame Kaoruko animation",
             width, height, KAORUKO_FRAME_COUNT);
    return ESP_OK;
}
