thinhdinh25/INT3108_embedded-Smart-Parking-Project/Server/main/display/kaoruko_gif.c

#include "kaoruko_gif.h"

#define KAORUKO_PIXELS (KAORUKO_WIDTH * KAORUKO_HEIGHT)

const uint16_t kaoruko_frame_delay_ms[KAORUKO_FRAME_COUNT] = {
    100, 100, 100, 100, 100, 100, 100, 100, 100, 100,
};

/* Frames are pre-processed offline: the white matte around Kaoruko is already
 * black and pixels are already byte-swapped for the ST7789, so the firmware only
 * decodes them. LZSS stream: each flag bit selects a 16-bit literal (0) or a
 * 12-bit backward distance plus 4-bit length match (1). */
static const uint32_t frame_offsets[KAORUKO_FRAME_COUNT + 1] = {
    0, 7187, 14480, 21557, 28672, 35602, 42315, 49300,
    56485, 63570, 70564,
};
static const uint8_t compressed_frames[] = {
    0xFE, 0x00, 0x00, 0x0F, 0x00, 0x0F, 0x00, 0x0F, 0x00, 0x0F, 0x00, 0x0F, 0x00, 0x0F, 0x00, 0x0F,
    0x00, 0xFF, 0x0F, 0x00, 0x0F, 0x00, 0x0F, 0x00, 0x0F, 0x00, 0x0F, 0x00, 0x0F, 0x00, 0x0F, 0x00,
    0x0F, 0x00, 0xFF, 0x0F, 0x00, 0x0F, 0x00, 0x0F, 0x00, 0x0F, 0x00, 0x0F, 0x00, 0x0F, 0x00, 0x0F,
    0x00, 0x0F, 0x00, 0xFF, 0x0F, 0x00, 0x0F, 0x00, 0x0F, 0x00, 0x0F, 0x00, 0x0F, 0x00, 0x0F, 0x00,
    0x0F, 0x00, 0x0F, 0x00, 0xFF, 0x0F, 0x00, 0x0F, 0x00, 0x0F, 0x00, 0x0F, 0x00, 0x0F, 0x00, 0x0F,
    0x00, 0x0F, 0x00, 0x0F, 0x00, 0xFF, 0x0F, 0x00, 0x0F, 0x00, 0x0F, 0x00, 0x0F, 0x00, 0x0F, 0x00,
    0x0F, 0x00, 0x0F, 0x00, 0x0F, 0x00, 0xFF, 0x0F, 0x00, 0x0F, 0x00, 0x0F, 0x00, 0x0F, 0x00, 0x0F,
    0x00, 0x0F, 0x00, 0x0F, 0x00, 0x0F, 0x00, 0xFF, 0x0F, 0x00, 0x0F, 0x00, 0x0F, 0x00, 0x0F, 0x00,
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
};

bool kaoruko_decode_frame(size_t frame_index, uint16_t *pixels, size_t pixel_count)
{
    if (frame_index >= KAORUKO_FRAME_COUNT || pixels == NULL || pixel_count != KAORUKO_PIXELS)
        return false;

    size_t input = frame_offsets[frame_index];
    const size_t input_end = frame_offsets[frame_index + 1];
    size_t output = 0;
    while (input < input_end && output < pixel_count)
    {
        const uint8_t flags = compressed_frames[input++];
        for (unsigned bit = 0; bit < 8 && output < pixel_count; ++bit)
        {
            if (flags & (1U << bit))
            {
                if (input_end - input < 2)
                    return false;
                const uint16_t code = (uint16_t)compressed_frames[input] |
                                      ((uint16_t)compressed_frames[input + 1] << 8);
                input += 2;
                const size_t distance = (code >> 4) + 1;
                const size_t length = (code & 0x0f) + 3;
                if (distance > output || length > pixel_count - output)
                    return false;
                for (size_t i = 0; i < length; ++i)
                    pixels[output + i] = pixels[output + i - distance];
                output += length;
            }
            else
            {
                if (input_end - input < 2)
                    return false;
                pixels[output++] = (uint16_t)compressed_frames[input] |
                                   ((uint16_t)compressed_frames[input + 1] << 8);
                input += 2;
            }
        }
    }
    return output == pixel_count && input == input_end;
}
