thinhdinh25/INT3108_embedded-Smart-Parking-Project/RFIDClient/secrets.example.h

// The shared Wi-Fi the server and both clients join. Copy this file to secrets.h
// (git-ignored) and put your network in it.
#pragma once
static const char *WIFI_SSID = "Parking";
static const char *WIFI_PASSWORD = "12345678";
