thinhdinh25/INT3108_embedded-Smart-Parking-Project/(commit log)

2026-09-24 Blink led example
2026-10-02 Restructure ESP32 server and add client sketch
    This commit moves the embedded server project under Server/ for clearer separation, adds the client-side Arduino sketch for sensor reporting, and trims editor config from the repo root. It also updates the root .gitignore to ignore VS Code settings while preserving project ignore rules for the Server subproject.
2026-10-08 update dashboard UI and display UI, fix rgb565 byte swap logic
    [lcd_display.c]
2026-10-13 update logic of ir sensor
2026-10-20 update request format and servo
2026-10-20 add emergency button
2026-10-29 Update README and add Vietnamese technical report
    Rewrite README to match current firmware (RFID client, auto-closing
    barriers, parking fees, HTTP API) and fix the parking_update example.
    Add LaTeX report source and compiled PDF under report/.
2026-10-30 Reverse parking slot order in sensor client
    Read IR sensors in reverse so the physical IR5 sensor is reported as
    slot S1 and IR1 as S5. Update README and report pin tables to match.
2026-10-30 Speed up server display drawing and build with -O2
    - fill_rect: clip and byte-swap once, then fill rows directly instead
    of bounds-checking every pixel.
    - GIF background removal: alternate forward/backward scans so the
    flood fill converges in 3-6 passes instead of up to 19 (same mask).
    - Enlarge temperature/water text buffers flagged by -O2
    format-truncation checks.
    - Add Server/sdkconfig.defaults selecting performance optimization
    and use it for repo-root builds.
2026-10-30 Add parking.local mDNS, simplify servo, rename clients
    - Server: answer http://parking.local via espressif/mdns on the joined
    Wi-Fi; switch to the 1.5 MB single-app partition to fit it.
    - Servo: drop NVS writes (state is reset to closed on boot anyway),
    replace the 50 ms polling task with one-shot esp_timer auto-close,
    and share one code path for both gates.
    - UDP: log per-packet traffic at DEBUG level only.
    - Rename Client -> SensorClient and Client2 -> RFIDClient; undo the
    duplicate slot-order reversal so S1 reads GPIO16.
    - Update READMEs and the report for the new names and network setup.
2026-10-30 Optimize firmware, add host tests, dashboard lot view, rubric report
    Server:
    - Store animation frames pre-matted and pre-byte-swapped (re-encoded
    offline, identical pixels) and drop the per-frame flood fill.
    - Wake the display task on new data instead of polling every 500 ms.
    - Share JSON scanning helpers between both parsers; one HTTP handler
    for all barrier commands; rename wifi_ap to wifi_sta.
    - Show a 5 s TFT notice for wrong-gate and lot-full scans.
    - Re-announce parking.local over mDNS whenever the IP changes.
    - Dashboard: large parking-lot view as the main element.
    Clients:
    - Sensor Client sends on every debounced change plus a 1 s heartbeat.
    - RFID Client formats UIDs into fixed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
2026-10-30 Fix HTTP accept failures by purging idle connections
    Browsers keep several keep-alive connections and the dashboard polls every
    1-2 s, so all 7 HTTP slots (plus the UDP socket in a 10-socket pool) filled
    up and new clients got "error in accept (23)". Enable LRU purge, allow 10
    HTTP clients and raise CONFIG_LWIP_MAX_SOCKETS to 16.
2026-10-30 Sign UDP packets, ACK RFID scans, persist sessions; update report
    - SipHash-2-4 signed packets with anti-replay window; admin PIN on POSTs;
    Wi-Fi password, key and PIN moved to menuconfig / git-ignored secrets.h
    - RFID scans ACKed by the server and resent by the client until ACKed
    - Sessions, log and parking clock saved in NVS; browser sets real time
    - Periodic climate message; IR cross-check refuses entry when bays are full
    - Host tests: 318 checks
    - Report: physical model photos, fixed limitations, detailed contributions
2026-11-03 Add new model photos and proofread the report
    - Five new photos of the physical model and the live TFT screen
    - Grammar and wording fixes across all chapters
    - Fix stale test count, a use-case step reference and a box label
2026-11-03 Add sensor watchdog, flood alarm, revenue stats; drop UDP signing
    - Sensor Client silent for 3 s shows SENSOR OFFLINE on TFT and dashboard;
    stale data no longer blocks entry
    - Flood alarm at 20 mm (off at 15 mm): buzzer, warnings, entry refused
    - Today / 7-day revenue and visit counts, saved in NVS
    - UDP packets are plain JSON again; RFID scans keep ACK + retry with a
    plain seq field and server-side dedupe of the last 16 seqs
    - Tests: 325 checks; report, diagrams and README updated
2026-11-03 Add VietQR payment via SePay; all boards join one shared Wi-Fi
    - Exit scan shows a VietQR (NAPAS/EMVCo, BIDV) on the TFT; the server polls
    SePay for the matching transfer and opens the exit barrier; operator can
    confirm transfers or cash on the dashboard (PIN)
    - Server, Sensor Client and RFID Client are stations on one shared Wi-Fi;
    clients broadcast to 255.255.255.255
    - Payment settings in menuconfig (git-ignored sdkconfig); TLS dynamic buffers
    - Tests: 384 checks; report, diagrams and README updated
2026-11-03 Fix merge conflict, drop leaked SePay defaults, require payment to exit
    - Resolve conflict markers in Kconfig.projbuild that broke the build
    - Clear the SePay token and account number from Kconfig defaults
    - Clients broadcast to WiFi.broadcastIP() so any subnet size works
    - Exit barrier never opens on a scan alone: with no QR account the TFT
    shows PAY AT BOOTH and the operator confirms on the dashboard
    - Remove a UTF-8 BOM from lcd_display.c
2026-11-03 Free RAM for the SePay TLS handshake
    The handshake failed with alloc(4770) next to the 115 KB framebuffer.
    Keep Wi-Fi RX/TX and log code in flash instead of IRAM (static DRAM
    118.4 KB -> 98.6 KB), use 6 static and at most 16 dynamic Wi-Fi buffers,
    and log free heap and largest block when a SePay request fails.
2026-11-03 Turn the Kaoruko GIF off by default to free heap for SePay HTTPS
    New menuconfig switch PARKING_LCD_KAORUKO (default off) keeps the code.
    With it off the animation DMA buffers fit only the Claude sprite, which
    frees about 24 KB of heap; a P tile fills the corner instead.
2026-11-03 New full-width TFT main screen and 5 s THANK YOU screen after payment
    - Main screen without Kaoruko: big free-space count, stacked temperature and
    water cards, one driver status line, larger S1-S5 bays; the old layout
    stays behind PARKING_LCD_KAORUKO
    - THANK YOU screen for 5 s after a paid exit while the barrier opens
    - Report shows the screens rendered from lcd_display.c on the host
2026-11-03 Restore the Kaoruko main screen; free its buffers while a car pays
    - Revert the full-width main screen to the previous layout; Kaoruko is on
    by default again (PARKING_LCD_KAORUKO=y). The THANK YOU screen stays
    - The animation task frees the 2 x 18 KB GIF DMA buffers while a payment
    is active (the animation is paused then) so SePay's HTTPS handshake has
    the heap, and allocates them again afterwards
    - Report figure re-rendered from lcd_display.c
2026-11-03 Always build the Kaoruko animation; drop its menuconfig switch
    A board flashed from an sdkconfig saved while the switch defaulted to off
    still showed the P tile. The switch only existed to save heap for SePay,
    which freeing the GIF buffers during payment now covers.
